ZLK-AllStar/2026GongChuang/上位机联动说明.md

# 下位机与上位机联动说明

更新：2026-10-30。固件采用 CoreXY 与六槽单方向托盘，视觉上位机 Python、标定、服务脚本、重试与超时保持原样。

## 接线与启动

| 用途 | 接口 | 参数 |
|---|---|---|
| 视觉上位机 | USART2 PA2=TX / PA3=RX | 115200 8N1，共地，TX/RX 交叉 |
| 三台 Emm_V5 电机 | USART1 PA9/PA10 | 保留本工程 DMA+IDLE，地址 1/2 为 M1/M2，3 为托盘 |
| ApusIDE HMI | USART3 PB10=TX / PB11=RX | 115200 8N1，屏端 COM2 |
| 调试 Shell | UART5 PC12=TX / PD2=RX | 115200 8N1，仅 DEBUG |
| 按键 | PE2 与 GND 之间 | 上拉、低电平按下，5 ms 采样 / 20 ms 消抖 |
| LED | PF9=LED0 / PF10=LED1 | 低电平亮 |

上电后 LED0 快闪完整 3 秒。窗口内消抖确认按下选 DEBUG，否则选 HOST；上电长按同样有效，窗口末不足 20 ms 不生效，模式锁定至复位。选择完成后才进行屏幕/舵机/电机初始化。XY 与托盘的当前机械位置建立为软件原点，不找限位、不主动回机械原点。初始化失败保留明确故障，HOST 拒绝机械任务，DEBUG 仍可诊断。

HOST 模式 LED0 常亮，须在初始化后先稳定释放 PE2，再新按一次才向上位机发 PRESS。窗口内或初始化期间的按住不伪造成生产启动键。DEBUG 模式 LED1 常亮，不初始化 HOST 触发流程，不接受 HOST 机械任务。首次 PE2 启动后保持连续识别，运行中再按不切换模式。

## 原 USART2 字节协议

| 方向/消息 | 固定格式 |
|---|---|
| HOST 抓取 | AA 55 01 SEQ CMD X_L X_H Y_L Y_H SUM8 |
| HOST 启动/心跳 | AA 55 02 00 01 SUM8 |
| MCU 在线 | 55 AA 02 00 01 SUM8 |
| MCU 按键 | 55 AA 82 SEQ STATE SUM8 |
| MCU 状态 | 55 AA 81 SEQ STATUS SUM8 |

SUM8 为前面所有字节求和低 8 位；X/Y 为 uint16 小端毫米。PRESS=1、RELEASE=0，与按键硬件电平相互独立。状态保持 ACK=1、BUSY=2、DONE=3、FAILED=4、OUT_OF_RANGE=5。CMD 的原九色仍为 shape_index*9+color_index+1（1..72）；白色 color_index=9 独立编码为 73+shape_index（73..80），圆锥shape_index=8独立编码为81+color_index（81..90），整体有效范围1..90。

启动通知仅更新在线提示，不放行运动。HOST 每秒发送原通知，MCU 等通知时每秒发送在线帧，5 秒未收到有效 HOST 帧显示离线。正常空闲提示从 WAIT PC 变成 WAIT BUTTON；故障优先显示。Jetson ACK 超时 1 秒、一次重发、完整动作超时 24 秒；固件任务预算从 ACK 起为 24000 ms（包含回 HOME）。

## 执行、分类与故障

固件检查 CMD、X=0..215 / Y=0..205 mm、原点/配置与完整任务键。上位机坐标直接使用，没有旧的 X/Y 同大于 80 时各减 10 mm 分支。

合法任务先 ACK，code 首次出现分配 ID1..6，下一新类循环 ID1；同类记住原 ID，失败也不回退映射，复位清空。ID1..6 对应托盘 0/60/120/180/240/300°。固定单方向，300→0 继续转 60°，0→300 不反转。

顺序为：抬杯 → 托盘到位 → CoreXY 到原始抓取坐标 → 按形状降低并吸取 → 抬杯 → 固定 Release → 保持抬杯释放 → HMI 分类记录 → HOME 停靠 → DONE。Release 和 HOME 在 app_config.h 中分别配置，初值都为 (0,0)。长方体降低到 FULL，其他形状普通 DOWN；保留当前舵机和真空等待时间。

仅保存活动任务和最近终态，以 (SEQ,CMD,X_raw,Y_raw) 去重。活动同任务回 BUSY，活动期间不同任务回 FAILED，不排队；最近已完成同任务只补终态。SEQ 回绕后内容不同可作为新任务，不重复分配、抓取或追加 HMI。

HOST 解析在等待点继续服务，接收环 256 字节，溢出计数并清理残帧。总体超时由拥有电机事务的前台停止两组电机、使原点失效并发 FAILED，服务钩子不重入电机总线。托盘失败不继续吸取；取料后 XY 故障不盲目泄压。已释放后的停靠失败仍保留 HMI 记录，但返回 FAILED。HMI 本地发送失败只记通信错误，不重做机械动作。

## HMI 与调试

ST7789 只显示模式/任务/位置/原点/真空/托盘/通信诊断。指定 ApusIDE HMI 承担分类图片和 ID 历史，原 72 码映射不变，追加原8形状白色73..80与圆锥10色81..90（docs/圆锥系列几何体映射.md）；详见 docs/下位机白色几何体映射.md。生产使用带 CRC 的 22 字节帧，单字节仅调试预览；两端须同步升级，无 ACK、无掉线补发或断电历史恢复。详见屏幕联动说明.md。

UART5 命令及首次标定步骤见 docs/调试与首次上机.md。上位机服务入口仍为 classic-new/scripts/run_vision.sh；手动调试 `scripts/run_vision.sh --debug`，日志 `journalctl -u huatai-vision -f`。保持原摄像头、标定与 systemd 配置。

构建、自动测试和实机待测边界见 docs/机械架构变更验证记录.md。

## 2026-11-08 识别选择与工作空间

Jetson 实际运行脚本为 `/home/jetson/classic/cv2_copy.py`，本地同步副本为 `上位机脚本/cv2_copy.py`。每轮从有效、未处于失败冷却的目标中，按长方体 > 正方体 > 五棱柱 > 圆柱 > 圆锥 > 三棱锥选择；三棱锥对应协议条目 `regular_tetrahedron`。同类继续比较空旷度和移动距离，稳定后发送单个目标，等待 DONE 再识别。

上位机筛选、HOST 校验、CoreXY 运动和 DEBUG Shell 均采用 X=0..215 mm、Y=0..205 mm，包含边界。上位机像素转机械坐标时，若有限的 Y 超过 `MACHINE_Y_MAX_MM=205.0`，直接输出 205 mm；目标显示、筛选、锁定和发送使用限幅值，串口封包也做上限保护。X 越界、负坐标与非有限值仍按原有效性规则处理；下位机直接收到 Y>205 的任务仍返回 OUT_OF_RANGE。抓取帧仍为原 10 字节格式，形状/颜色指令编号不变。

圆柱系列所有颜色（CMD 37..45 和白色 77）取料时单独下降到 130°，由 `AUX_SERVO_LIFT_DOWN_ANGLE_CYLINDER` 配置；下降成功后才启动吸取，再抬杯。其他物料的下降预设及当前释放动作保持各自配置。
