ZLK-AllStar/2026GongChuang/docs/Y205上限与限幅验证记录.md

# Y=205 mm 上限与上位机限幅

日期：2026-11-09。

- 固件 `XY_STAGE_Y_MAX_MM` 从 225 改为 205；HOST、Release/HOME 配置检查、CoreXY 绝对/相对运动与 DEBUG Shell 共用此宏，Shell 提示同步为 X=0..215 / Y=0..205 mm。
- 主上位机和本地、Jetson 备用识别脚本使用 `MACHINE_Y_MAX_MM=205.0`。像素转换校验有限值后，将 Y>205 截为 205；显示、选择、锁定、发送和重发使用限幅坐标。封包在取整前再次保护上限；下位机直接收到 Y>205 的帧仍返回 OUT_OF_RANGE。
- 主脚本本地、Jetson 暂存和已安装版本均通过 1684 项检查，覆盖原优先级/24秒/90码映射及 Y=205/205.01/206/225/超uint16/非有限值。实际 process_frame → 稳定目标 → 模拟串口 → 重发，验证原始 Y=206 输出为 205。备用脚本实际转换/封包函数检查通过。
- 机械回归全部通过：HOST 11 场景、全90码/圆柱130°、Shell边界、2889 项 CoreXY 检查、软件串口与指定 HMI 解析器。新角点 (215,205) 对应 M1=33600、M2=800 脉冲，Y=205.01/206/旧225均拒绝。备用上位机按键回归全部通过。
- Jetson 备份：`/home/jetson/classic/backups/20261109-y205-1794206890918033800`。主脚本 SHA256=`3ec681482ae8ee624fa419e9d74c513a9358105c821c5555b2177fa450e5313e`。部署前核对旧脚本哈希，暂存检查通过后停止服务、替换、验证并重启。
- 部署后服务 active/running，PID=5633、NRestarts=0；日志确认模型、标定和串口加载完成，处于 WAIT_BUTTON。标定和 ROI 的 SHA256 在部署及重启后保持一致，证据位于 `MDK-ARM/MechanicalVerify/y205-20261109/`。
- 固件**未烧录**，未触发机械运动或清零。STM32 新上限须烧录后生效；Release=(215,105)、HOME=(0,0)、24秒预算与圆柱130°预设保留。

Keil ARMCC 5.06 update 7 build 960，target HUATAI，全量重建结果：

- BUILD_RESULT: SUCCESS
- ERROR_COUNT: 0
- WARNING_COUNT: 0
- ERRORS: none
- WARNINGS: none
- FULL_LOG: `MDK-ARM/build_y205_20261109.log`

固件：`MDK-ARM/HUATAI/HUATAI.hex`。
SHA256：`71c124b0e8f5c35366cf40759e51c5c1d44b46038900be3671b0a415e44d715f`。
