ZLK-AllStar/2026GongChuang/docs/下位机白色几何体映射.md

# 下位机白色几何体与 HMI 映射

日期：2026-11-08。
目标 HMI：`D:/BaiduNetdiskDownload/ApusIDE2_v20250930/ApusIDE2_v20250930/workspace/TEST`。

### 白色追加码（2026-11-08）

白色的 color_index=9；编码使用独立追加区 `code=73+shape_index`。
原有 1..72 的九色公式保持不变，不能把原公式中的乘数 9 改为 10。

| 十进制 code | 十六进制字节 | 形状 | 图片路径 |
|---|---|---|---|
| 73 | 0x49 | 正四面体 | ./images/RT-WHITE.png |
| 74 | 0x4A | 三棱柱 | ./images/TP-WHITE.png |
| 75 | 0x4B | 五棱柱 | ./images/PP-WHITE.png |
| 76 | 0x4C | 六棱柱 | ./images/HP-WHITE.png |
| 77 | 0x4D | 圆柱形 | ./images/CY-WHITE.png |
| 78 | 0x4E | 长方体 | ./images/CB-WHITE.png |
| 79 | 0x4F | 正方体 | ./images/CU-WHITE.png |
| 80 | 0x50 | 球体 | ./images/SP-WHITE.png |

新增 PNG 均为 400×400、RGB、不透明黑底、白色带明暗立面；从原 GRAY 资源派生，保留形状轮廓与方向。
可查看工程根目录 `白色几何体预览.png` 与 `白色几何体映射.csv`。
MCU `Core/Inc/hmi_codes.h` 和 HMI `src/hmi_codes.h` 为相同映射实现，回归会核对字节一致。

白色同时支持单字节预览与原 22 字节生产帧的 D6 字段；版本、帧长、CRC、ID1..ID6 循环和记录去重规则不变。
HOST 的 CMD 也接受 73..80；视觉识别 Python 本次未修改，发送端识别白色后须按追加表发码。

## 联调与交付

DEBUG Shell 使用十进制 `hmi 73` 至 `hmi 80`，仅预览，不产生机械动作或生产记录。
串口助手使用 HEX 单字节 `49` 至 `50`，不要把十进制 73 输入为 HEX 73。

生成白色生产记录测试帧（不指定 --port 时不发送）：

```powershell
python -X utf8 tools/hmi_frame_test.py --record 73 1 --seq 1
python -X utf8 tools/hmi_frame_test.py --record 80 2 --seq 2
python -X utf8 tools/make_hmi_white.py
```

HMI 源码、8 张新 PNG、预览图与 CSV 已写入指定工程。ARM 库与 Windows 模拟器 DLL 编译通过后同步至该工程的 `Release/libbootpanel.so`、`Debug/libbootpanel.dll`；板端尚未部署。
升级屏端需同时打包库和 `images/*-WHITE.png`；MCU 也需更新固件以支持 HOST/Shell/记录的 73..80。
ApusIDE 中对工程执行 F5 刷新，再 Clean / Build，避免外部修改后复用旧对象。

## 验证结果

- 实际 MCU 编码与 HMI 解析：80 种形状颜色逐一双向映射、旧 72 码不变，白色预览/生产帧可解析，0/81 非法码被拒绝。
- 实际 HOST 解析/任务控制：八种白色可进入任务并发出正确记录；重复任务不重做动作，80 类 ID 分配和重查通过。
- Shell：73/80 预览可发送，81 被拒绝；原输入损坏与 busy 保护通过。
- 实际 Wcmn 方法体：八种白色状态、颜色文字、UI 线程边界及非法帧回归通过。
- 八张 PNG：400×400、不透明 RGB、四角黑色；原图片 SHA256 与修改前快照逐一相同。
- `python -X utf8 tools/selftest_mechanical.py`、`python -X utf8 tools/selftest_hmi_worker.py` 通过。
- HMI ARM 和 Windows 模拟器 DLL 编译链接通过。
- Keil ARMCC 5.06 update 7 build 960 全量重建：0 Error(s), 0 Warning(s)。
- 尚待屏端实测：USART3/COM2 接收、黑底白色显示和实际部署后的 8 码逐一预览。

构建日志：`MDK-ARM/MechanicalVerify/white_series_fw_rebuild.log` 与 `MDK-ARM/MechanicalVerify/hmi_arm/build.log`。
修改前备份：`MDK-ARM/MechanicalVerify/white_series_backup/20261108-102422/`。
