ZLK-AllStar/2026GongChuang/docs/机械架构变更验证记录.md

# 机械架构变更验证记录

日期：2026-10-30（Asia/Shanghai）。状态：固件/指定 HMI 已实现；构建和离线模拟通过，实机验收未执行。未烧录、未部署、未创建提交。

## 构建结果

| 项目 | 真实结果 |
|---|---|
| Keil 工程/target | MDK-ARM/HUATAI.uvprojx / HUATAI |
| 编译器 | ARMCC 5.06 update 7 build 960，uAC6=0，C99 |
| 最终全量命令 | D:/Keil_v5/UV4/UV4.exe -r <FW>/MDK-ARM/HUATAI.uvprojx -t HUATAI -j0 -o <FW>/MDK-ARM/build_mechanical_migration.log |
| BUILD_RESULT | SUCCESS |
| ERROR_COUNT / WARNING_COUNT | 0 / 0（无遗留诊断） |
| ERRORS / WARNINGS | 无 / 无 |
| FULL_LOG | C:/Users/ZLK/Downloads/HUATAI (1)/HUATAI-NEW/MDK-ARM/build_mechanical_migration.log |
| Code/RO/RW/ZI | 47408 / 2848 / 412 / 88716 字节 |
| IRAM1 | 89128 / 114688 字节，余 25560 字节 |
| IRAM2 | 16384 字节未用 |
| 栈/堆 | 4096 / 512 字节 |
| TFT_FrameBuffer | 内部普通 SRAM，76800 字节 |
| DMA RX / RX Queue | 0x20013EEB / 0x20013FEA，255 / 2040 字节，未移入 CCM |
| Shell 编辑/历史缓冲 | 512 字节；5 历史+1 编辑槽，每槽85字节，单行最多84字节 |
| HMI 指定工程 | D:/BaiduNetdiskDownload/ApusIDE2_v20250930/ApusIDE2_v20250930/workspace/TEST |
| HMI 编译器 | Linaro arm-linux-gnueabihf-g++ 6.3.1，-O3 -fPIC -std=c++11 -Wall |
| HMI 链接 | 四个应用 cpp 全部编译，libstt_core + pthread/dl/stdc++，0错误/0警告 |
| HMI 输出 | MDK-ARM/MechanicalVerify/hmi_arm/libbootpanel.so，readelf 确认 ELF32/ARM/EABI5/hard-float/DYN |
| HMI FULL_LOG | MDK-ARM/MechanicalVerify/hmi_arm/build.log |

Keil 最后一次全量重建包含 Shell busy/idle 与 HOST damaged-ring 状态的短临界区修复。以新日志最终汇总和链接 map 为证据，不用 GUI 进程返回码。静态调用图最大已知链为 792 字节，但有函数指针/循环及中断未知项；4 KB 栈预留尚需板上高水位验证，不能当作动态最坏栈证明。

本地启动汇编只调整可配置 Stack_Size 0x400→0x1000；这是为 Shell/诊断扩大应用栈预留的适配，没有迁移 REF 启动代码或改变向量/复位逻辑。生成 C/H 的非 USER CODE 区逐字比对一致，.ioc 不变，未运行 CubeMX。classic-new 只改 SERIAL_PROTOCOL.md，Python、标定和服务脚本无 diff。

## 自动化结果

`python -X utf8 tools/selftest_mechanical.py`：ALL MECHANICAL REGRESSIONS PASSED，实际包含/编译最终 FW C，HMI 使用指定工程 src/HmiRecord.h（不是仓库 TEST/ 副本）。

| 组 | 覆盖与结果 |
|---|---|
| CoreXY | PASS 2435 checks：表中脉冲值、负M2、绝对零、相对移动/45°保持轴、NaN/Inf/边界/取整、双反馈原子提交、清零拒绝/无ACK/偏移、旧到位包、堵转、读失败、同步启动失败 |
| 启动/按键 | PASS：不按/短按/上电长按、抖动、3秒边界不足20ms无效、稳定释放、tick回绕 |
| 托盘 | PASS：0→300/300→0/120→60、同角/360不动、100圈六步累计无取整漂移、非法角、反向反馈、旧到位ACK、堵转/超时/失配/读失败、任务预算、清零拒绝、反馈字段溢出前拒绝 |
| HOST 0 | PASS：未新按键不运动，非法CMD/CRC/范围不分配、原帧/状态值、先ACK、原坐标100/100不偏移、先托盘后拾取、固定Release、六ID循环/旧类记忆、SEQ回绕、RX溢出恢复 |
| HOST 1 | PASS：活动同任务只BUSY、不同任务FAILED、最终重发无重复动作/记录 |
| HOST 2 | PASS：托盘失败不抓取，映射保留 |
| HOST 3 | PASS：释放后停靠失败FAILED但HMI记录保留 |
| HOST 4 | PASS：整体预算超时、前台停止、两组原点失效 |
| HOST 5 | PASS：ACK本地发送失败，重发不重复机械动作 |
| HOST 6/7 | PASS：DEBUG不放行HOST、24秒预算tick回绕 |
| HOST 8 | PASS：模拟三段运动中持续心跳，无RX静默溢出 |
| HOST 9 | PASS：HMI发送失败计数，真实机械DONE，不重抓/重记录 |
| HMI | PASS：MCU实际编码+HMI实际解析、CRC123456789、指定22字节样例、首尾code/ID、全部拆包点、连续/重复类顺序、坏CRC/编码/版本/type/字段、噪声、半帧超时、预览独立、tick回绕 |
| Shell | PASS：实际Letter Shell/命令/端口；argc、数字完整消费、NaN/Inf/范围、十进制HMI、84字节上限整行丢弃、RX溢出、忙时输入不延后执行、UART恢复、HOST禁止动作 |

`python -X utf8 tools/selftest_host_link.py` 为兼容入口，执行当前真实 parser/controller/pick_place，不再提取旧 main HOST 分支。`python classic-new/scripts/selftest_button_logic.py` 原样回归：ALL CHECKS PASSED。

CoreXY 附带 ARMCC/Unicorn 脚本能完成 ARMCC 编译链接，但当前 Python 无 unicorn，未安装依赖、未宣称 Unicorn 运行通过；本次 2435 checks 来自 GCC 原生执行最终 C。Shell 原生 MinGW 回归用 -mno-ms-bitfields 对齐 ARMCC/GCC 位域布局；实际 ARMCC 工程静态表另经全量构建验证。离线 mock 不模拟真实 UART DMA 中断竞争、皮带动力学或电机加减速。

HMI 解析顺序有自动覆盖；真实框架 UI onFinished 线程、页面重开/clearOptions、256条淘汰和图片呈现只完成源码核对和 ARM 构建，未运行真实屏端。不得将这些描述为实机UI通过。

## 最终参数与未实测项

| 项目 | 配置 / 实机状态 |
|---|---|
| CoreXY | 80pulse/mm，0..215/0..205mm；M1/M2正向=1，待核实安装方向/实际每mm |
| 托盘 | 地址3，3200pulse/rev，65536units/rev，传动比1.0，正向=1，20pulse容差；待核实额外传动比、观察面方向、零槽/余量 |
| Release/HOME | 独立宏初值(0,0)/(0,0)，待核实固定释放点和高度 |
| 真空/升降 | TIM1/TIM3，50Hz；吸取1500ms、泄压2000ms、升降1000ms不缩短，待核实实物安全时序 |
| GPIO/模式 | PE2上拉低有效，PF9/PF10低有效，窗口3000ms、半周期100ms；待电平/示波测量 |
| HOST时限 | 24000ms预算，上位机完成等待24秒；正常ACK<100ms及完整周期<24s尚待串口抓包测量 |
| HMI | 22字节CRC，无ACK/重发/补历史/持久化；待双端部署与实屏联调 |
| 栈与连续负载 | 4KB；待高水位、最坏中断嵌套、持续识别和错误注入实测 |

实机矩阵全部待测：LED/PE2/UART5接线；启动边界；DEBUG电机断线诊断；低速XY三方向/比例；托盘六槽多圈/单方向；lift/vacuum/释放高度；HMI预览与记录/重开/淘汰；HOST七类/去重；断线/超时/无假DONE；ACK和总周期耗时。步骤见调试与首次上机.md。未连接硬件，未烧录或部署。

## 审查与文件归属

新增应用：app_config、board_io、app_mode、app_runtime、classification、app_controller、shell_port、shell_commands、hmi_protocol；改造xy_stage/tray_motor/pick_place/vacuum/aux_servo/host_link/hmi_link/app_display/button。main仅保留初始化和HOST/DEBUG入口，移除旧盒坐标/遍历/65mm往返活动分支。Keil加入7个应用c和shell.c/shell_ext.c，唯一静态命令表在shell_commands.c。

实际生效配置为 letter-shell-3.1.2/src/shell_cfg.h：TASK_WHILE=0、CMD_EXPORT=0、MAX_NUMBER=1、GET_TICK=HAL_GetTick、PARAMETER_MAX=8、PRINT_BUFFER=128，exec/伴生/锁/动态分配扩展关闭。未编译原shell_cmd_list.c或FreeRTOS demo；保留本地许可证。

HMI原文件快照：MDK-ARM/MechanicalVerify/hmi_baseline/；指定HMI只改应用源/头和新增说明，不改lib/、图片和createParts。FW已有未跟踪TEST/、图片、IDE文件、旧日志与Shell目录未清理；本轮未提交。构建产物与新日志均忽略。

## 2026-11-08 识别优先级与 X=215 mm 边界

- Jetson 交付脚本：`/home/jetson/classic/cv2_copy.py`；本地同字节副本：`上位机脚本/cv2_copy.py`。SHA256：`706fc36f31cb7c42d74c4d9c05db19358131a81c436f41bd53faa47b255c8a93`。
- 原脚本及自测备份：`/home/jetson/classic/backups/20261108-x215-priority-180509/`。
- 优先级：长方体 > 正方体 > 圆柱 > 五棱柱 > 圆锥 > 三棱锥（协议 `regular_tetrahedron`）。先过滤无效/越界/失败冷却目标，再按形状排序，同类沿用几何评分。10 字节抓取帧和原 90 个指令映射不变。
- 上位机、HOST、CoreXY、Shell 均接受 X=215 mm；拒绝 X=215.01 mm（浮点入口）/216 mm（整数串口入口）；Y 上限仍为 225 mm。
- `python -X utf8 tools/selftest_cv2_copy.py`：本地通过 1653 项；在 Jetson 的 `yolov8_env` 中对已安装脚本运行相同自测亦通过。覆盖红/白两色的各 720 个目标排列、全部六级优先级、连续六轮真实状态机/模拟 UART 下发、X=215 保真、失败冷却、同类几何评分和旧协议/按键/超时回归。
- `python -X utf8 tools/selftest_mechanical.py`：所有组通过，包含 HOST 十场景、Shell 新边界和 3151 项 CoreXY 检查；HMI 采用指定外部交付工程的解析器。
- `python classic-new/scripts/selftest_button_logic.py`：全部通过。
- Keil ARMCC 5.06 update 7 build 960，target HUATAI，`-r` 全量重建；成功链接并生成 `MDK-ARM/HUATAI/HUATAI.hex`。

```text
BUILD_RESULT: SUCCESS
ERROR_COUNT: 0
WARNING_COUNT: 0
ERRORS: none
WARNINGS: none
FULL_LOG: MDK-ARM/build_x215_priority_20261108.log
```

上述测试使用模拟 UART/HAL，未驱动实机运动；新固件尚未烧录到 STM32，实际 215 mm 行程仍需烧录后验收。

Jetson 已重启 `huatai-vision.service` 并核对新进程：PID=10660，active/running，NRestarts=0；日志确认权重、标定、USART 和 ROI 加载完成，停在 WAIT_BUTTON，未触发实机抓取。

## 2026-11-08 全链路整任务超时统一为 24 秒

- 固件 `APP_HOST_TASK_BUDGET_MS=24000U`，覆盖从 ACK 前建立任务到回 HOME 完成的整个周期；Release `(215,105)`、HOME `(0,0)` 和现有机械等待保持当前配置。
- Jetson `/home/jetson/classic/cv2_copy.py` 的 `--pick-timeout` 默认 `24.0`；同目录 `_cv2.py` 备用入口、本地三个识别脚本的默认值同步为 24 秒。1 秒 ACK 超时、一次重发及电机/UART 单事务检测维持原配置。
- Jetson 更新前备份：`/home/jetson/classic/backups/20261108-timeout24-195106/`。
- 主识别脚本 SHA256：`71cdb66d76821b127b05cb18e414a5a3f04fe7d5ba1d93984b1c68164e5303c4`；远端部署前后均通过 1659 项模拟 UART 自测，覆盖 18/20/23.999 秒仍等待、24 秒超时、边界已排队 DONE 优先处理、优先级和 X=215 边界。
- `tools/selftest_mechanical.py` 所有组通过：HOST 扩展至 11 个场景，验证超过 23 秒仍可完成、24 秒硬截止、tick 回绕和既有错误/去重/原点保护。CoreXY 3151 项通过。
- `classic-new/scripts/selftest_button_logic.py` 全部通过。
- 使用 ARMCC 5.06 update 7 build 960 对 HUATAI 全量重建并成功链接、生成 HEX。

```text
BUILD_RESULT: SUCCESS
ERROR_COUNT: 0
WARNING_COUNT: 0
ERRORS: none
WARNINGS: none
FULL_LOG: MDK-ARM/build_timeout24_20261108.log
```

固件产物为 `MDK-ARM/HUATAI/HUATAI.hex`，尚未烧录；新 24 秒完整机械周期仍需实机验收。已存在的原点失效状态需要正确重新建立，修改等待时间不会恢复机械原点。

Jetson 已重启 `huatai-vision.service`：PID=8000，active/running，NRestarts=0。按运行进程实际命令行解析得到 `pick_timeout=24.0`，模型、标定、USART、ROI 已就绪，等待 PE2。HEX SHA256：`3c455b5daf8c736f83f3279db7aea2d121884b27082655d4e94502d4cb8375c3`。

## 2026-11-08 五棱柱/圆柱优先级与圆柱 130° 取料

- 当前识别选择顺序：长方体 > 正方体 > 五棱柱 > 圆柱 > 圆锥 > 三棱锥。仅交换五棱柱与圆柱的抓取优先级；串口/HMI 形状编号仍按原表。
- Jetson 主脚本 `/home/jetson/classic/cv2_copy.py` 与本地 `上位机脚本/cv2_copy.py` 同步；SHA256：`245e131e170c86c9707e36818286db18488c4afedd114d8793c529251a7a6e18`。
- 远端原脚本与自测备份：`/home/jetson/classic/backups/20261108-cylinder130-priority-211239/`。
- 新增 `AUX_SERVO_LIFT_DOWN_ANGLE_CYLINDER=130U`，`PickPlace_LowerCup()` 按 `HMI_SHAPE_CYLINDER` 调用 `AuxServo_LiftTo()`，覆盖全部圆柱颜色（CMD 37..45、白色 77）。普通/FULL 当前仍为 100°，抬杯 270°、稳定等待 1000 ms、释放动作、X=215 和 24 秒预算保留当前配置。
- `tools/selftest_cv2_copy.py` 本地及 Jetson 暂存/已安装脚本均通过 1659 项：红/白两组各 720 个排列、逐级选择、连续六轮实际状态机/模拟 UART，24 秒与 X=215 边界。
- `tools/selftest_mechanical.py` 全部通过：真实 HOST 解析/控制器/拾放对 90 个指令码逐一执行并检查下降角度；全部十色圆柱均为 130°，重复帧不重做，下降失败不启动吸取/不产生释放记录。真实舵机实现验证 130° -> CCR=1462（1 us/tick），保持稳定等待、角度缓存与再抬杯。其余 HOST/Shell/CoreXY/HMI 回归通过。
- ARMCC 5.06 update 7 build 960，HUATAI 全量重建，成功链接并生成 HEX。

```text
BUILD_RESULT: SUCCESS
ERROR_COUNT: 0
WARNING_COUNT: 0
ERRORS: none
WARNINGS: none
FULL_LOG: MDK-ARM/build_cylinder130_priority_20261108.log
```

`MDK-ARM/HUATAI/HUATAI.hex` SHA256：`4c9af6ba2bf8d0d0141a0473dbb5f921a8c03173ee03ff6e653c262d6ef003e2`。尚未烧录；130° 的实机接触高度与吸取效果待验证，模拟测试不代表机械验收。

Jetson 服务已重启：PID=12676，active/running，NRestarts=0，日志确认模型、标定、USART 和 ROI 已加载，当前 WAIT_BUTTON。导入部署脚本验证完整新优先级、24 秒完成等待和 X=215 上限。
