ZLK-AllStar/2026GongChuang/屏幕系统说明.md

# ST7789 调试屏系统

更新：2026-10-30。ST7789 横向 320×240 RGB565 只显示调试信息；分类图形和生产历史由 USART3 ApusIDE HMI 显示。本地不再有活动几何列表入口，也不从 HMI_SendCode 驱动本地几何绘制。

## 硬件与缓冲

SPI1：PA5=SCK、PA7=MOSI；PF12=DC、PB12=BLK、PB13=CS、PB15=RST。PA6 是 TIM3 升降 PWM，不能接为屏幕 MISO。背光高有效。保持阻塞 HAL_SPI_Transmit，不使用 DMA。

Core/Src/ext_sram.c 保留历史文件名，但 TFT_FrameBuffer 实际位于内部 SRAM，320×120×2=76800 字节；ExtSram_Init 是空实现。SCREEN_FSMC_ENABLE=0，不配置外部 SRAM/FSMC，PE2 不与 FSMC_A2 冲突。

每次按 y=0..119、120..239 两块视口绘制并刷新全屏。ST7789 硬复位后配置 SWRESET、SLPOUT、RGB565、MADCTL=0xA0（相对原 0x60 横屏旋转 180°）、INVERT ON、DISPON；由应用 Screen/TFT 驱动负责，不改 CubeMX 或 .ioc。Screen_Write/Screen_SetWriteBackend 仍为传输抽象接口。

## 调试页面与服务

SCREEN_PAGE_SELECT 固定 0。显示 HOST/DEBUG、当前动作/故障、XY 实际/目标、原始 HOST SEQ/CMD/X/Y、真空状态、托盘相位与 ID、XY/托盘原点有效性、HOST 在线、HMI 错误数及升降角。

setters 仅更新有界缓存并标记 dirty，命令和状态字符串内部复制；栈上临时字符串可以安全传入。AppDisplay_Service 至少间隔 APP_DISPLAY_PERIOD_MS=100 ms 才刷新；没有主动 dirty 时每 500 ms 更新诊断。初始化检查及服务防重入支持早期模式选择和阻塞等待。

HAL_Delay 只有 app_display.c 一个强定义，调用 AppRuntime_Service。该服务仅解析/回复 HOST 和刷新显示，不执行 Shell 或启动第二个运动任务。SysTick 使用 HAL 1 ms，TIM13 不启动。

## 分类素材与验证

本地 geometry_assets/tft 绘图工具保留，但调试页不使用几何素材。历史离线转换命令仍是 `python tools/assets_to_flash.py`，来源为仓库 TEST/images；它不是本次指定 HMI 工程，也不应作为 HMI 修改交付。

指定 HMI：D:/BaiduNetdiskDownload/ApusIDE2_v20250930/ApusIDE2_v20250930/workspace/TEST，USART3 PB10/PB11，115200 8N1。完整预览/分类帧见屏幕联动说明.md 和该 HMI 的通信与分类显示说明.md。

TIM1_CH1/CH2 控制真空泵/阀，TIM3_CH1 控制升降；不要再按旧 TIM2 真空说明接线。构建与 SRAM/栈核对见 docs/机械架构变更验证记录.md。屏幕实际显示、接线和刷新占用尚待实机验收。
