ZLK-AllStar/2026GongChuang/屏幕联动说明.md

# 调试屏与分类 HMI 联动

更新：2026-11-08。ST7789 只作调试；指定 ApusIDE HMI 在 USART3 上显示分类图片与生产 ID。USART3 PB10=TX、PB11=RX，对接 HMI COM2，115200 8N1；本轮不增加 HMI 回传 ACK。

## 不变的 72 码

code=shape_index×9+color_index+1。颜色依次红、橙、黄、绿、青、蓝、紫、灰、黑。

| 范围 | 形状 | 图片前缀 |
|---|---|---|
| 1..9 | 正四面体 | RT |
| 10..18 | 三棱柱 | TP |
| 19..27 | 五棱柱 | PP |
| 28..36 | 六棱柱 | HP |
| 37..45 | 圆柱形 | CY |
| 46..54 | 长方体 | CB |
| 55..63 | 正方体 | CU |
| 64..72 | 球体 | SP |

保留 ./images/<shape>-<color>.png 路径。单字节 0x01..0x5A 现在只用于调试预览：显示图片/文字及“调试预览 / 无生产 ID”，不追加生产 history、不分配分类 ID、不消耗记录序号。Shell `hmi 19` 发一个 0x13 字节。

### 白色追加码（2026-11-08）

白色的 color_index=9；编码使用独立追加区 `code=73+shape_index`。
原有 1..72 的九色公式保持不变，不能把原公式中的乘数 9 改为 10。

| 十进制 code | 十六进制字节 | 形状 | 图片路径 |
|---|---|---|---|
| 73 | 0x49 | 正四面体 | ./images/RT-WHITE.png |
| 74 | 0x4A | 三棱柱 | ./images/TP-WHITE.png |
| 75 | 0x4B | 五棱柱 | ./images/PP-WHITE.png |
| 76 | 0x4C | 六棱柱 | ./images/HP-WHITE.png |
| 77 | 0x4D | 圆柱形 | ./images/CY-WHITE.png |
| 78 | 0x4E | 长方体 | ./images/CB-WHITE.png |
| 79 | 0x4F | 正方体 | ./images/CU-WHITE.png |
| 80 | 0x50 | 球体 | ./images/SP-WHITE.png |

新增 PNG 均为 400×400、RGB、不透明黑底、白色带明暗立面；从原 GRAY 资源派生，保留形状轮廓与方向。
可查看工程根目录 `白色几何体预览.png` 与 `白色几何体映射.csv`。
MCU `Core/Inc/hmi_codes.h` 和 HMI `src/hmi_codes.h` 为相同映射实现，回归会核对字节一致。

白色同时支持单字节预览与原 22 字节生产帧的 D6 字段；版本、帧长、CRC、ID1..ID6 循环和记录去重规则不变。
HOST 的 CMD 也接受 73..80；视觉识别 Python 本次未修改，发送端识别白色后须按追加表发码。

## 圆锥追加码（2026-11-08）

圆锥的 shape_index=8；新增 code=81+color_index，颜色偏移0..9依次红、橙、黄、绿、青、蓝、紫、灰、黑、白。
已有1..72九色码与73..80原8形状白色码全部保持原值。

| 十进制 code | HEX字节 | 颜色 | 图片路径 |
|---|---|---|---|
| 81 | 0x51 | 红 | ./images/CO-RED.png |
| 82 | 0x52 | 橙 | ./images/CO-ORANGE.png |
| 83 | 0x53 | 黄 | ./images/CO-YELLOW.png |
| 84 | 0x54 | 绿 | ./images/CO-GREEN.png |
| 85 | 0x55 | 青 | ./images/CO-CYAN.png |
| 86 | 0x56 | 蓝 | ./images/CO-BLUE.png |
| 87 | 0x57 | 紫 | ./images/CO-PURPLE.png |
| 88 | 0x58 | 灰 | ./images/CO-GRAY.png |
| 89 | 0x59 | 黑 | ./images/CO-BLACK.png |
| 90 | 0x5A | 白 | ./images/CO-WHITE.png |

10张圆锥图片均为400×400、RGB不透明PNG，白色圆锥黑底，其余颜色白底，几何轮廓与明暗由 `tools/make_hmi_cone.py` 确定性生成。
工程根目录 `圆锥系列映射.csv` 可供发送端查表，`圆锥系列预览.png` 为全部10色对照图。

## 新分类帧

固定 22 字节：F0，10 个数据字节各拆为高/低半字节并编码为 0x80|n，F1。中间 20 字节全部为 0x80..0x8F，旧屏不会把元数据当 1..72 指令。

| 解码字节 | 字段 |
|---|---|
| D0 | version=1 |
| D1 | type=1 分类完成记录，type=2 新会话清空 |
| D2..D5 | uint32 小端 record_sequence；type1 从 1 递增，type2 为 0 |
| D6 | code 1..90；type2 为 0 |
| D7 | 固件 ID 1..6；type2 为 0 |
| D8..D9 | D0..D7 的 CRC16/CCITT-FALSE，低字节先发 |

CRC：poly=0x1021、init=0xFFFF、refin/refout=false、xorout=0；ASCII 123456789 校核为 0x29B1。

seq=1/code=19/ID=3 完整示例：

```text
F0 80 81 80 81 80 81 80 80 80 80 80 80 81 83 80 83 86 8F 8E 8D F1
```

新会话：

```text
F0 80 81 80 82 80 80 80 80 80 80 80 80 80 80 80 80 80 8E 81 86 F1
```

HOST 初始化发送一次 type2；DEBUG 不主动清历史。type1 仅在释放流程成功完成后发送一次；上位机重发只补状态，不重发 HMI。记录已发送后停靠失败，记录保留而 HOST 收 FAILED。

## 同类总数（2026-11-08）

分类记录行末显示相同形状＋颜色的本次会话累计总数，以code分别计数，共90类（含白色及圆锥10色）。生产type1记录加1，预览不计数；所有同类历史行显示当前累计值。计数独立于256条可见历史，淘汰/刷新/重开不减不增，新会话type2与HMI重启清零。部署需更新库及 `images/HDR-RECORDS.png` 表头图。详见 `docs/HMI分类计数.md`。

## HMI 处理与限制

HmiRecord.h 在单调时钟 200 ms 超时下解析分包、连续包和噪声；长度、编码、CRC、版本/type/范围无效即丢弃，不把坏帧数据回灌成预览。Wcmn 在 COM2 接收线程零等待读取并解析，每批通过一次 AsynWorker::onFinished 回到 UI 线程，按接收顺序应用事件并只重建一次列表。

HmiApp::commandHistory 保存 code、ID、record_sequence，最多 256 条；Frm02 从统一历史重建列表，页面重开不重新分配 ID。每件材料可追加同 code 的新记录，显示如“ID:3 指令:19 五棱柱-红”。ID 只来自固件；第七新类循环 ID1，原第一类仍为 ID1。

HAL_UART_Transmit 成功仅表示 MCU 本地发送完成，不代表屏端收到/渲染。扩展帧只发送一次，没有 ACK、重发、可靠清屏握手、掉线补发、会话恢复或断电历史持久化。HMI 晚启动/重启可能丢旧历史，但后续每条记录自带真实 ID。HMI 发送错误只计数，不重抓/重释放。

升级要求：固件与指定 HMI 同步升级，旧屏只理解预览码而无法显示新生产帧。本次实际修改的是 D:/BaiduNetdiskDownload/ApusIDE2_v20250930/ApusIDE2_v20250930/workspace/TEST；仓库 TEST/ 副本未作为交付目标。

构建：`python -X utf8 tools/build_hmi.py`；协议回归：`python -X utf8 tools/selftest_mechanical.py`。ARM 构建和解析回归已通过；真实屏端 UI、串口接线与图片呈现尚待实机验证。ST7789 硬件详情见屏幕系统说明.md。
