ZLK-AllStar/2026GongChuang/docs/圆锥系列几何体映射.md

# 圆锥系列几何体映射与验证

日期：2026-11-08。
目标HMI：`D:/BaiduNetdiskDownload/ApusIDE2_v20250930/ApusIDE2_v20250930/workspace/TEST`。

## 圆锥追加码（2026-11-08）

圆锥的 shape_index=8；新增 code=81+color_index，颜色偏移0..9依次红、橙、黄、绿、青、蓝、紫、灰、黑、白。
已有1..72九色码与73..80原8形状白色码全部保持原值。

| 十进制 code | HEX字节 | 颜色 | 图片路径 |
|---|---|---|---|
| 81 | 0x51 | 红 | ./images/CO-RED.png |
| 82 | 0x52 | 橙 | ./images/CO-ORANGE.png |
| 83 | 0x53 | 黄 | ./images/CO-YELLOW.png |
| 84 | 0x54 | 绿 | ./images/CO-GREEN.png |
| 85 | 0x55 | 青 | ./images/CO-CYAN.png |
| 86 | 0x56 | 蓝 | ./images/CO-BLUE.png |
| 87 | 0x57 | 紫 | ./images/CO-PURPLE.png |
| 88 | 0x58 | 灰 | ./images/CO-GRAY.png |
| 89 | 0x59 | 黑 | ./images/CO-BLACK.png |
| 90 | 0x5A | 白 | ./images/CO-WHITE.png |

10张圆锥图片均为400×400、RGB不透明PNG，白色圆锥黑底，其余颜色白底，几何轮廓与明暗由 `tools/make_hmi_cone.py` 确定性生成。
工程根目录 `圆锥系列映射.csv` 可供发送端查表，`圆锥系列预览.png` 为全部10色对照图。

## 编码和累计计数

当前9形状×10颜色共90类，编码分三个区间，不能整体改为 shape*10+color+1：

```text
shape 0..7 / color 0..8: code = shape*9 + color + 1   (1..72)
shape 0..7 / color 9:    code = 73 + shape             (73..80)
shape 8 / color 0..9:    code = 81 + color             (81..90)
```

MCU `Core/Inc/hmi_codes.h` 和 HMI `src/hmi_codes.h` 为相同映射，回归核对字节一致。
HOST任务、DEBUG Shell和22字节生产帧D6均支持1..90；CRC、版本、帧长、ID六槽循环和任务去重不变。
圆锥各色分别累计同类总数，圆锥白色与球体白色等旧类分开；预览不计数、历史淘汰不减计数、新会话清零。

`HMI_SHAPE_CONE=8`。圆锥取料使用现有普通降杯深度；长方体的特殊全降规则不变。实际圆锥取料高度与吸取效果仍需上机验证。
视觉识别Python本轮未改，发送端须识别圆锥并按新增表发CMD。

## 联调与部署

```powershell
# 重新生成10色圆锥资源及映射CSV
python -X utf8 tools/make_hmi_cone.py
# 生成测试帧（没有 --port 时不会发送）
python -X utf8 tools/hmi_frame_test.py --record 81 1 --seq 1
python -X utf8 tools/hmi_frame_test.py --record 90 2 --seq 2
python -X utf8 tools/hmi_frame_test.py --preview 90
```

DEBUG Shell 可用十进制 `hmi 81` 至 `hmi 90`，仅预览、不执行机械。
串口助手使用HEX单字节 `51` 至 `5A`；不要把十进制81误输入为HEX 81。
生产记录使用原22字节帧，不能用单字节预览代替生产计数。

HMI工程源码、10张CO图片、CSV与预览图均已写入指定工程。ARM库和Windows DLL构建后同步至 `Release/libbootpanel.so` 与 `Debug/libbootpanel.dll`。
MCU与HMI需同步升级；屏端必须携带新增 `images/CO-*.png`，以及此前计数功能的 `images/HDR-RECORDS.png`。
ApusIDE F5刷新后 Clean / Build；本轮未下载MCU或部署实际屏幕。

## 验证记录

- 90个形状颜色组合逐一校对正反映射；原1..80编号保持一致；0/91非法码被拒绝。
- 实际MCU编码与HMI解析覆盖圆锥10色预览与生产帧、CRC、拆包、超时与连续包。
- 实际HOST任务覆盖圆锥10色接受、分类ID、正确生产记录及重复任务不重做动作。
- 实际Shell覆盖81/90接受、91拒绝。
- 实际Wcmn方法覆盖圆锥10色文字/索引/独立计数，白色圆锥第二条记录累计为2、白色球体保持1。
- 实际Frm02方法覆盖90类计数和CO资源路径，保留预览、历史淘汰、会话清空和64位计数字符串验证。
- 原有图片SHA256不变，HMI生成区不变，修改源文件保持原行尾与UTF-8无BOM。
- `tools/selftest_mechanical.py`、`tools/selftest_hmi_worker.py`、`tools/selftest_hmi_totals.py` 通过。
- HMI ARM C++11和Windows DLL构建通过；Keil ARMCC5.06 update7 build960全量重建0 Error(s)、0 Warning(s)。

日志：`MDK-ARM/MechanicalVerify/cone_series_fw_rebuild.log`、`MDK-ARM/MechanicalVerify/hmi_arm/build.log`。
修改前备份：`MDK-ARM/MechanicalVerify/cone_series_backup/20261108-115602/`。
