ZLK-AllStar/2026GongChuang/HMI工程/通信与分类显示说明.md

# TEST HMI 通信与分类显示实现

更新：2026-11-08；本文件对应本目录指定 HMI 工程，不是固件仓库 TEST/ 副本。无 mutex 轮询版本的 ARM C++11 编译/链接与主机回归已通过；本次未部署，真实屏端仍待验收。

## 代码位置与 UI

- src/HmiRecord.h：HmiRecord/HmiEvent 和流式 HmiParser，使用调用方提供的单调毫秒时钟。
- src/hmi_codes.h：90 码共享映射，原九色码保持原序，追加原8形状白色73..80、圆锥10色81..90。
- src/hmi_protocol.h：与 MCU Core/Inc/hmi_protocol.h 保持完全相同的 CRC 实现，固件自动回归会校验两份字节一致。
- src/HmiApp.h：commandHistory 改为 vector<HmiRecord>，存储 code/ID/record_sequence；previewCode 为临时预览，独立于生产历史。
- src/pages/Wcmn.h/.cpp：串口 COM2 不变；接收线程零等待读取与解析，每批通过 AsynWorker 回到 UI 线程更新状态和列表。
- src/pages/Frm02.h/.cpp：syncCommandHistory/appendRecord 从统一表重建列表，显示固件 ID，重开页面不重新编号；最多保留 256 条，淘汰同步到 UI。预览为独立临时行，不进入 history。

已有8张WHITE黑底白色资源，新增10张CO圆锥资源（白色黑底）；lib/、页面布局、原 72 张图片及图片路径均未修改。生成的 createParts 保持原样，新增声明/逻辑置于 CUSTOM 区或独立应用头文件。记录为内存历史，无断电持久化。

## 不变的 72 码

code=shape_index×9+color_index+1。颜色依次红、橙、黄、绿、青、蓝、紫、灰、黑。

| 范围 | 形状 | 图片前缀 |
|---|---|---|
| 1..9 | 正四面体 | RT |
| 10..18 | 三棱柱 | TP |
| 19..27 | 五棱柱 | PP |
| 28..36 | 六棱柱 | HP |
| 37..45 | 圆柱形 | CY |
| 46..54 | 长方体 | CB |
| 55..63 | 正方体 | CU |
| 64..72 | 球体 | SP |

保留 ./images/<shape>-<color>.png 路径。单字节 0x01..0x5A 现在只用于调试预览：显示图片/文字及“调试预览 / 无生产 ID”，不追加生产 history、不分配分类 ID、不消耗记录序号。Shell `hmi 19` 发一个 0x13 字节。

### 白色追加码（2026-11-08）

白色的 color_index=9；编码使用独立追加区 `code=73+shape_index`。
原有 1..72 的九色公式保持不变，不能把原公式中的乘数 9 改为 10。

| 十进制 code | 十六进制字节 | 形状 | 图片路径 |
|---|---|---|---|
| 73 | 0x49 | 正四面体 | ./images/RT-WHITE.png |
| 74 | 0x4A | 三棱柱 | ./images/TP-WHITE.png |
| 75 | 0x4B | 五棱柱 | ./images/PP-WHITE.png |
| 76 | 0x4C | 六棱柱 | ./images/HP-WHITE.png |
| 77 | 0x4D | 圆柱形 | ./images/CY-WHITE.png |
| 78 | 0x4E | 长方体 | ./images/CB-WHITE.png |
| 79 | 0x4F | 正方体 | ./images/CU-WHITE.png |
| 80 | 0x50 | 球体 | ./images/SP-WHITE.png |

新增 PNG 均为 400×400、RGB、不透明黑底、白色带明暗立面；从原 GRAY 资源派生，保留形状轮廓与方向。
可查看工程根目录 `白色几何体预览.png` 与 `白色几何体映射.csv`。
MCU `Core/Inc/hmi_codes.h` 和 HMI `src/hmi_codes.h` 为相同映射实现，回归会核对字节一致。

白色同时支持单字节预览与原 22 字节生产帧的 D6 字段；版本、帧长、CRC、ID1..ID6 循环和记录去重规则不变。
HOST 的 CMD 也接受 73..80；视觉识别 Python 本次未修改，发送端识别白色后须按追加表发码。

## 圆锥追加码（2026-11-08）

圆锥的 shape_index=8；新增 code=81+color_index，颜色偏移0..9依次红、橙、黄、绿、青、蓝、紫、灰、黑、白。
已有1..72九色码与73..80原8形状白色码全部保持原值。

| 十进制 code | HEX字节 | 颜色 | 图片路径 |
|---|---|---|---|
| 81 | 0x51 | 红 | ./images/CO-RED.png |
| 82 | 0x52 | 橙 | ./images/CO-ORANGE.png |
| 83 | 0x53 | 黄 | ./images/CO-YELLOW.png |
| 84 | 0x54 | 绿 | ./images/CO-GREEN.png |
| 85 | 0x55 | 青 | ./images/CO-CYAN.png |
| 86 | 0x56 | 蓝 | ./images/CO-BLUE.png |
| 87 | 0x57 | 紫 | ./images/CO-PURPLE.png |
| 88 | 0x58 | 灰 | ./images/CO-GRAY.png |
| 89 | 0x59 | 黑 | ./images/CO-BLACK.png |
| 90 | 0x5A | 白 | ./images/CO-WHITE.png |

10张圆锥图片均为400×400、RGB不透明PNG，白色圆锥黑底，其余颜色白底，几何轮廓与明暗由 `tools/make_hmi_cone.py` 确定性生成。
工程根目录 `圆锥系列映射.csv` 可供发送端查表，`圆锥系列预览.png` 为全部10色对照图。

## 新分类帧

固定 22 字节：F0，10 个数据字节各拆为高/低半字节并编码为 0x80|n，F1。中间 20 字节全部为 0x80..0x8F，旧屏不会把元数据当 1..72 指令。

| 解码字节 | 字段 |
|---|---|
| D0 | version=1 |
| D1 | type=1 分类完成记录，type=2 新会话清空 |
| D2..D5 | uint32 小端 record_sequence；type1 从 1 递增，type2 为 0 |
| D6 | code 1..90；type2 为 0 |
| D7 | 固件 ID 1..6；type2 为 0 |
| D8..D9 | D0..D7 的 CRC16/CCITT-FALSE，低字节先发 |

CRC：poly=0x1021、init=0xFFFF、refin/refout=false、xorout=0；ASCII 123456789 校核为 0x29B1。

seq=1/code=19/ID=3 完整示例：

```text
F0 80 81 80 81 80 81 80 80 80 80 80 80 81 83 80 83 86 8F 8E 8D F1
```

新会话：

```text
F0 80 81 80 82 80 80 80 80 80 80 80 80 80 80 80 80 80 8E 81 86 F1
```

HOST 初始化发送一次 type2；DEBUG 不主动清历史。type1 仅在释放流程成功完成后发送一次；上位机重发只补状态，不重发 HMI。记录已发送后停靠失败，记录保留而 HOST 收 FAILED。

## 同类总数（2026-11-08）

分类记录行末显示相同形状＋颜色的本次会话累计总数，以code分别计数，共90类（含白色及圆锥10色）。生产type1记录加1，预览不计数；所有同类历史行显示当前累计值。计数独立于256条可见历史，淘汰/刷新/重开不减不增，新会话type2与HMI重启清零。部署需更新库及 `images/HDR-RECORDS.png` 表头图。详见 `分类计数说明.md`。

## HMI 处理与限制

HmiRecord.h 在单调时钟 200 ms 超时下解析分包、连续包和噪声；长度、编码、CRC、版本/type/范围无效即丢弃，不把坏帧数据回灌成预览。Wcmn 的串口回调运行在 COM2 接收线程：`readData(bytes, 0)` 零等待取数、解析成事件后，每批通过一次 `AsynWorker::onFinished` 跳到 UI 线程执行 `applyEvents`，由 UI 线程更新 `串口` 变量、`commandHistory` 和 Frm02 列表并只重建一次。回调本身不读写任何 UI 状态；无 STTTimer、无轮询、无应用层 mutex。页面退出先置 `active=false`，再关闭串口，已排队的异步批次直接丢弃。

HmiApp::commandHistory 保存 code、ID、record_sequence，最多 256 条；Frm02 从统一历史重建列表，页面重开不重新分配 ID。每件材料可追加同 code 的新记录，显示如“ID:3 指令:19 五棱柱-红”。ID 只来自固件；第七新类循环 ID1，原第一类仍为 ID1。

HAL_UART_Transmit 成功仅表示 MCU 本地发送完成，不代表屏端收到/渲染。扩展帧只发送一次，没有 ACK、重发、可靠清屏握手、掉线补发、会话恢复或断电历史持久化。HMI 晚启动/重启可能丢旧历史，但后续每条记录自带真实 ID。HMI 发送错误只计数，不重抓/重释放。

升级要求：固件与指定 HMI 同步升级，旧屏只理解预览码而无法显示新生产帧。本次实际修改的是 D:/BaiduNetdiskDownload/ApusIDE2_v20250930/ApusIDE2_v20250930/workspace/TEST；仓库 TEST/ 副本未作为交付目标。

构建：`python -X utf8 tools/build_hmi.py`；协议回归：`python -X utf8 tools/selftest_mechanical.py`；Wcmn 收包/线程边界回归：`python -X utf8 tools/selftest_hmi_worker.py`。发帧工具：`python -X utf8 tools/hmi_frame_test.py`。ARM 构建、主机回归和 Windows 模拟器注入帧验证均已通过；真实屏端 UI、串口接线与图片呈现尚待实机验证。ST7789 硬件详情见屏幕系统说明.md。

## ARM 构建与升级

实际工具链：本安装目录 sdk/gcc-linaro-6.3.1-2017.05-i686-mingw32_arm-linux-gnueabihf/bin/arm-linux-gnueabihf-g++.exe，版本 6.3.1。使用 -O3 -fPIC -std=c++11 -Wall 编译本工程全部四个 src/*.cpp，与配置的 platform/1.1.0.0/arm/libstt_core.so、pthread/dl/stdc++ 链接。readelf 确认 ELF32、ARM、EABI5 hard-float、DYN，共享库并非 Windows/x86 模拟构建。

在固件仓库运行 `python -X utf8 tools/build_hmi.py` 可重现；输出位于固件 MDK-ARM/MechanicalVerify/hmi_arm/libbootpanel.so，日志 build.log，均为本地验证产物。本次没有将共享库覆盖到屏端或触发部署。

升级时先确保固件与 HMI 同时支持新帧，再做串口与实际 UI 验收；仅升级 MCU 而保留旧单字节解析器无法显示生产分类。串口无 ACK，清空会话帧可能在 HMI 晚启动时丢失；不要把本地发送完成当成可靠握手。后续每条记录都自带 ID，旧历史是否完整不影响新记录的 ID 来源。

原文件备份在固件 MDK-ARM/MechanicalVerify/hmi_baseline/，用于审查本次修改；保留的用户工程数据没有清理。

## 列表首行文字不可见（SDK 行为与规避）

实测 SDK `STTList`：`clearOptions()` 之后创建的第一个子行不会套用列表文字样式，标签保持白色；白底列表上表现为“第一行只有图片、没有文字”，再加一条记录（第二行）后前一行仍不恢复，第二行起才正常。已用 Windows 模拟器逐项排除：`display()`、`refreshAll()`、`refresh()`、重新 `setFonts`、`setMainStyle` 抖动、`setSelected(-1)`、`p_text->setColor()`、清空后二次重建、下一轮 UI 重建都不能让首行恢复；只有“首行先占用”有效。

规避：该首行改为**表头行**。`Frm02::syncCommandHistory()` 在 `clearOptions()` 后、有内容时先 `addButton("./images/HDR-RECORDS.png", "")`：表头文字画进图片（白色标签不可见也无所谓），真实记录从第二行起正常显示。表头 971×41 px，列位置与记录文字逐列对齐（页面上 x=451 / 490 / 548 分别是 ID、指令、形状-颜色）；图片由 `tools/make_hmi_header.py` 用工程自带 `fnt/wenquanyiweimihei.ttf` 生成，可重新出图。列表为空时不加表头。

该规避不改 `createParts`（IDE 生成区），只改 CUSTOM 区。部署时要连同 `images/HDR-RECORDS.png` 一起拷贝，漏掉会出现一条空白表头。若日后 SDK 修复该行为，可把这一行换成普通文字行或删除。

## 2026-11-02：回调驱动 + 一次 UI 跳转（当前方案）

公共页注册启用。Wcmn 不再创建 STTTimer：`wMCom3_vch_cb` 在 COM2 接收线程执行 `readData(bytes, 0)` 零等待读取，交给 `consumeSerial()` 解析，每批事件通过一次 `AsynWorker::onFinished` 跳到 UI 线程执行 `applyEvents()`。变量写入、`commandHistory`、`previewCode` 与 Frm02 列表只在 UI 线程改动；解析器和 `active` 之外的接收侧状态只在接收线程改动，因此没有应用层 mutex、队列或轮询。

选型依据：SDK 把线程职责写死在 `IAsynWorker` 文档里（`invoke` 禁止 UI 操作，`onFinished` 可做 UI 操作），串口回调不属于 UI 线程；定时器方案虽然也成立，但实测 `STTTimer::onEventHandler` 只接受 code=31（`Event::READY`），传 `Event::VALUE_CHANGED` 会被静默忽略，回调一次都不会执行。改为回调驱动后显示延迟从“最多一个轮询周期”变成“一次异步往返”，也不再依赖定时器语义。

限制：`AsynWorker::start()` 失败时该批事件被丢弃并计入 `droppedUpdates`，不做跨线程直接刷新的降级。记录按批跳转，理论上多批并发完成时顺序由 SDK 异步完成顺序决定；生产节拍（每件数秒）远大于一次往返，尚未观察到乱序。持续满速输入、UI 长时间阻塞仍可能溢出 SDK 接收缓冲。200 ms 解析超时按读取时间判断，不能还原 UART 实际到达时间；不承诺无丢包或可靠握手。

验证：`python -X utf8 tools/selftest_hmi_worker.py` 用真实 Wcmn.cpp 方法体与 SDK 替身覆盖：未 onLoad 不读串口、零等待读取、分包/200 ms 超时、CRC 拒绝、一批事件只跳转一次且只在 UI 线程改状态、历史上限 256、缺页时打开 Frm02、dispose 丢弃已排队批次、`start()` 失败不越权刷 UI。`python -X utf8 tools/build_hmi.py` 通过且无警告，应用库不再导入任何 STTTimer 符号。Windows 模拟器用真实 22 字节帧注入 `consumeSerial`，三帧按序落到列表（ID:3 指令:19 / ID:1 指令:1 / ID:6 指令:72）。

本轮没有覆盖工程 Release/libbootpanel.so。候选库在固件仓库 `MDK-ARM/MechanicalVerify/hmi_arm/libbootpanel.so`；真实屏端启动与收包仍待实机验收。修改前备份：`MDK-ARM/MechanicalVerify/hmi_polling_backup/20261102-202935/`。
