ZLK-AllStar/2026GongChuang/HMI工程/images/CB-BLACK.png

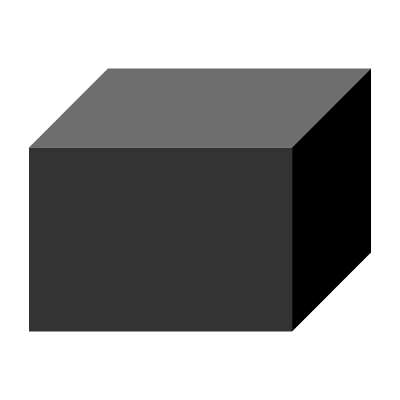
HMI工程/images/CB-BLACK.png
