ZLK-AllStar/2026GongChuang/HMI工程/images/CB-WHITE.png

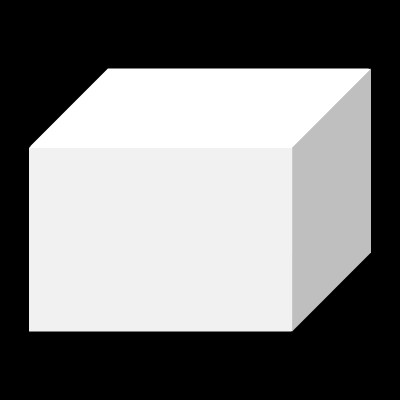
HMI工程/images/CB-WHITE.png
