ZLK-AllStar/2026GongChuang/HMI工程/images/CO-BLACK.png

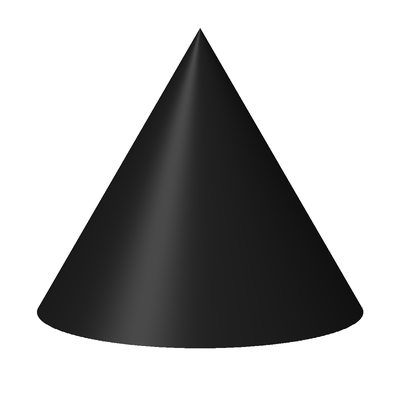
HMI工程/images/CO-BLACK.png
