ZLK-AllStar/2026GongChuang/HMI工程/images/CO-WHITE.png

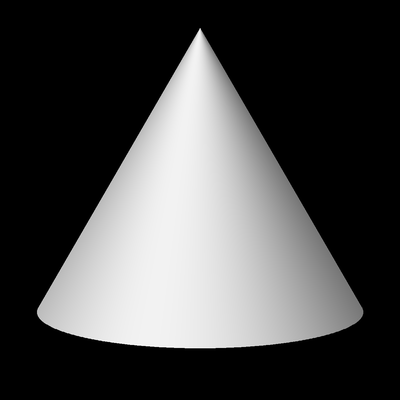
HMI工程/images/CO-WHITE.png
