ZLK-AllStar/2026GongChuang/HMI工程/images/CO-YELLOW.png

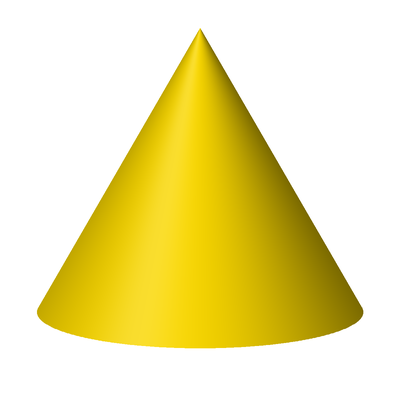
HMI工程/images/CO-YELLOW.png
