ZLK-AllStar/2026GongChuang/HMI工程/images/CU-BLACK.png

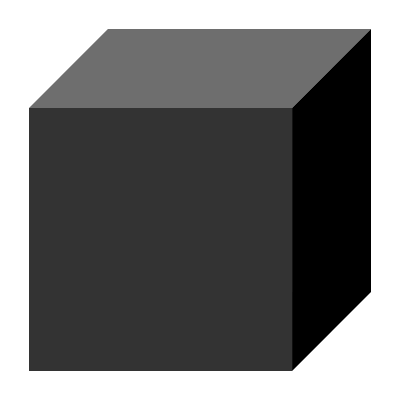
HMI工程/images/CU-BLACK.png
