ZLK-AllStar/2026GongChuang/HMI工程/images/CU-WHITE.png

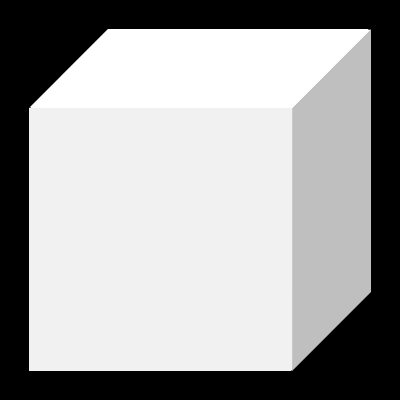
HMI工程/images/CU-WHITE.png
