ZLK-AllStar/2026GongChuang/HMI工程/images/CY-BLACK.png

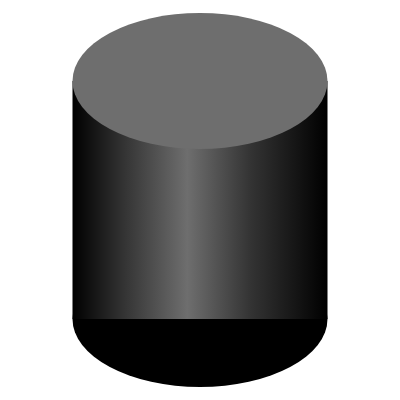
HMI工程/images/CY-BLACK.png
