ZLK-AllStar/2026GongChuang/HMI工程/images/CY-WHITE.png

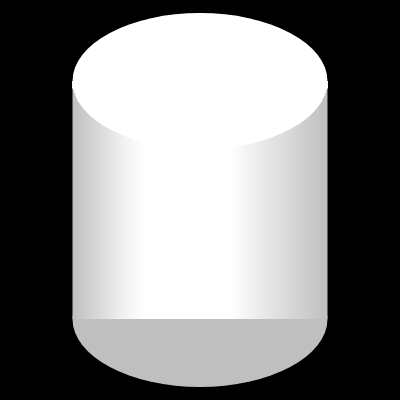
HMI工程/images/CY-WHITE.png
