ZLK-AllStar/2026GongChuang/HMI工程/images/HP-BLACK.png

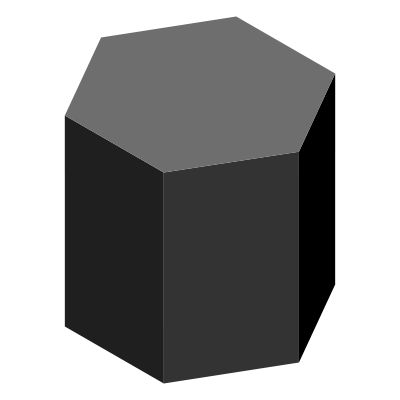
HMI工程/images/HP-BLACK.png
