ZLK-AllStar/2026GongChuang/HMI工程/images/HP-YELLOW.png

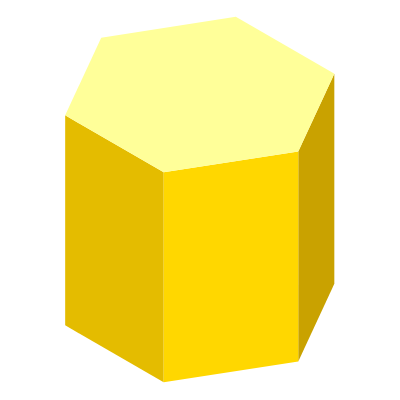
HMI工程/images/HP-YELLOW.png
