ZLK-AllStar/2026GongChuang/HMI工程/images/PP-BLACK.png

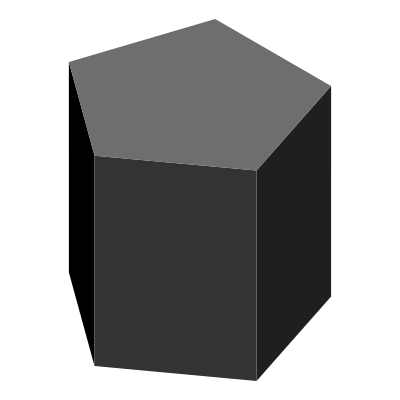
HMI工程/images/PP-BLACK.png
