ZLK-AllStar/2026GongChuang/HMI工程/images/PP-WHITE.png

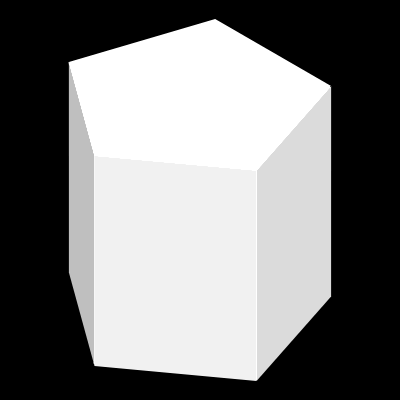
HMI工程/images/PP-WHITE.png
