ZLK-AllStar/2026GongChuang/HMI工程/images/RT-BLACK.png

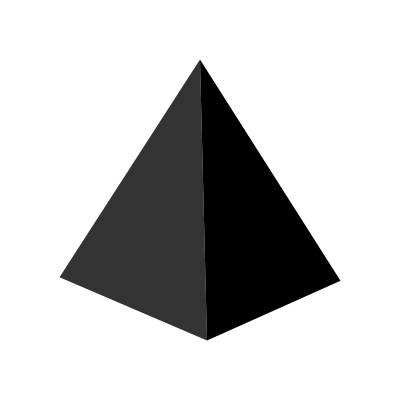
HMI工程/images/RT-BLACK.png
