ZLK-AllStar/2026GongChuang/HMI工程/images/RT-WHITE.png

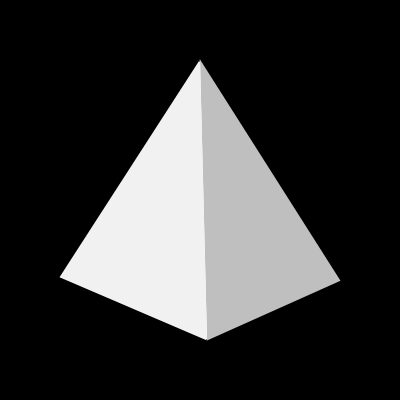
HMI工程/images/RT-WHITE.png
