ZLK-AllStar/2026GongChuang/HMI工程/images/SP-BLACK.png

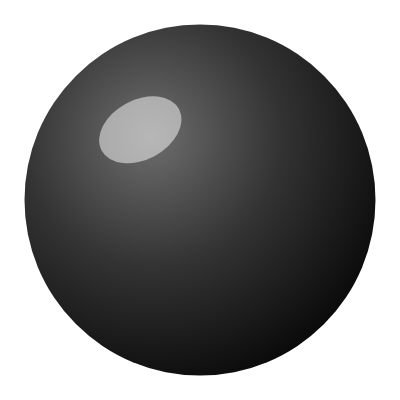
HMI工程/images/SP-BLACK.png
