ZLK-AllStar/2026GongChuang/HMI工程/images/SP-GRAY.png

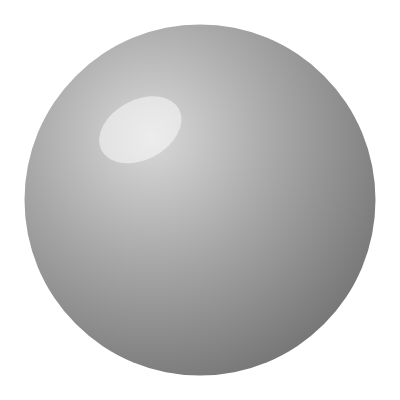
HMI工程/images/SP-GRAY.png
