ZLK-AllStar/2026GongChuang/HMI工程/images/SP-WHITE.png

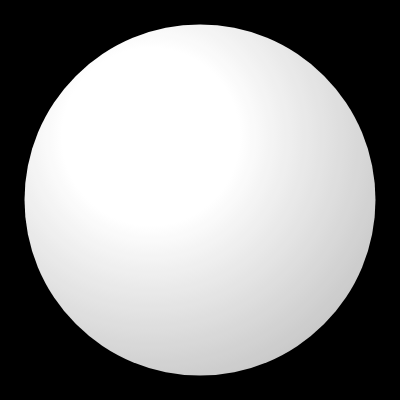
HMI工程/images/SP-WHITE.png
