ZLK-AllStar/2026GongChuang/HMI工程/images/TP-BLACK.png

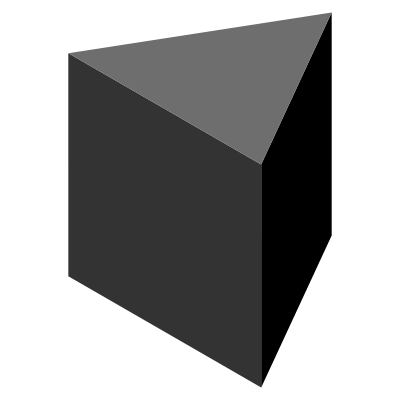
HMI工程/images/TP-BLACK.png
