ZLK-AllStar/2026GongChuang/HMI工程/images/TP-WHITE.png

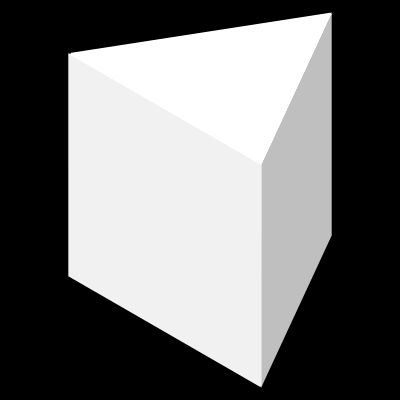
HMI工程/images/TP-WHITE.png
