ZLK-AllStar/2026GongChuang/模型/省赛/整体/分拣.SLDASM

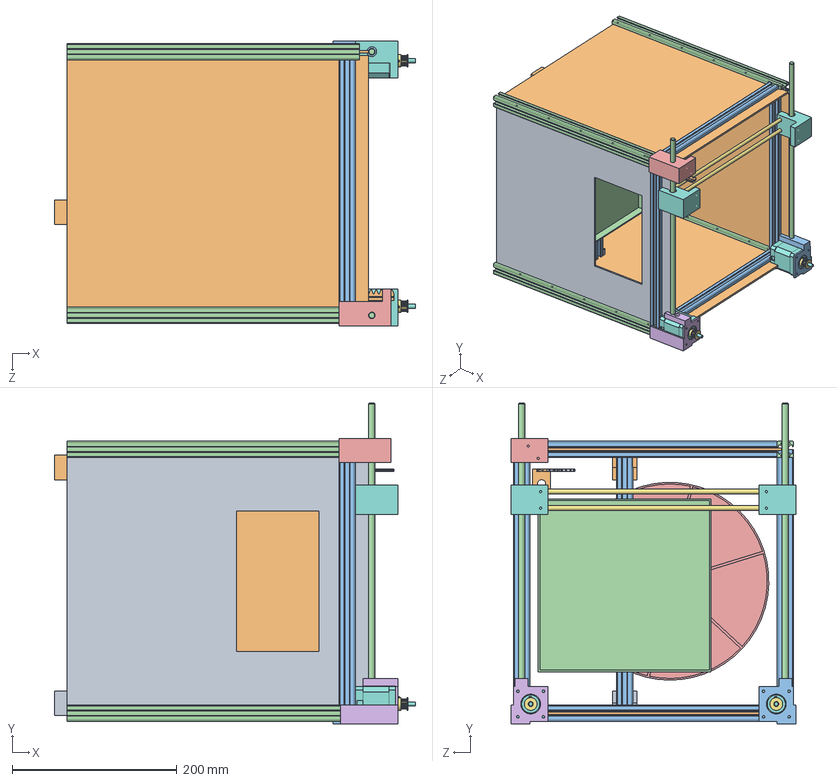
[picture p24: CAD file, 2026-11-12]
模型/省赛/整体/分拣.SLDASM
438.0 x 389.0 x 346.0 mm
竖杆 x 4
横杆 x 4
挡板 x 3
挡板0
nema17 x 2
1165-B2P-A-1 x 2
固定电机
支座
rod_y axis_348x8 x 2
Mirror固定电机
齿条
圆柱齿轮
滑块lll. x 2
rod_y printhead_lll. x 2
电机
hezi
托盘
固定杆
支撑杆
Mirror支撑杆
