ZLK-AllStar/2026GongChuang/模型/省赛/滑台/分支/分支.SLDASM

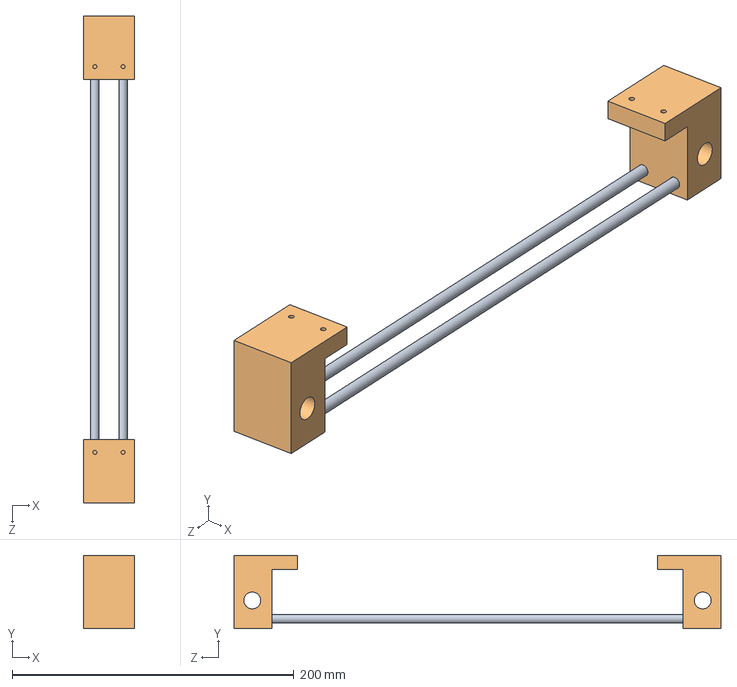
[picture p25: CAD file, 2026-11-12]
模型/省赛/滑台/分支/分支.SLDASM
36.0 x 52.0 x 346.0 mm
滑块lll. x 2
rod_y printhead_lll. x 2
