ZLK-AllStar/2026GongChuang/模型/省赛/分类盒/分类盒..SLDASM

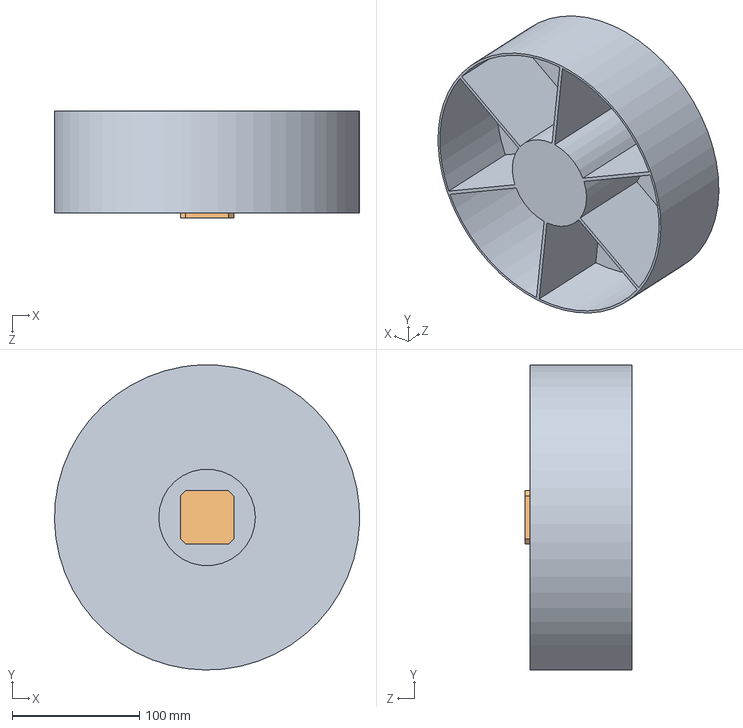
[picture p26: CAD file, 2026-11-12]
模型/省赛/分类盒/分类盒..SLDASM
239.9 x 239.9 x 84.0 mm
电机
hezi
