ZLK-AllStar/2026GongChuang/模型/省赛/托盘/托盘.SLDASM

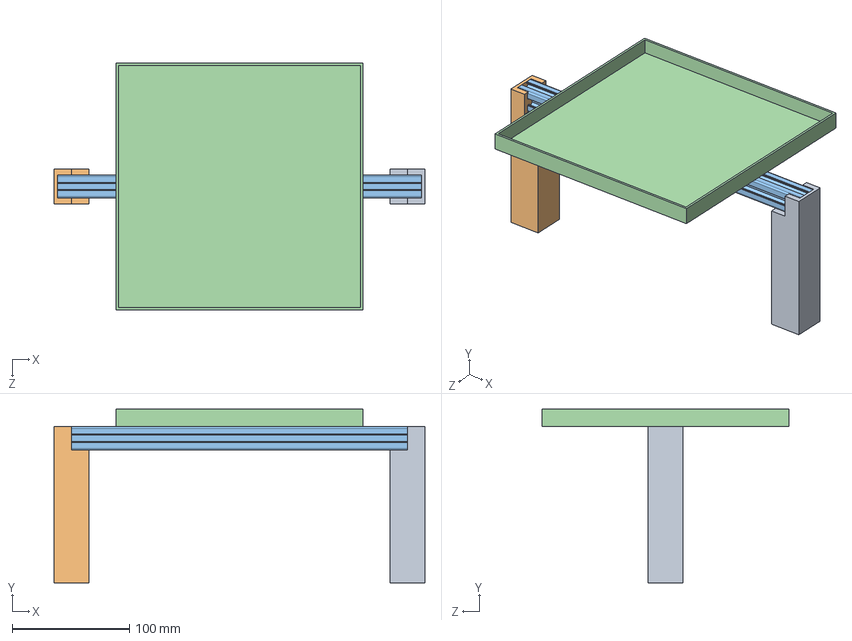
[picture p27: CAD file, 2026-11-12]
模型/省赛/托盘/托盘.SLDASM
316.0 x 148.0 x 210.0 mm
托盘
固定杆
支撑杆
Mirror支撑杆
