ZLK-AllStar/2026GongChuang/模型/省赛/抓取/抓取.SLDASM

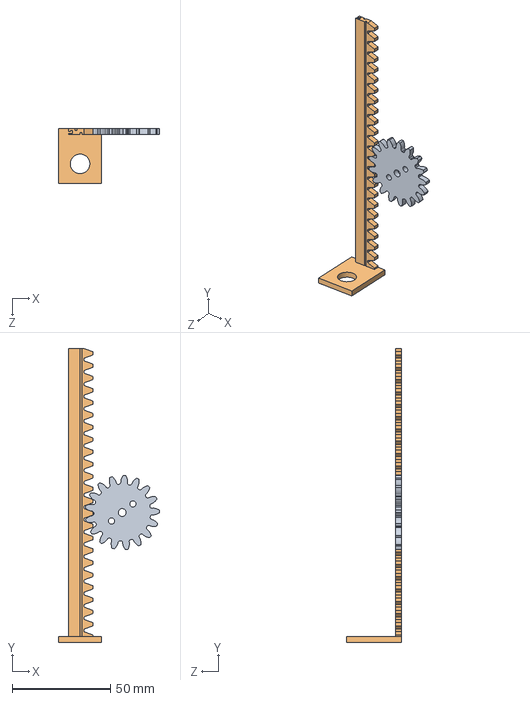
[picture p28: CAD file, 2026-11-12]
模型/省赛/抓取/抓取.SLDASM
51.5 x 150.0 x 28.0 mm
齿条
圆柱齿轮
