ZLK-AllStar/2026GongChuang/模型/省赛/框架/框架..SLDASM

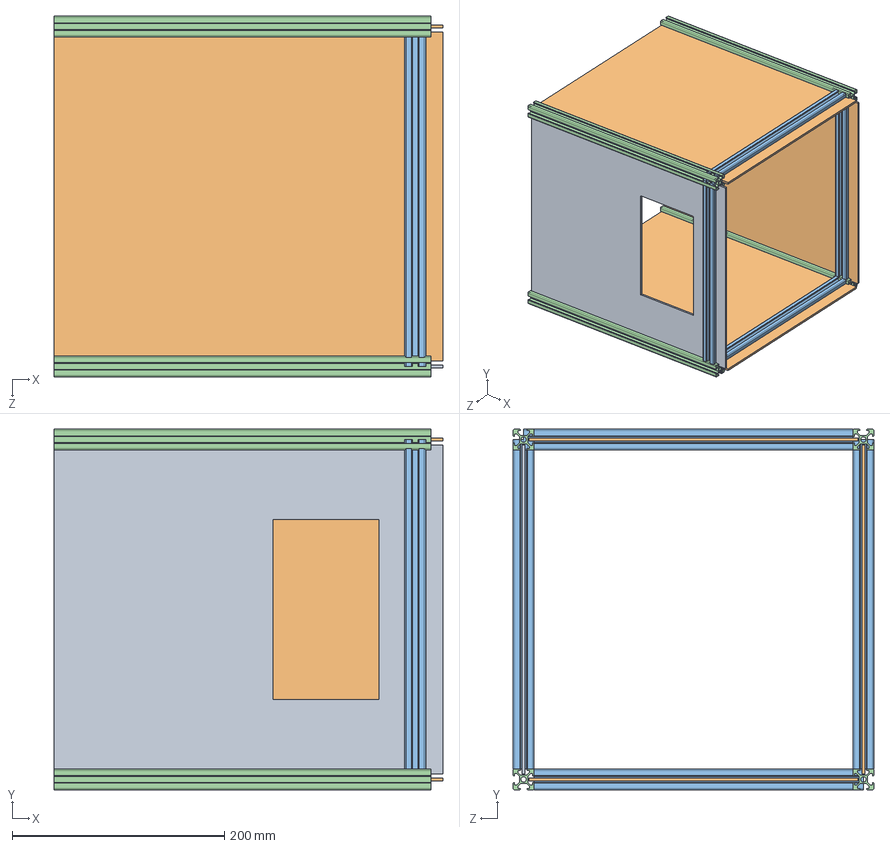
[picture p29: CAD file, 2026-11-12]
模型/省赛/框架/框架..SLDASM
366.0 x 340.0 x 340.0 mm
竖杆 x 4
横杆 x 4
挡板 x 3
挡板0
