ZLK-AllStar/2026GongChuang/模型/省赛/滑台/滑台..SLDASM

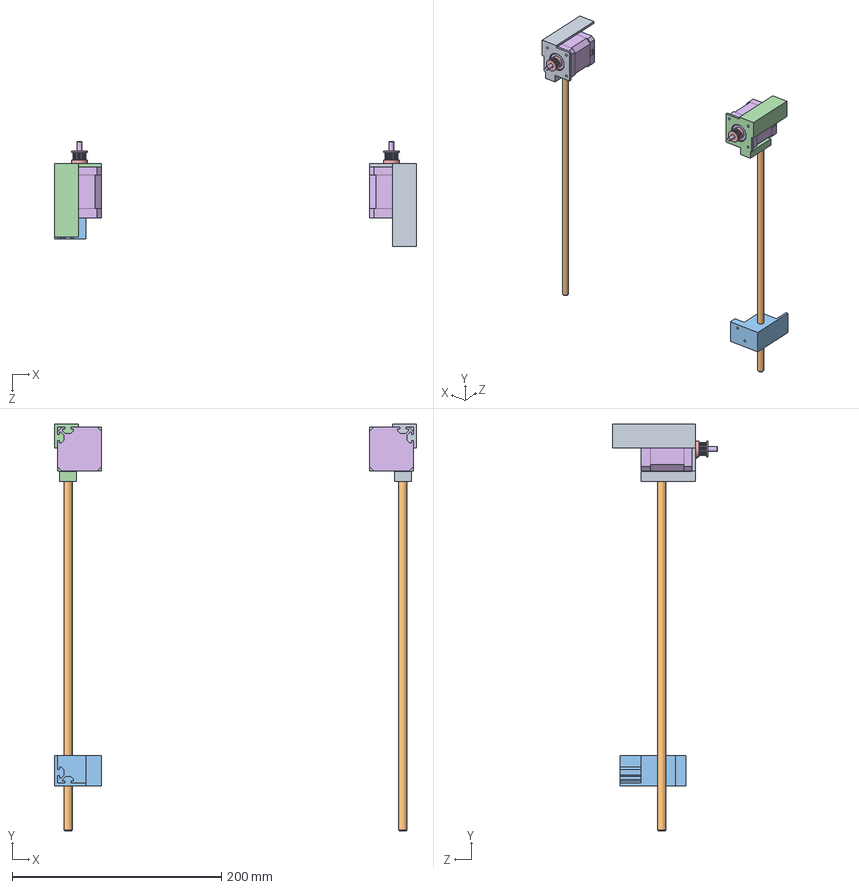
[picture p30: CAD file, 2026-11-12]
模型/省赛/滑台/滑台..SLDASM
346.0 x 389.0 x 100.0 mm
nema17 x 2
1165-B2P-A-1 x 2
固定电机
支座
rod_y axis_348x8 x 2
Mirror固定电机
