ZLK-AllStar/2026GongChuang/模型/省赛/分类盒/转动架.SLDPRT

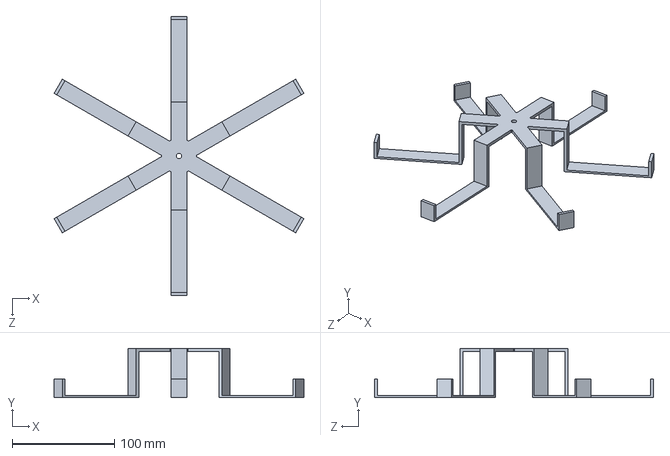
[picture p31: CAD file, 2026-11-12]
模型/省赛/分类盒/转动架.SLDPRT
244.3 x 48.0 x 272.8 mm
