ZLK-AllStar/2026GongChuang/模型/省赛/托盘.SLDPRT

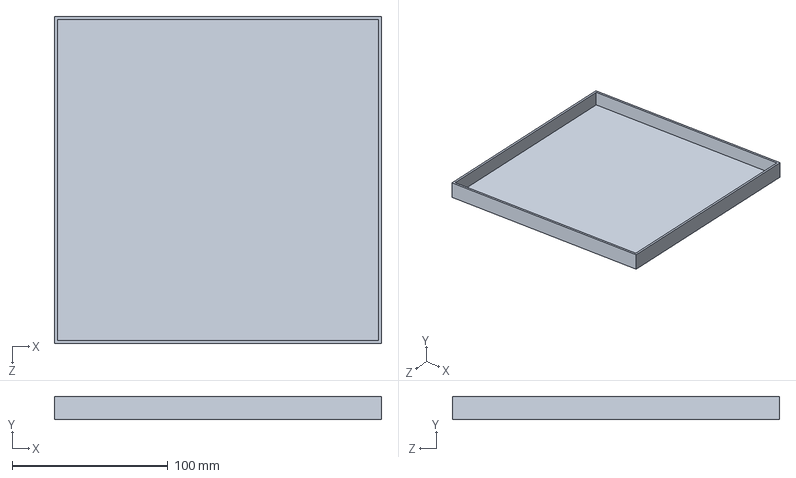
[picture p32: CAD file, 2026-11-12]
模型/省赛/托盘.SLDPRT
210.0 x 15.0 x 210.0 mm
