ZLK-AllStar/2026GongChuang/模型/省赛/托盘/Mirror支撑杆.SLDPRT

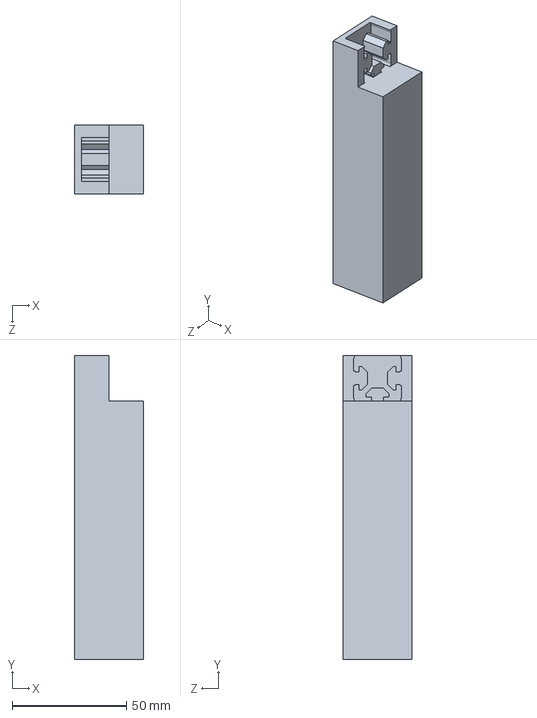
[picture p33: CAD file, 2026-11-12]
模型/省赛/托盘/Mirror支撑杆.SLDPRT
30.0 x 133.0 x 30.0 mm
