ZLK-AllStar/2026GongChuang/模型/省赛/抓取/升降定位.SLDPRT

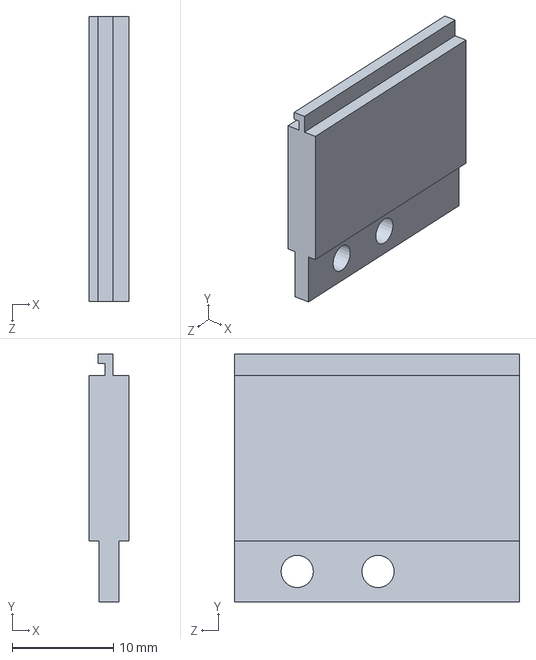
[picture p34: CAD file, 2026-11-12]
模型/省赛/抓取/升降定位.SLDPRT
4.00 x 24.5 x 28.2 mm
