ZLK-AllStar/2026GongChuang/模型/省赛/框架/挡板0.SLDPRT

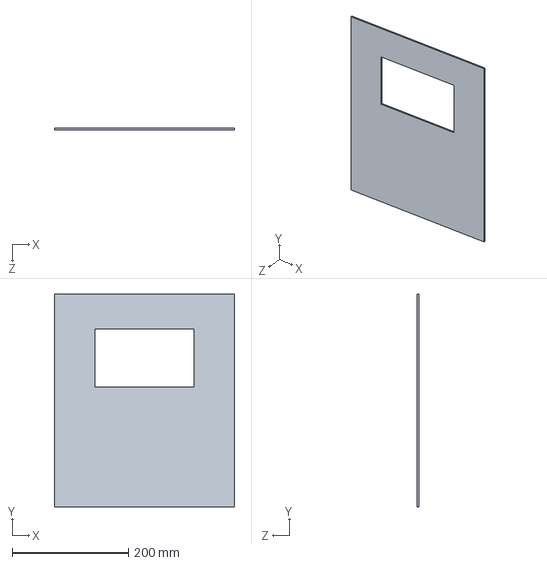
[picture p35: CAD file, 2026-11-12]
模型/省赛/框架/挡板0.SLDPRT
310.0 x 366.0 x 3.00 mm
