ZLK-AllStar/2026GongChuang/模型/省赛/滑台/1165-B2P-A-1.SLDPRT

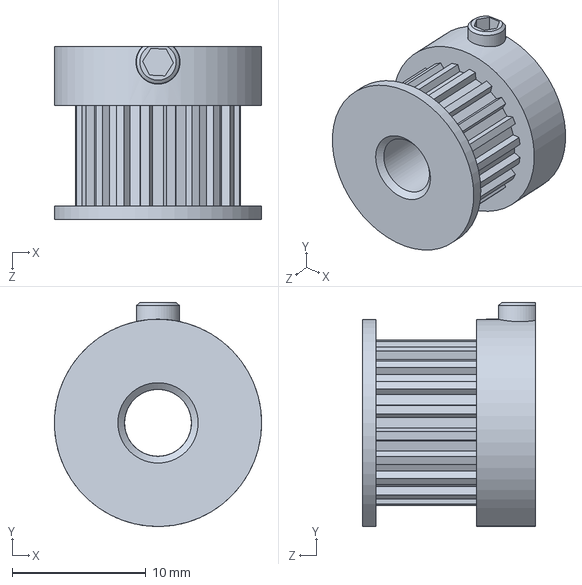
[picture p36: CAD file, 2026-11-12]
模型/省赛/滑台/1165-B2P-A-1.SLDPRT
15.5 x 16.7 x 12.9 mm
