ZLK-AllStar/2026GongChuang/模型/省赛/滑台/分支/rod_y printhead_lll..SLDPRT

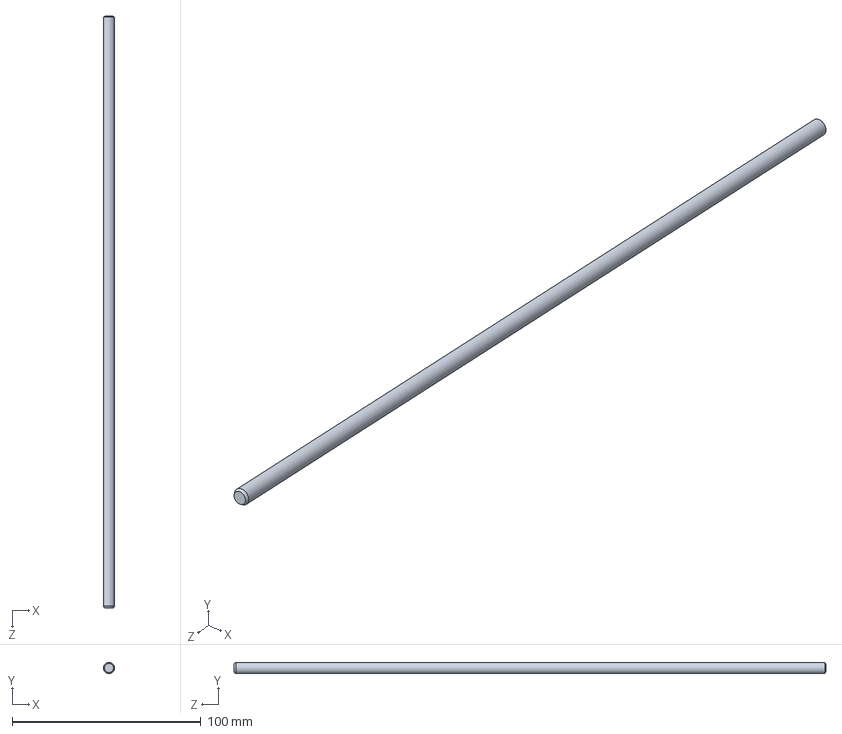
[picture p37: CAD file, 2026-11-12]
模型/省赛/滑台/分支/rod_y printhead_lll..SLDPRT
6.00 x 5.99 x 314.0 mm
