ZLK-AllStar/2026GongChuang/模型/省赛/分类盒/hezi.SLDPRT

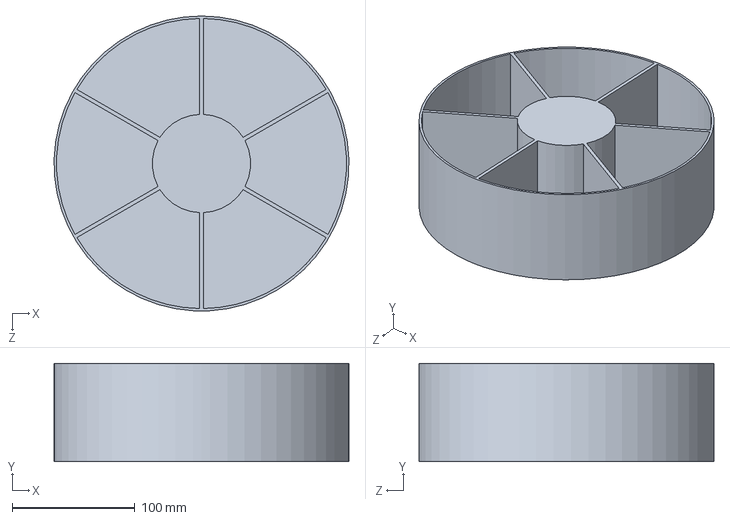
[picture p38: CAD file, 2026-11-12]
模型/省赛/分类盒/hezi.SLDPRT
239.9 x 80.0 x 240.0 mm
