ZLK-AllStar/2026GongChuang/模型/省赛/抓取/套壳.SLDPRT

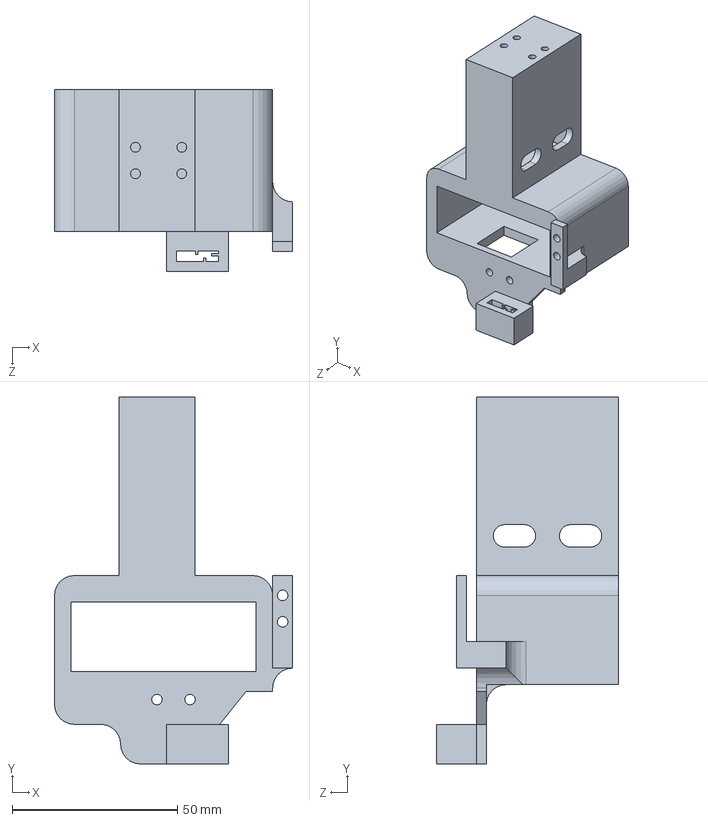
[picture p39: CAD file, 2026-11-12]
模型/省赛/抓取/套壳.SLDPRT
72.0 x 111.0 x 55.1 mm
