ZLK-AllStar/2026GongChuang/模型/省赛/框架/横杆.SLDPRT

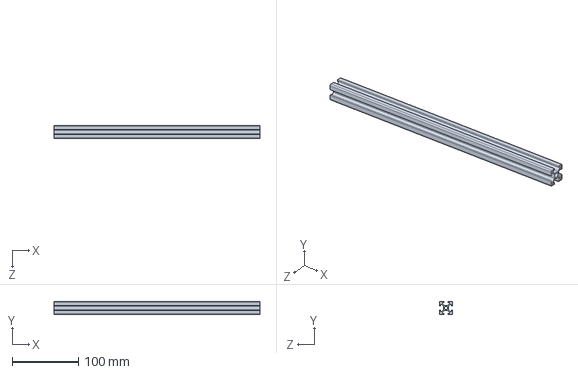
[picture p40: CAD file, 2026-11-12]
模型/省赛/框架/横杆.SLDPRT
310.0 x 20.0 x 20.0 mm
