ZLK-AllStar/2026GongChuang/模型/省赛/滑台/rod_y axis_348x8.SLDPRT

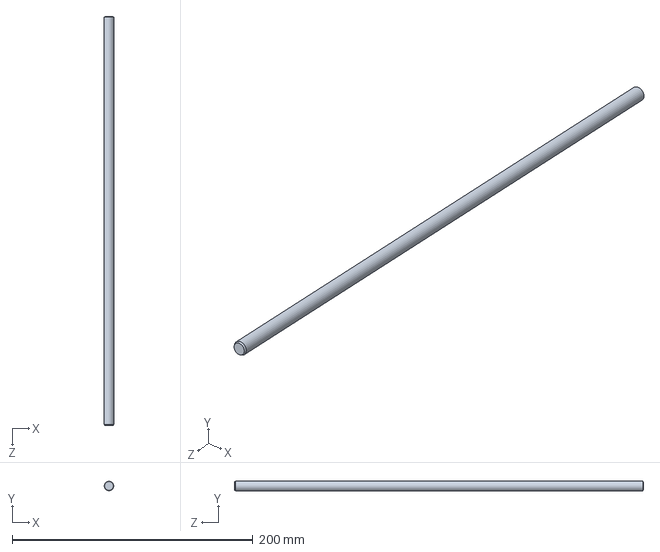
[picture p41: CAD file, 2026-11-12]
模型/省赛/滑台/rod_y axis_348x8.SLDPRT
8.00 x 8.00 x 340.0 mm
