ZLK-AllStar/2026GongChuang/模型/省赛/框架/竖杆.SLDPRT

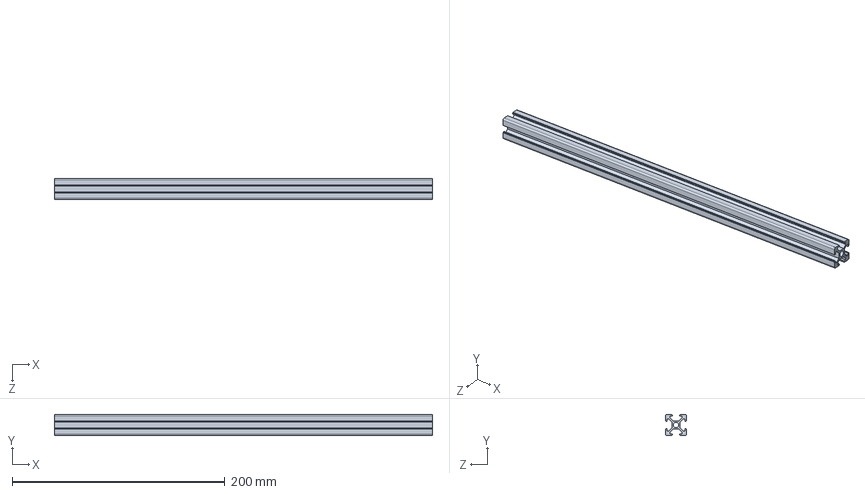
[picture p42: CAD file, 2026-11-12]
模型/省赛/框架/竖杆.SLDPRT
355.0 x 20.0 x 20.0 mm
