ZLK-AllStar/2026GongChuang/模型/省赛/滑台/分支/滑块lll..SLDPRT

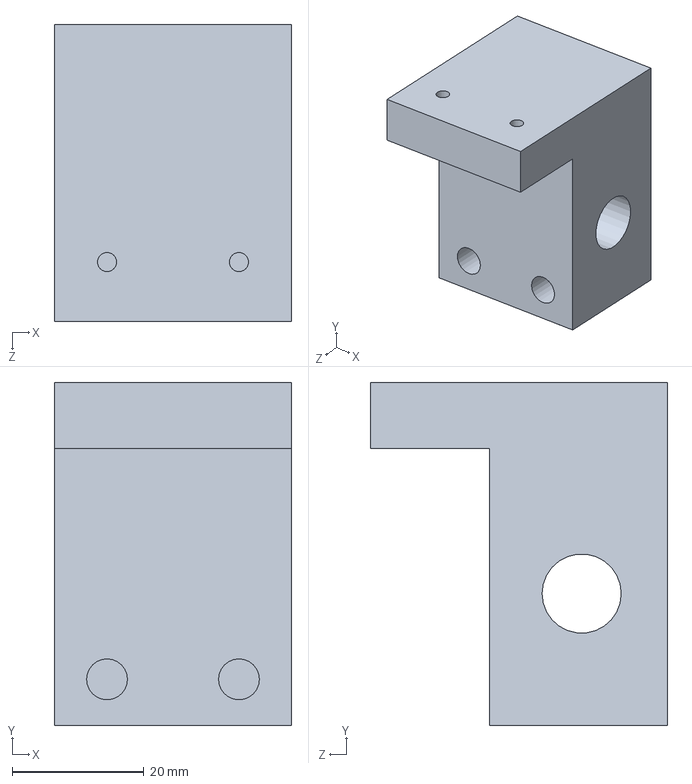
[picture p43: CAD file, 2026-11-12]
模型/省赛/滑台/分支/滑块lll..SLDPRT
36.0 x 52.0 x 45.0 mm
