ZLK-AllStar/2026GongChuang/模型/省赛/滑台/固定电机2.SLDPRT

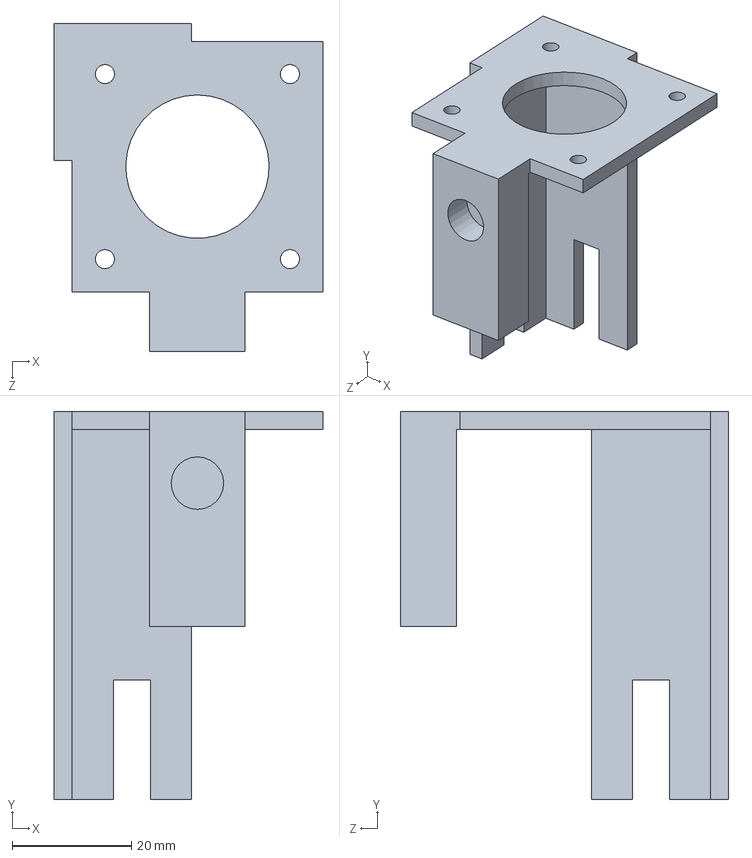
[picture p44: CAD file, 2026-11-12]
模型/省赛/滑台/固定电机2.SLDPRT
45.0 x 65.0 x 55.0 mm
