ZLK-AllStar/2026GongChuang/模型/省赛/分类盒/盒子.SLDPRT

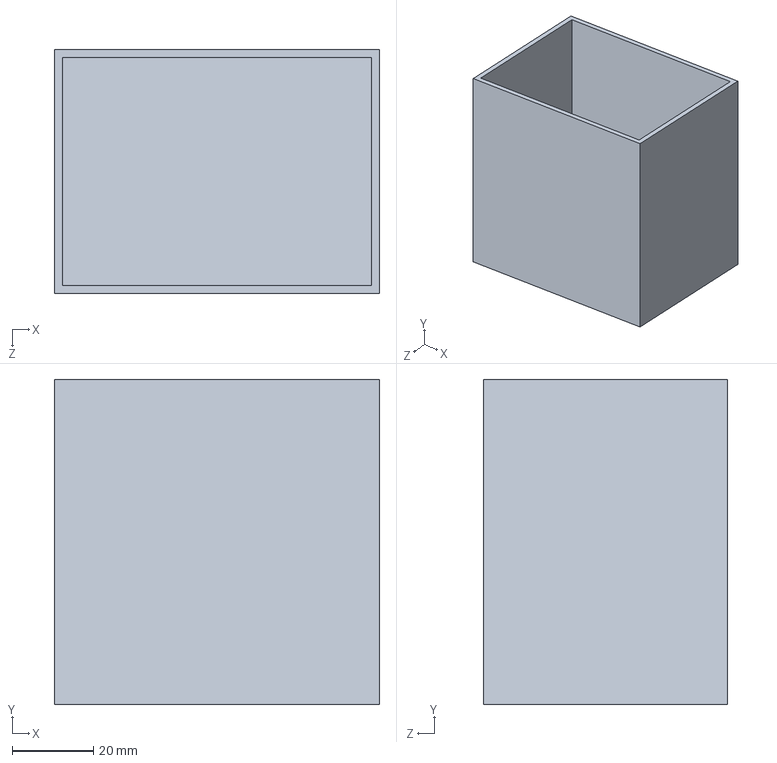
[picture p45: CAD file, 2026-11-12]
模型/省赛/分类盒/盒子.SLDPRT
80.0 x 80.0 x 60.0 mm
