ZLK-AllStar/2026GongChuang/模型/省赛/抓取/圆柱齿轮.SLDPRT

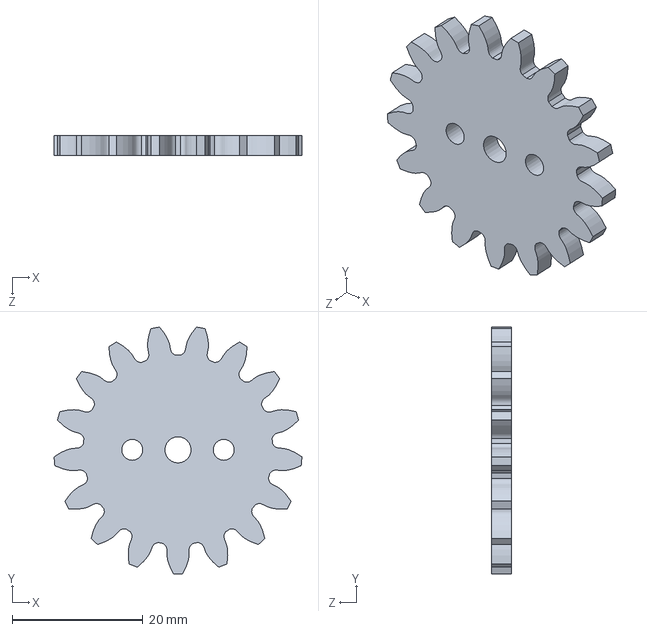
[picture p46: CAD file, 2026-11-12]
模型/省赛/抓取/圆柱齿轮.SLDPRT
37.9 x 37.8 x 3.00 mm
