ZLK-AllStar/2026GongChuang/模型/省赛/框架/挡板.SLDPRT

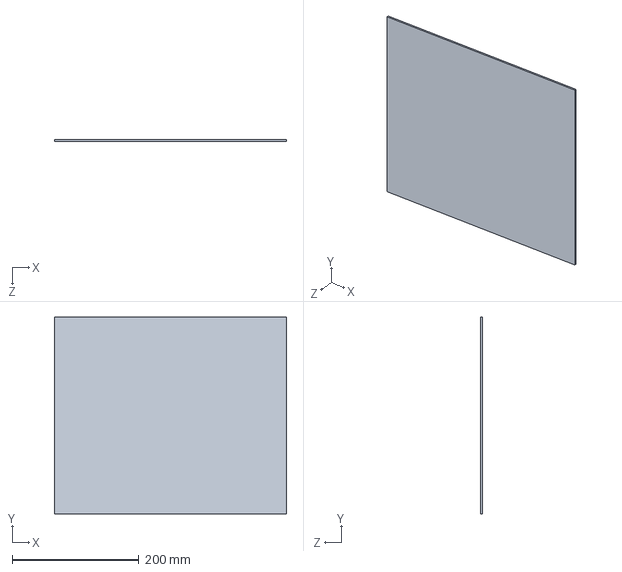
[picture p47: CAD file, 2026-11-12]
模型/省赛/框架/挡板.SLDPRT
366.0 x 310.0 x 3.00 mm
