ZLK-AllStar/2026GongChuang/模型/省赛/滑台/nema17.SLDPRT

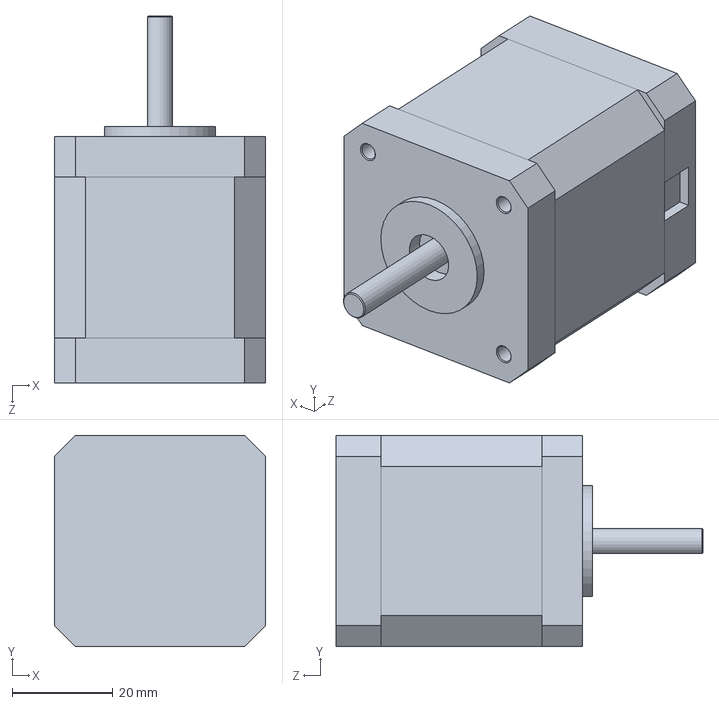
[picture p48: CAD file, 2026-11-12]
模型/省赛/滑台/nema17.SLDPRT
42.0 x 42.0 x 73.0 mm
