ZLK-AllStar/2026GongChuang/模型/省赛/分类盒/电机.SLDPRT

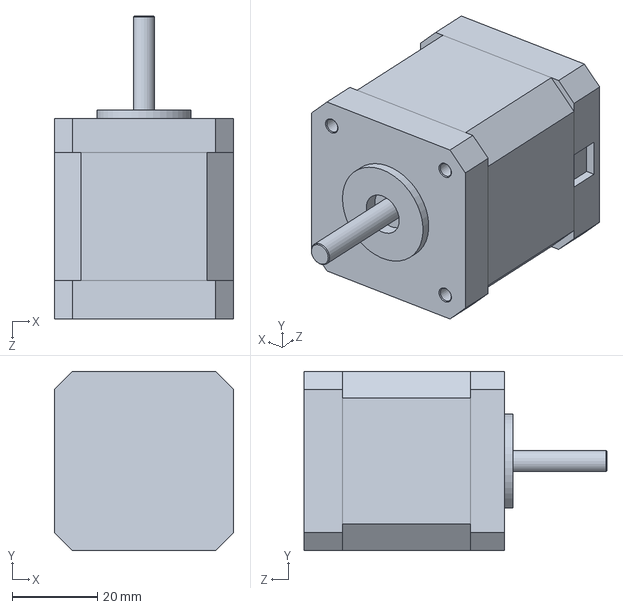
[picture p49: CAD file, 2026-11-12]
模型/省赛/分类盒/电机.SLDPRT
42.0 x 42.0 x 71.0 mm
