ZLK-AllStar/2026GongChuang/模型/省赛/抓取/套壳改.SLDPRT

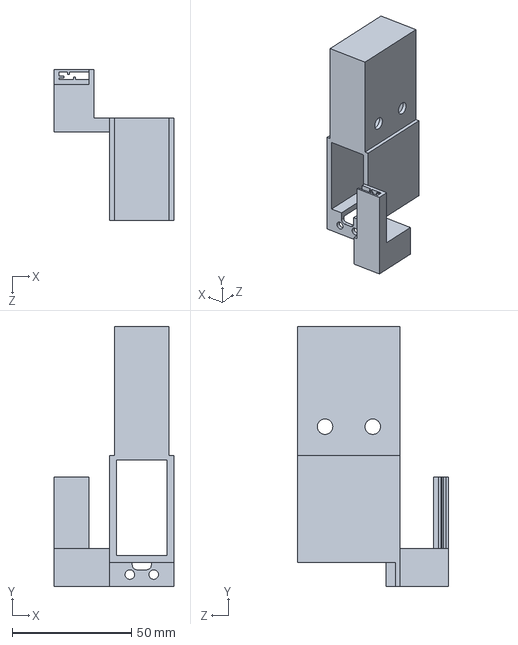
[picture p50: CAD file, 2026-11-12]
模型/省赛/抓取/套壳改.SLDPRT
50.3 x 109.0 x 63.2 mm
