ZLK-AllStar/2026GongChuang/模型/省赛/滑台/Mirror固定电机.SLDPRT

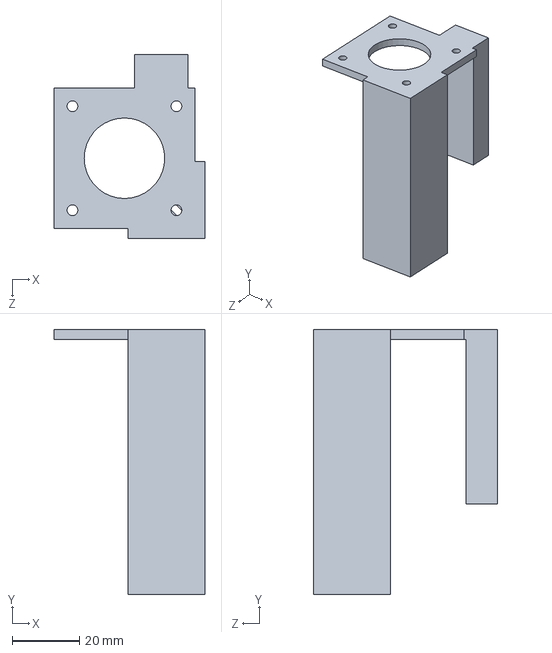
[picture p51: CAD file, 2026-11-12]
模型/省赛/滑台/Mirror固定电机.SLDPRT
45.0 x 79.0 x 55.0 mm
