ZLK-AllStar/2026GongChuang/模型/省赛/滑台/固定电机.SLDPRT

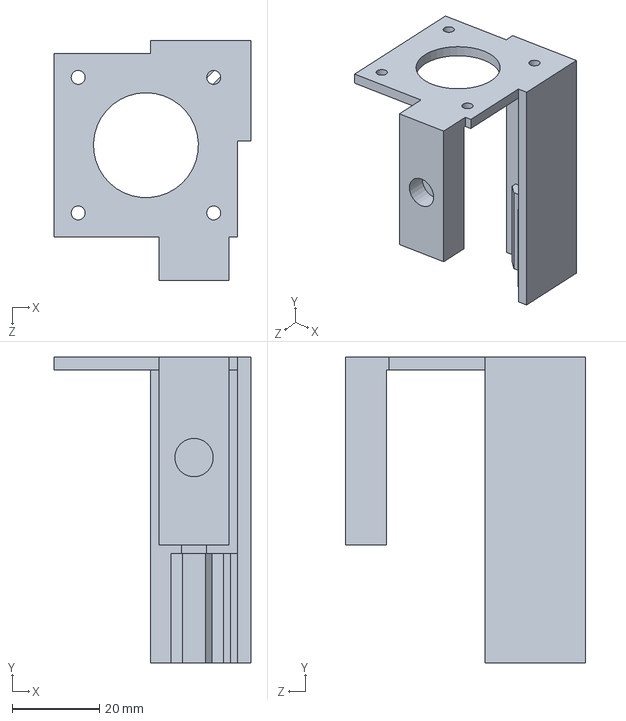
[picture p52: CAD file, 2026-11-12]
模型/省赛/滑台/固定电机.SLDPRT
45.0 x 70.0 x 55.0 mm
