ZLK-AllStar/2026GongChuang/模型/省赛/抓取/齿条.SLDPRT

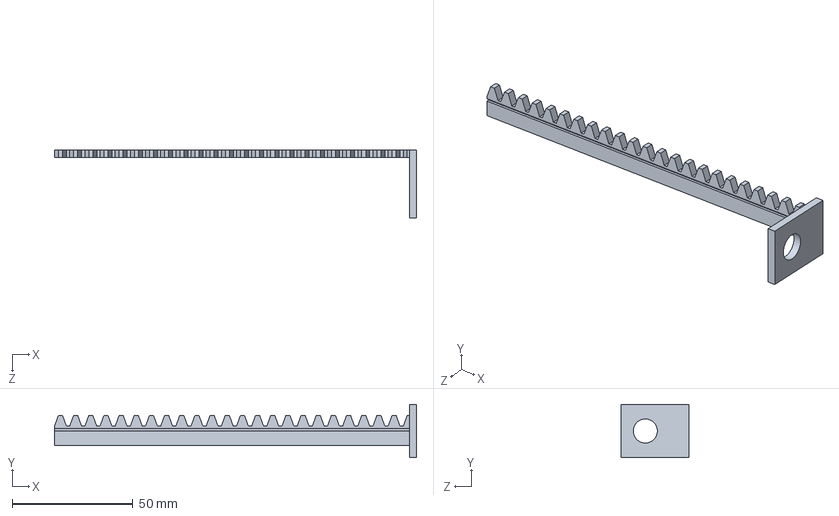
[picture p53: CAD file, 2026-11-12]
模型/省赛/抓取/齿条.SLDPRT
150.0 x 22.0 x 28.0 mm
