ZLK-AllStar/2026GongChuang/模型/省赛/滑台/支座.SLDPRT

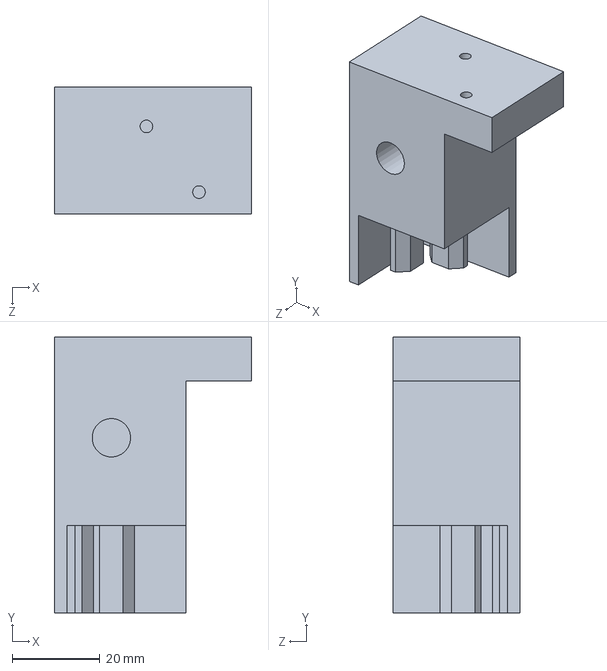
[picture p54: CAD file, 2026-11-12]
模型/省赛/滑台/支座.SLDPRT
45.0 x 63.0 x 29.0 mm
