ZLK-AllStar/2026GongChuang/模型/省赛/滑台/增高台.SLDPRT

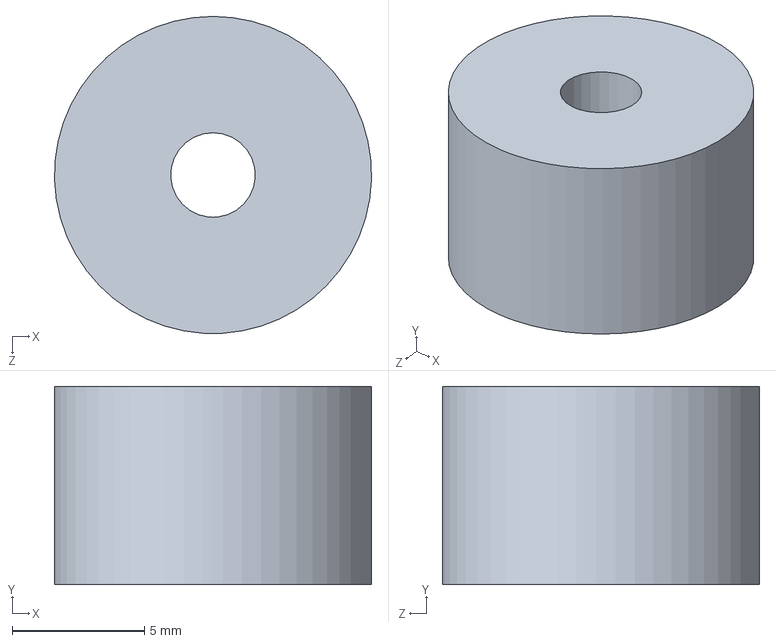
[picture p55: CAD file, 2026-11-12]
模型/省赛/滑台/增高台.SLDPRT
12.0 x 7.50 x 12.0 mm
