ZLK-AllStar/2026GongChuang/模型/省赛/滑台/滑块1.SLDPRT

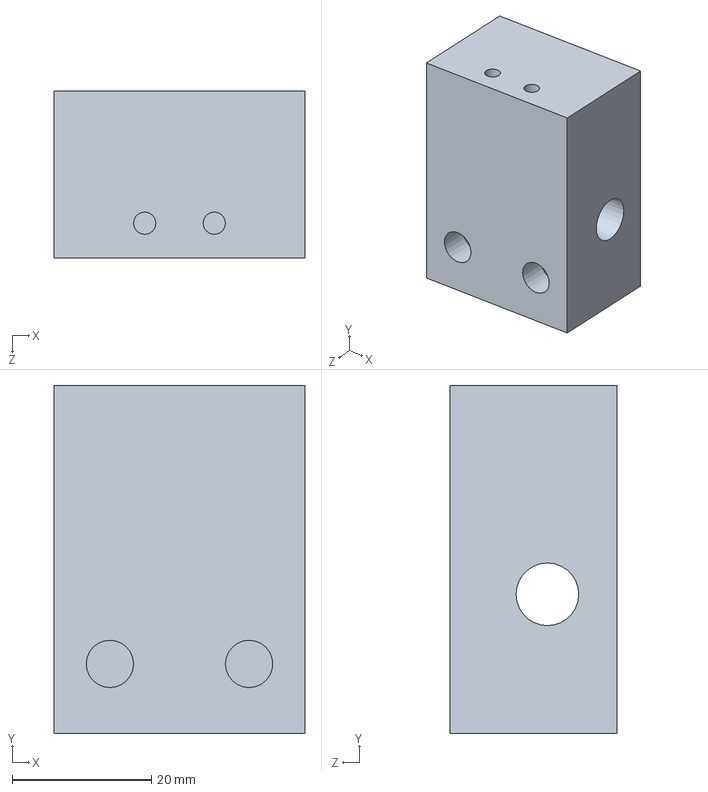
[picture p56: CAD file, 2026-11-12]
模型/省赛/滑台/滑块1.SLDPRT
36.0 x 50.0 x 24.0 mm
