ZLK-AllStar/2026GongChuang/(list of files, cad)

Other CAD files:
模型/省赛/托盘/支撑杆.SLDPRT
模型/省赛/托盘/固定杆.SLDPRT
模型/省赛/抓取/升降固定.SLDPRT
模型/省赛/滑台/rod_y printhead_.SLDPRT
模型/省赛/滑台/Mirror支座.SLDPRT
模型/省赛/滑台/rod_x axis_337x8.SLDPRT
