ZLK-AllStar/2026GongChuang/MDK-ARM/build_host_log.txt

*** Using Compiler 'V5.06 update 7 (build 960)', folder: 'D:\Keil_v5\ARM\ARMCC\Bin'
Build target 'HUATAI'
compiling main.c...
linking...
Program Size: Code=18978 RO-data=722 RW-data=80 ZI-data=7464  
FromELF: creating hex file...
"HUATAI\HUATAI.axf" - 0 Error(s), 0 Warning(s).
Build Time Elapsed:  00:00:02
