ZLK-AllStar/2026GongChuang/MDK-ARM/build_sweep_log.txt

*** Using Compiler 'V5.06 update 7 (build 960)', folder: 'D:\Keil_v5\ARM\ARMCC\Bin'
Rebuild target 'HUATAI'
assembling startup_stm32f407xx.s...
compiling pick_place.c...
compiling gpio.c...
compiling dma.c...
compiling hmi_link.c...
compiling tft_lcd.c...
compiling app_display.c...
compiling spi.c...
compiling tim.c...
compiling host_link.c...
compiling tray_motor.c...
compiling aux_servo.c...
compiling main.c...
compiling vacuum.c...
compiling Emm_V5.c...
compiling xy_stage.c...
compiling usart.c...
compiling stm32f4xx_it.c...
compiling stm32f4xx_hal_msp.c...
compiling stm32f4xx_hal_flash.c...
compiling stm32f4xx_hal_flash_ramfunc.c...
compiling stm32f4xx_hal_pwr.c...
compiling stm32f4xx_hal_rcc_ex.c...
compiling stm32f4xx_hal_flash_ex.c...
compiling stm32f4xx_hal_exti.c...
compiling stm32f4xx_hal_dma.c...
compiling stm32f4xx_hal.c...
compiling stm32f4xx_hal_rcc.c...
compiling stm32f4xx_hal_gpio.c...
compiling stm32f4xx_hal_pwr_ex.c...
compiling stm32f4xx_hal_cortex.c...
compiling stm32f4xx_hal_dma_ex.c...
compiling stm32f4xx_hal_spi.c...
compiling system_stm32f4xx.c...
compiling stm32f4xx_hal_tim_ex.c...
compiling stm32f4xx_hal_uart.c...
compiling stm32f4xx_hal_tim.c...
linking...
Program Size: Code=17450 RO-data=874 RW-data=84 ZI-data=7364  
FromELF: creating hex file...
"HUATAI\HUATAI.axf" - 0 Error(s), 0 Warning(s).
Build Time Elapsed:  00:00:07
