ZLK-AllStar/2026GongChuang/MDK-ARM/build_check_log.txt

*** Using Compiler 'V5.06 update 7 (build 960)', folder: 'D:\Keil_v5\ARM\ARMCC\Bin'
Build target 'HUATAI'
compiling gpio.c...
compiling hmi_link.c...
compiling app_display.c...
compiling tft_lcd.c...
compiling screen.c...
linking...
Program Size: Code=19182 RO-data=58510 RW-data=144 ZI-data=84120  
FromELF: creating hex file...
"HUATAI\HUATAI.axf" - 0 Error(s), 0 Warning(s).
Build Time Elapsed:  00:00:03
