ZLK-AllStar/2026GongChuang/MDK-ARM/build_log_after_scatter_removal.txt

*** Using Compiler 'V5.06 update 7 (build 960)', folder: 'D:\Keil_v5\ARM\ARMCC\Bin'
Rebuild target 'HUATAI'
compiling geometry_assets.c...
assembling startup_stm32f407xx.s...
compiling aux_servo.c...
compiling vacuum.c...
compiling dma.c...
compiling tft_lcd.c...
compiling spi.c...
compiling hmi_link.c...
compiling pick_place.c...
compiling screen.c...
compiling main.c...
../Core/Src/main.c(444): warning:  #177-D: function "App_RunHostCommandLoop"  was declared but never referenced
  static void App_RunHostCommandLoop(void)
../Core/Src/main.c: 1 warning, 0 errors
compiling app_display.c...
compiling host_link.c...
compiling ext_sram.c...
compiling xy_stage.c...
compiling gpio.c...
compiling Emm_V5.c...
compiling tray_motor.c...
compiling stm32f4xx_hal_msp.c...
compiling tim.c...
compiling usart.c...
compiling stm32f4xx_it.c...
compiling stm32f4xx_hal_rcc_ex.c...
compiling stm32f4xx_hal_gpio.c...
compiling stm32f4xx_hal_pwr.c...
compiling stm32f4xx_hal_flash_ramfunc.c...
compiling stm32f4xx_hal_cortex.c...
compiling stm32f4xx_hal_flash_ex.c...
compiling stm32f4xx_hal_pwr_ex.c...
compiling stm32f4xx_hal_flash.c...
compiling stm32f4xx_hal_dma.c...
compiling stm32f4xx_hal_rcc.c...
compiling stm32f4xx_hal_spi.c...
compiling stm32f4xx_hal_dma_ex.c...
compiling stm32f4xx_hal_exti.c...
compiling stm32f4xx_hal.c...
compiling system_stm32f4xx.c...
compiling stm32f4xx_hal_tim_ex.c...
compiling stm32f4xx_hal_uart.c...
compiling stm32f4xx_hal_tim.c...
linking...
Program Size: Code=17786 RO-data=794 RW-data=108 ZI-data=84020  
FromELF: creating hex file...
"HUATAI\HUATAI.axf" - 0 Error(s), 1 Warning(s).
Build Time Elapsed:  00:00:08
