ZLK-AllStar/2026GongChuang/Core/Src/main.c

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
/* Includes ------------------------------------------------------------------*/
#include "main.h"
#include "dma.h"
#include "spi.h"
#include "tim.h"
#include "usart.h"
#include "gpio.h"

/* USER CODE BEGIN Includes */
#include "app_controller.h"
#include "app_runtime.h"
#include "app_display.h"
#include "app_mode.h"
#include "board_io.h"
#include "shell_port.h"
#include "xy_stage.h"
#include "tray_motor.h"
#include "vacuum.h"
#include "aux_servo.h"
#include "hmi_link.h"
/* USER CODE END Includes */


void SystemClock_Config(void);
/**
  * @brief  The application entry point.
  * @retval int
  */
int main(void)
{

  /* MCU Configuration--------------------------------------------------------*/

  /* Reset of all peripherals, Initializes the Flash interface and the Systick. */
  HAL_Init();

  /* Configure the system clock */
  SystemClock_Config();

  /* USER CODE BEGIN SysInit */
  BoardIO_Init();
  AppMode_SelectAtBoot();
/* USER CODE END SysInit */

  /* Initialize all configured peripherals */
  MX_GPIO_Init();
  MX_DMA_Init();
  MX_SPI1_Init();
  MX_TIM1_Init();
  MX_USART1_UART_Init();
  MX_TIM3_Init();
  MX_USART2_UART_Init();
  MX_USART3_UART_Init();
  MX_TIM2_Init();
  MX_TIM4_Init();
  MX_TIM8_Init();
  MX_TIM9_Init();
  MX_TIM13_Init();
  MX_UART5_Init();
  /* USER CODE BEGIN 2 */
  __HAL_UART_CLEAR_IDLEFLAG(&huart1);
  __HAL_UART_ENABLE_IT(&huart1, UART_IT_IDLE);
  UART_RxQueueReset();
  HAL_UART_Receive_DMA(&huart1, (uint8_t *)rxDmaBuffer, CMD_LEN);
  AppDisplay_Init();
  HMI_LinkInit();
  XY_SetPositionCallback(AppDisplay_SetPosition);
  Vacuum_SetStatusCallback(AppDisplay_SetVacuumState);
  Vacuum_Init();
  AuxServo_Init();
  if (XY_Init() == XY_RESULT_OK) { (void)XY_SetZero(); }
  (void)Tray_Init();
  if (!XY_IsOriginValid()) { AppDisplay_SetCommand(XY_GetDiagnosticText()); }
  else if (!Tray_IsOriginValid()) { AppDisplay_SetCommand(Tray_GetDiagnosticText()); }
  AppController_Init();
  if (AppMode_Get() == APP_MODE_DEBUG) { ShellPort_Init(); }
/* USER CODE END 2 */

  /* Infinite loop */
  /* USER CODE BEGIN WHILE */
  while (1)
  {
    /* USER CODE END WHILE */

    /* USER CODE BEGIN 3 */
    if (AppMode_Get() == APP_MODE_HOST) { AppController_Poll(); }
    else { ShellPort_Poll(); }
    AppRuntime_Service();
  }
/* USER CODE END 3 */
}

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
