ZLK-AllStar/2026GongChuang/Core/Inc/main.h

#define DC_Pin GPIO_PIN_12
#define DC_GPIO_Port GPIOF
#define BLK_Pin GPIO_PIN_12
#define BLK_GPIO_Port GPIOB
#define CS_Pin GPIO_PIN_13
#define CS_GPIO_Port GPIOB
#define RST_Pin GPIO_PIN_15
#define RST_GPIO_Port GPIOB
#define BTN_Pin GPIO_PIN_2
#define BTN_GPIO_Port GPIOE
