ZLK-AllStar/2026GongChuang/Core/Src/geometry_assets.c

#include "geometry_assets.h"

const uint16_t GeometryAssets[GEOMETRY_ASSET_COUNT][GEOMETRY_ASSET_SIZE * GEOMETRY_ASSET_SIZE] = {
  {
    0xFFFFU, 0xFFFFU, 0xFFFFU, 0xFFFFU, 0xFFFFU, 0xFFFFU, 0xFFFFU, 0xFFFFU, 0xFFFFU, 0xFFFFU, 0xFFFFU, 0xFFFFU, 0xFFFFU, 0xFFFFU, 0xFFFFU, 0xFFFFU,
    0xFFFFU, 0xFFFFU, 0xFFFFU, 0xFFFFU, 0xFFFFU, 0xFFFFU, 0xFFFFU, 0xFFFFU, 0xFFFFU, 0xFFFFU, 0xFFFFU, 0xFFFFU, 0xFFFFU, 0xFFFFU, 0xFFFFU, 0xFFFFU,
    0xFFFFU, 0xFFFFU, 0xFFFFU, 0xFFFFU, 0xFFFFU, 0xFFFFU, 0xFFFFU, 0xFFFFU, 0xFFFFU, 0xFFFFU, 0xFFFFU, 0xFFFFU, 0xFFFFU, 0xFFFFU, 0xFFFFU, 0xFFFFU,
    0xFFFFU, 0xFFFFU, 0xFFFFU, 0xFFFFU, 0xFFFFU, 0xFFFFU, 0xFFFFU, 0xFFFFU, 0xFFFFU, 0xFFFFU, 0xFFFFU, 0xFFFFU, 0xFFFFU, 0xFFFFU, 0xFFFFU, 0xFFFFU,
    0xFFFFU, 0xFFFFU, 0xFFFFU, 0xFFFFU, 0xFFFFU, 0xF410U, 0xED55U, 0xFFFFU, 0xFFFFU, 0xFFFFU, 0xFFFFU, 0xFFFFU, 0xFFFFU, 0xFFFFU, 0xFFFFU, 0xFFFFU,
    0xFFFFU, 0xFFFFU, 0xFFFFU, 0xFFFFU, 0xFFFFU, 0xFFFFU, 0xFFFFU, 0xFFFFU, 0xFEDBU, 0xF000U, 0xC104U, 0xFFBEU, 0xFFFFU, 0xFFFFU, 0xFFFFU, 0xFFFFU,
    0xFFFFU, 0xFFFFU, 0xFFFFU, 0xFFFFU, 0xFFFFU, 0xFFFFU, 0xFFFFU, 0xFFFFU, 0xFFFFU, 0xFFFFU, 0xFFFFU, 0xFFFFU, 0xF9E7U, 0xF800U, 0xB000U, 0xD3AEU,
    0xFFFFU, 0xFFDFU, 0xFFFFU, 0xFFFFU, 0xFFFFU, 0xFFFFU, 0xFFFFU, 0xFFFFU, 0xFFFFU, 0xFFFFU, 0xFFFFU, 0xFFFFU, 0xFFFFU, 0xFFFFU, 0xFFFFU, 0xFCB2U,
    0xF800U, 0xF820U, 0xB800U, 0xB000U, 0xF679U, 0xFFFFU, 0xFFFFU, 0xFFFFU, 0xFFFFU, 0xFFFFU, 0xFFFFU, 0xFFFFU, 0xFFFFU, 0xFFFFU, 0xFFFFU, 0xFFFFU,
    0xFFFFU, 0xFFFFU, 0xFF1CU, 0xF861U, 0xF800U, 0xF800U, 0xB820U, 0xA800U, 0xC1A6U, 0xFFFFU, 0xFFFFU, 0xFFFFU, 0xFFFFU, 0xFFFFU, 0xFFFFU, 0xFFFFU,
    0xFFFFU, 0xFFFFU, 0xFFFFU, 0xFFFFU, 0xFFDFU, 0xFFFFU, 0xFA69U, 0xF800U, 0xF800U, 0xF800U, 0xB800U, 0xB000U, 0xA800U, 0xDC71U, 0xFFFFU, 0xFFDFU,
    0xFFFFU, 0xFFFFU, 0xFFFFU, 0xFFFFU, 0xFFFFU, 0xFFFFU, 0xFFFFU, 0xFFFFU, 0xFFFFU, 0xFD34U, 0xF800U, 0xF820U, 0xF800U, 0xF800U, 0xB800U, 0xB000U,
    0xB000U, 0xB041U, 0xF6FBU, 0xFFFFU, 0xFFFFU, 0xFFFFU, 0xFFFFU, 0xFFFFU, 0xFFFFU, 0xFFFFU, 0xFFFFU, 0xFFFFU, 0xFF5DU, 0xF8A2U, 0xF800U, 0xF800U,
    0xF800U, 0xF800U, 0xB800U, 0xB000U, 0xB000U, 0xA800U, 0xCA49U, 0xFFFFU, 0xFFFFU, 0xFFFFU, 0xFFFFU, 0xFFFFU, 0xFFFFU, 0xFFFFU, 0xFFFFU, 0xFFFFU,
    0xFAEBU, 0xF800U, 0xF800U, 0xF800U, 0xF800U, 0xF800U, 0xB800U, 0xB000U, 0xB000U, 0xB020U, 0xA800U, 0xE534U, 0xFFFFU, 0xFFFFU, 0xFFFFU, 0xFFFFU,
    0xFFFFU, 0xFFFFU, 0xFFFFU, 0xFD96U, 0xF800U, 0xF820U, 0xF800U, 0xF800U, 0xF800U, 0xF800U, 0xC000U, 0xB000U, 0xB000U, 0xB000U, 0xB000U, 0xB8C3U,
    0xFF5DU, 0xFFFFU, 0xFFFFU, 0xFFFFU, 0xFFFFU, 0xFFFFU, 0xFFDFU, 0xF986U, 0xF800U, 0xF800U, 0xF800U, 0xF800U, 0xF800U, 0xF800U, 0xC000U, 0xB000U,
    0xB000U, 0xB000U, 0xB000U, 0xA800U, 0xD30CU, 0xFFFFU, 0xFFFFU, 0xFFFFU, 0xFFFFU, 0xFFFFU, 0xFFFFU, 0xFF1CU, 0xFC71U, 0xF945U, 0xF800U, 0xF800U,
    0xF800U, 0xF820U, 0xC020U, 0xB000U, 0xB000U, 0xA800U, 0xB0A2U, 0xD38EU, 0xF69AU, 0xFFFFU, 0xFFFFU, 0xFFFFU, 0xFFFFU, 0xFFFFU, 0xFFFFU, 0xFFFFU,
    0xFFFFU, 0xFFDFU, 0xFD75U, 0xFA49U, 0xF800U, 0xF800U, 0xC000U, 0xA800U, 0xB924U, 0xDC51U, 0xFF3CU, 0xFFFFU, 0xFFFFU, 0xFFFFU, 0xFFFFU, 0xFFFFU,
    0xFFFFU, 0xFFFFU, 0xFFFFU, 0xFFFFU, 0xFFDFU, 0xFFFFU, 0xFFFFU, 0xFFFFU, 0xFE79U, 0xFB2CU, 0xD1E7U, 0xE534U, 0xFFBEU, 0xFFFFU, 0xFFFFU, 0xFFFFU,
    0xFFFFU, 0xFFFFU, 0xFFFFU, 0xFFFFU, 0xFFFFU, 0xFFFFU, 0xFFFFU, 0xFFFFU, 0xFFFFU, 0xFFFFU, 0xFFFFU, 0xFFFFU, 0xFFFFU, 0xFFFFU, 0xFFFFU, 0xFFFFU,
    0xFFFFU, 0xFFDFU, 0xFFFFU, 0xFFFFU, 0xFFFFU, 0xFFFFU, 0xFFFFU, 0xFFFFU, 0xFFFFU, 0xFFFFU, 0xFFFFU, 0xFFFFU, 0xFFFFU, 0xFFFFU, 0xFFFFU, 0xFFFFU,
    0xFFFFU, 0xFFFFU, 0xFFFFU, 0xFFFFU, 0xFFFFU, 0xFFFFU, 0xFFFFU, 0xFFFFU, 0xFFFFU, 0xFFFFU, 0xFFFFU, 0xFFFFU, 0xFFFFU, 0xFFFFU, 0xFFFFU, 0xFFFFU,
    0xFFFFU, 0xFFFFU, 0xFFFFU, 0xFFFFU, 0xFFFFU, 0xFFFFU, 0xFFFFU, 0xFFFFU, 0xFFFFU, 0xFFFFU, 0xFFFFU, 0xFFFFU, 0xFFFFU, 0xFFFFU, 0xFFFFU, 0xFFFFU,
  },
  {
    0xFFFFU, 0xFFFFU, 0xFFFFU, 0xFFFFU, 0xFFFFU, 0xFFFFU, 0xFFFFU, 0xFFFFU, 0xFFFFU, 0xFFFFU, 0xFFFFU, 0xFFFFU, 0xFFFFU, 0xFFFFU, 0xFFFFU, 0xFFFFU,
    0xFFFFU, 0xFFFFU, 0xFFFFU, 0xFFFFU, 0xFFFFU, 0xFFFFU, 0xFFFFU, 0xFFFFU, 0xFFFFU, 0xFFFFU, 0xFFFFU, 0xFFFFU, 0xFFFFU, 0xFFFFU, 0xFFFFU, 0xFFFFU,
    0xFFFFU, 0xFFFFU, 0xFFFFU, 0xFFFFU, 0xFFFFU, 0xFFFFU, 0xFFFFU, 0xFFFFU, 0xFFFFU, 0xFFFFU, 0xFFFFU, 0xFFFFU, 0xFFFFU, 0xFFFFU, 0xFFFFU, 0xFFFFU,
    0xFFFFU, 0xFFFFU, 0xFFFFU, 0xFFFFU, 0xFFFFU, 0xFFFFU, 0xFFFFU, 0xFFFFU, 0xFFFFU, 0xFFFFU, 0xFFFFU, 0xFFFFU, 0xFFFFU, 0xFFFFU, 0xFFFFU, 0xFFFFU,
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
    0xFFFFU, 0xFFFFU, 0xFFFFU, 0xFFFFU, 0xFFFFU, 0xFFFFU, 0xFFFFU, 0xFFFFU, 0xFFFFU, 0xFFFFU, 0xFFFFU, 0xFFFFU, 0xFFFFU, 0xFFFFU, 0xFFFFU, 0xFFFFU,
    0xFFFFU, 0xFFFFU, 0xFFFFU, 0xFFFFU, 0xFFFFU, 0xFFFFU, 0xFFFFU, 0xFFFFU, 0xFFFFU, 0xFFFFU, 0xFFFFU, 0xFFFFU, 0xFFFFU, 0xFFFFU, 0xFFFFU, 0xFFFFU,
    0xFFFFU, 0xFFFFU, 0xFFFFU, 0xFFFFU, 0xFFFFU, 0x86F0U, 0xAF15U, 0xFFFFU, 0xFFFFU, 0xFFFFU, 0xFFFFU, 0xFFFFU, 0xFFFFU, 0xFFFFU, 0xFFFFU, 0xFFFFU,
    0xFFFFU, 0xFFFFU, 0xFFFFU, 0xFFFFU, 0xFFFFU, 0xFFFFU, 0xFFFFU, 0xFFFFU, 0xDFDBU, 0x0600U, 0x2544U, 0xF7DEU, 0xFFFFU, 0xFFFFU, 0xFFFFU, 0xFFFFU,
    0xFFFFU, 0xFFFFU, 0xFFFFU, 0xFFFFU, 0xFFFFU, 0xFFFFU, 0xFFFFU, 0xFFFFU, 0xFFFFU, 0xFFFFU, 0xFFFFU, 0xFFFFU, 0x3EC7U, 0x0620U, 0x04A0U, 0x762EU,
    0xFFFFU, 0xFFFFU, 0xFFFFU, 0xFFFFU, 0xFFFFU, 0xFFFFU, 0xFFFFU, 0xFFFFU, 0xFFFFU, 0xFFFFU, 0xFFFFU, 0xFFFFU, 0xFFFFU, 0xFFFFU, 0xFFFFU, 0x9752U,
    0x0640U, 0x0640U, 0x04E0U, 0x04A0U, 0xCF59U, 0xFFFFU, 0xFFFFU, 0xFFFFU, 0xFFFFU, 0xFFFFU, 0xFFFFU, 0xFFFFU, 0xFFFFU, 0xFFFFU, 0xFFFFU, 0xFFFFU,
    0xFFFFU, 0xFFFFU, 0xE7DCU, 0x0E61U, 0x0660U, 0x0640U, 0x04E0U, 0x0480U, 0x3566U, 0xFFFFU, 0xFFFFU, 0xFFFFU, 0xFFFFU, 0xFFFFU, 0xFFFFU, 0xFFFFU,
    0xFFFFU, 0xFFFFU, 0xFFFFU, 0xFFFFU, 0xFFFFU, 0xFFFFU, 0x4EC9U, 0x0640U, 0x0660U, 0x0640U, 0x04E0U, 0x04C0U, 0x0480U, 0x8E91U, 0xFFFFU, 0xFFFFU,
    0xFFFFU, 0xFFFFU, 0xFFFFU, 0xFFFFU, 0xFFFFU, 0xFFFFU, 0xFFFFU, 0xFFFFU, 0xFFFFU, 0xA774U, 0x0640U, 0x0660U, 0x0660U, 0x0640U, 0x04E0U, 0x04C0U,
    0x04C0U, 0x0CC1U, 0xDF9BU, 0xFFFFU, 0xFFFFU, 0xFFFFU, 0xFFFFU, 0xFFFFU, 0xFFFFU, 0xFFFFU, 0xFFFFU, 0xFFFFU, 0xEFDDU, 0x1682U, 0x0640U, 0x0660U,
    0x0660U, 0x0640U, 0x0500U, 0x04A0U, 0x04C0U, 0x0480U, 0x4DA9U, 0xFFFFU, 0xFFFFU, 0xFFFFU, 0xFFFFU, 0xFFFFU, 0xFFFFU, 0xFFFFU, 0xFFFFU, 0xFFFFU,
    0x5EEBU, 0x0640U, 0x0660U, 0x0660U, 0x0660U, 0x0660U, 0x0500U, 0x04A0U, 0x04C0U, 0x04C0U, 0x0480U, 0xA6D4U, 0xFFFFU, 0xFFFFU, 0xFFFFU, 0xFFFFU,
    0xFFFFU, 0xFFFFU, 0xFFFFU, 0xB776U, 0x0640U, 0x0660U, 0x0660U, 0x0660U, 0x0660U, 0x0660U, 0x0500U, 0x04A0U, 0x04C0U, 0x04C0U, 0x04A0U, 0x1D03U,
    0xEFBDU, 0xFFFFU, 0xFFFFU, 0xFFFFU, 0xFFFFU, 0xFFFFU, 0xFFFFU, 0x36A6U, 0x0620U, 0x0640U, 0x0660U, 0x0660U, 0x0660U, 0x0660U, 0x0500U, 0x04A0U,
    0x04C0U, 0x04C0U, 0x04C0U, 0x0440U, 0x660CU, 0xFFFFU, 0xFFFFU, 0xFFFFU, 0xFFFFU, 0xFFFFU, 0xFFFFU, 0xE7DCU, 0x8F51U, 0x2E85U, 0x0640U, 0x0640U,
    0x0660U, 0x0660U, 0x0520U, 0x04C0U, 0x04A0U, 0x0480U, 0x14E2U, 0x762EU, 0xD77AU, 0xFFFFU, 0xFFFFU, 0xFFFFU, 0xFFFFU, 0xFFFFU, 0xFFFFU, 0xFFFFU,
    0xFFFFU, 0xFFFFU, 0xAF75U, 0x4EC9U, 0x0640U, 0x0640U, 0x0500U, 0x0480U, 0x2524U, 0x8E71U, 0xE7BCU, 0xFFFFU, 0xFFFFU, 0xFFFFU, 0xFFFFU, 0xFFFFU,
    0xFFFFU, 0xFFFFU, 0xFFFFU, 0xFFFFU, 0xFFFFU, 0xFFFFU, 0xFFFFU, 0xFFFFU, 0xCFB9U, 0x670CU, 0x3DC7U, 0xA6D4U, 0xF7FEU, 0xFFFFU, 0xFFFFU, 0xFFFFU,
    0xFFFFU, 0xFFFFU, 0xFFFFU, 0xFFFFU, 0xFFFFU, 0xFFFFU, 0xFFFFU, 0xFFFFU, 0xFFFFU, 0xFFFFU, 0xFFFFU, 0xFFFFU, 0xFFFFU, 0xFFFFU, 0xFFFFU, 0xFFFFU,
    0xFFFFU, 0xFFFFU, 0xFFFFU, 0xFFFFU, 0xFFFFU, 0xFFFFU, 0xFFFFU, 0xFFFFU, 0xFFFFU, 0xFFFFU, 0xFFFFU, 0xFFFFU, 0xFFFFU, 0xFFFFU, 0xFFFFU, 0xFFFFU,
    0xFFFFU, 0xFFFFU, 0xFFFFU, 0xFFFFU, 0xFFFFU, 0xFFFFU, 0xFFFFU, 0xFFFFU, 0xFFFFU, 0xFFFFU, 0xFFFFU, 0xFFFFU, 0xFFFFU, 0xFFFFU, 0xFFFFU, 0xFFFFU,
    0xFFFFU, 0xFFFFU, 0xFFFFU, 0xFFFFU, 0xFFFFU, 0xFFFFU, 0xFFFFU, 0xFFFFU, 0xFFFFU, 0xFFFFU, 0xFFFFU, 0xFFFFU, 0xFFFFU, 0xFFFFU, 0xFFFFU, 0xFFFFU,
  },
  {
    0xFFFFU, 0xFFFFU, 0xFFFFU, 0xFFFFU, 0xFFFFU, 0xFFFFU, 0xFFFFU, 0xFFFFU, 0xFFFFU, 0xFFFFU, 0xFFFFU, 0xFFFFU, 0xFFFFU, 0xFFFFU, 0xFFFFU, 0xFFFFU,
    0xFFFFU, 0xFFFFU, 0xFFFFU, 0xFFFFU, 0xFFFFU, 0xFFFFU, 0xFFFFU, 0xFFFFU, 0xFFFFU, 0xFFFFU, 0xFFFFU, 0xFFFFU, 0xFFFFU, 0xFFFFU, 0xFFFFU, 0xFFFFU,
    0xFFFFU, 0xFFFFU, 0xFFFFU, 0xFFFFU, 0xFFFFU, 0xFFFFU, 0xFFFFU, 0xFFFFU, 0xFFFFU, 0xFFFFU, 0xFFFFU, 0xFFFFU, 0xFFFFU, 0xFFFFU, 0xFFFFU, 0xFFFFU,
    0xFFFFU, 0xFFFFU, 0xFFFFU, 0xFFFFU, 0xFFFFU, 0xFFFFU, 0xFFFFU, 0xFFFFU, 0xFFFFU, 0xFFFFU, 0xFFFFU, 0xFFFFU, 0xFFFFU, 0xFFFFU, 0xFFFFU, 0xFFFFU,
    0xFFFFU, 0xFFFFU, 0xFFFFU, 0xFFFFU, 0xFFFFU, 0x8F1CU, 0xA71CU, 0xFFFFU, 0xFFFFU, 0xFFFFU, 0xFFFFU, 0xFFFFU, 0xFFFFU, 0xFFFFU, 0xFFFFU, 0xFFFFU,
    0xFFFFU, 0xFFFFU, 0xFFFFU, 0xFFFFU, 0xFFFFU, 0xFFFFU, 0xFFFFU, 0xFFFFU, 0xE7DFU, 0x0638U, 0x1D34U, 0xF7DFU, 0xFFFFU, 0xFFFFU, 0xFFFFU, 0xFFFFU,
    0xFFFFU, 0xFFFFU, 0xFFFFU, 0xFFFFU, 0xFFFFU, 0xFFFFU, 0xFFFFU, 0xFFFFU, 0xFFFFU, 0xFFFFU, 0xFFFFU, 0xFFFFU, 0x4EFBU, 0x0659U, 0x04B2U, 0x6E18U,
    0xFFFFU, 0xFFFFU, 0xFFFFU, 0xFFFFU, 0xFFFFU, 0xFFFFU, 0xFFFFU, 0xFFFFU, 0xFFFFU, 0xFFFFU, 0xFFFFU, 0xFFFFU, 0xFFFFU, 0xFFFFU, 0xFFFFU, 0xA77DU,
    0x0659U, 0x0659U, 0x04F3U, 0x04B2U, 0xC75DU, 0xFFFFU, 0xFFFFU, 0xFFFFU, 0xFFFFU, 0xFFFFU, 0xFFFFU, 0xFFFFU, 0xFFFFU, 0xFFFFU, 0xFFFFU, 0xFFFFU,
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
    0xFFFFU, 0xFFFFU, 0xFFFFU, 0xFFFFU, 0xFFFFU, 0xFFFFU, 0xFFFFU, 0xFFFFU, 0xFFFFU, 0xFFFFU, 0xFFFFU, 0xFFFFU, 0xFFFFU, 0xFFFFU, 0xFFFFU, 0xFFFFU,
    0xFFFFU, 0xFFFFU, 0xFFFFU, 0xFFFFU, 0xFFFFU, 0xFFFFU, 0xFFFFU, 0xFFFFU, 0xFFFFU, 0xFFFFU, 0xFFFFU, 0xFFFFU, 0xFFFFU, 0xFFFFU, 0xFFFFU, 0xFFFFU,
    0xFFFFU, 0xFFFFU, 0xFFFFU, 0xFFFFU, 0xFFFFU, 0xDEDBU, 0xCE79U, 0xFFFFU, 0xFFFFU, 0xFFFFU, 0xFFFFU, 0xFFFFU, 0xFFFFU, 0xFFFFU, 0xFFFFU, 0xFFFFU,
    0xFFFFU, 0xFFFFU, 0xFFFFU, 0xFFFFU, 0xFFFFU, 0xFFFFU, 0xFFFFU, 0xFFFFU, 0xFFDFU, 0xA534U, 0x7BCFU, 0xF7BEU, 0xFFFFU, 0xFFFFU, 0xFFFFU, 0xFFFFU,
    0xFFFFU, 0xFFFFU, 0xFFFFU, 0xFFFFU, 0xFFFFU, 0xFFFFU, 0xFFFFU, 0xFFFFU, 0xFFFFU, 0xFFFFU, 0xFFFFU, 0xFFFFU, 0xCE59U, 0xA514U, 0x6B4DU, 0xA534U,
    0xFFFFU, 0xFFFFU, 0xFFFFU, 0xFFFFU, 0xFFFFU, 0xFFFFU, 0xFFFFU, 0xFFFFU, 0xFFFFU, 0xFFFFU, 0xFFFFU, 0xFFFFU, 0xFFFFU, 0xFFFFU, 0xFFFFU, 0xE73CU,
    0xA514U, 0xA534U, 0x73AEU, 0x630CU, 0xDEDBU, 0xFFFFU, 0xFFFFU, 0xFFFFU, 0xFFFFU, 0xFFFFU, 0xFFFFU, 0xFFFFU, 0xFFFFU, 0xFFFFU, 0xFFFFU, 0xFFFFU,
    0xFFFFU, 0xFFFFU, 0xFFDFU, 0xB596U, 0xA514U, 0xA534U, 0x73AEU, 0x630CU, 0x8410U, 0xFFDFU, 0xFFFFU, 0xFFFFU, 0xFFFFU, 0xFFFFU, 0xFFFFU, 0xFFFFU,
    0xFFFFU, 0xFFFFU, 0xFFFFU, 0xFFFFU, 0xFFFFU, 0xFFFFU, 0xCE79U, 0x9CF3U, 0xA534U, 0xA534U, 0x73AEU, 0x6B6DU, 0x630CU, 0xB5B6U, 0xFFFFU, 0xFFFFU,
    0xFFFFU, 0xFFFFU, 0xFFFFU, 0xFFFFU, 0xFFFFU, 0xFFFFU, 0xFFFFU, 0xFFFFU, 0xFFFFU, 0xEF5DU, 0xA514U, 0xA534U, 0xA534U, 0xA534U, 0x73AEU, 0x6B4DU,
    0x6B4DU, 0x6B4DU, 0xE73CU, 0xFFFFU, 0xFFFFU, 0xFFFFU, 0xFFFFU, 0xFFFFU, 0xFFFFU, 0xFFFFU, 0xFFFFU, 0xFFFFU, 0xFFFFU, 0xB5B6U, 0xA514U, 0xA534U,
    0xA534U, 0xAD55U, 0x7BCFU, 0x6B4DU, 0x6B6DU, 0x630CU, 0x8C71U, 0xFFFFU, 0xFFFFU, 0xFFFFU, 0xFFFFU, 0xFFFFU, 0xFFFFU, 0xFFFFU, 0xFFFFU, 0xFFFFU,
    0xD69AU, 0x9CF3U, 0xA534U, 0xA534U, 0xA534U, 0xAD55U, 0x7BCFU, 0x6B4DU, 0x6B6DU, 0x6B6DU, 0x630CU, 0xC618U, 0xFFFFU, 0xFFFFU, 0xFFFFU, 0xFFFFU,
    0xFFFFU, 0xFFFFU, 0xFFFFU, 0xEF7DU, 0xA534U, 0xA534U, 0xA534U, 0xA534U, 0xA534U, 0xAD55U, 0x7BCFU, 0x6B4DU, 0x6B6DU, 0x6B6DU, 0x6B4DU, 0x738EU,
    0xF79EU, 0xFFFFU, 0xFFFFU, 0xFFFFU, 0xFFFFU, 0xFFFFU, 0xFFFFU, 0xBDF7U, 0x9CD3U, 0xA534U, 0xA534U, 0xA534U, 0xA534U, 0xAD55U, 0x7BEFU, 0x6B4DU,
    0x6B6DU, 0x6B6DU, 0x6B6DU, 0x5ACBU, 0x94B2U, 0xFFFFU, 0xFFFFU, 0xFFFFU, 0xFFFFU, 0xFFFFU, 0xFFFFU, 0xF79EU, 0xD69AU, 0xAD75U, 0xA514U, 0xA514U,
    0xA534U, 0xAD55U, 0x7BEFU, 0x6B4DU, 0x6B4DU, 0x630CU, 0x6B4DU, 0x94B2U, 0xD69AU, 0xFFFFU, 0xFFFFU, 0xFFFFU, 0xFFFFU, 0xFFFFU, 0xFFFFU, 0xFFFFU,
    0xFFFFU, 0xFFDFU, 0xDEFBU, 0xBDD7U, 0xA514U, 0xA534U, 0x7BCFU, 0x5AEBU, 0x738EU, 0xA514U, 0xE71CU, 0xFFFFU, 0xFFFFU, 0xFFFFU, 0xFFFFU, 0xFFFFU,
    0xFFFFU, 0xFFFFU, 0xFFFFU, 0xFFFFU, 0xFFFFU, 0xFFFFU, 0xFFFFU, 0xFFFFU, 0xEF5DU, 0xC638U, 0x8C71U, 0xAD75U, 0xEF7DU, 0xFFFFU, 0xFFFFU, 0xFFFFU,
    0xFFFFU, 0xFFFFU, 0xFFFFU, 0xFFFFU, 0xFFFFU, 0xFFFFU, 0xFFFFU, 0xFFFFU, 0xFFFFU, 0xFFFFU, 0xFFFFU, 0xFFFFU, 0xFFFFU, 0xFFFFU, 0xFFFFU, 0xFFFFU,
    0xFFFFU, 0xFFFFU, 0xFFFFU, 0xFFFFU, 0xFFFFU, 0xFFFFU, 0xFFFFU, 0xFFFFU, 0xFFFFU, 0xFFFFU, 0xFFFFU, 0xFFFFU, 0xFFFFU, 0xFFFFU, 0xFFFFU, 0xFFFFU,
    0xFFFFU, 0xFFFFU, 0xFFFFU, 0xFFFFU, 0xFFFFU, 0xFFFFU, 0xFFFFU, 0xFFFFU, 0xFFFFU, 0xFFFFU, 0xFFFFU, 0xFFFFU, 0xFFFFU, 0xFFFFU, 0xFFFFU, 0xFFFFU,
    0xFFFFU, 0xFFFFU, 0xFFFFU, 0xFFFFU, 0xFFFFU, 0xFFFFU, 0xFFFFU, 0xFFFFU, 0xFFFFU, 0xFFFFU, 0xFFFFU, 0xFFFFU, 0xFFFFU, 0xFFFFU, 0xFFFFU, 0xFFFFU,
  },
  {
    0xFFFFU, 0xFFFFU, 0xFFFFU, 0xFFFFU, 0xFFFFU, 0xFFFFU, 0xFFFFU, 0xFFFFU, 0xFFFFU, 0xFFFFU, 0xFFFFU, 0xFFFFU, 0xFFFFU, 0xFFFFU, 0xFFFFU, 0xFFFFU,
    0xFFFFU, 0xFFFFU, 0xFFFFU, 0xFFFFU, 0xFFFFU, 0xFFFFU, 0xFFFFU, 0xFFFFU, 0xFFFFU, 0xFFFFU, 0xFFFFU, 0xFFFFU, 0xFFFFU, 0xFFFFU, 0xFFFFU, 0xFFFFU,
    0xFFFFU, 0xFFFFU, 0xFFFFU, 0xFFFFU, 0xFFFFU, 0xFFFFU, 0xFFFFU, 0xFFFFU, 0xFFFFU, 0xFFFFU, 0xFFFFU, 0xFFFFU, 0xFFFFU, 0xFFFFU, 0xFFFFU, 0xFFFFU,
    0xFFFFU, 0xFFFFU, 0xFFFFU, 0xFFFFU, 0xFFFFU, 0xFFFFU, 0xFFFFU, 0xFFFFU, 0xFFFFU, 0xFFFFU, 0xFFFFU, 0xFFFFU, 0xFFFFU, 0xFFFFU, 0xFFFFU, 0xFFFFU,
    0xFFFFU, 0xFFFFU, 0xFFFFU, 0xFFFFU, 0xFFFFU, 0xAD75U, 0xA534U, 0xFFFFU, 0xFFFFU, 0xFFFFU, 0xFFFFU, 0xFFFFU, 0xFFFFU, 0xFFFFU, 0xFFFFU, 0xFFFFU,
    0xFFFFU, 0xFFFFU, 0xFFFFU, 0xFFFFU, 0xFFFFU, 0xFFFFU, 0xFFFFU, 0xFFFFU, 0xF79EU, 0x39C7U, 0x10A2U, 0xEF7DU, 0xFFFFU, 0xFFFFU, 0xFFFFU, 0xFFFFU,
    0xFFFFU, 0xFFFFU, 0xFFFFU, 0xFFFFU, 0xFFFFU, 0xFFFFU, 0xFFFFU, 0xFFFFU, 0xFFFFU, 0xFFFFU, 0xFFFFU, 0xFFFFU, 0x8410U, 0x2945U, 0x0000U, 0x630CU,
    0xFFFFU, 0xFFDFU, 0xFFFFU, 0xFFFFU, 0xFFFFU, 0xFFFFU, 0xFFFFU, 0xFFFFU, 0xFFFFU, 0xFFFFU, 0xFFFFU, 0xFFFFU, 0xFFFFU, 0xFFFFU, 0xFFFFU, 0xC638U,
    0x2945U, 0x31A6U, 0x0841U, 0x0000U, 0xC618U, 0xFFFFU, 0xFFFFU, 0xFFFFU, 0xFFFFU, 0xFFFFU, 0xFFFFU, 0xFFFFU, 0xFFFFU, 0xFFFFU, 0xFFFFU, 0xFFFFU,
    0xFFFFU, 0xFFFFU, 0xF7BEU, 0x4A69U, 0x2965U, 0x31A6U, 0x0841U, 0x0000U, 0x2945U, 0xFFDFU, 0xFFFFU, 0xFFFFU, 0xFFFFU, 0xFFFFU, 0xFFFFU, 0xFFFFU,
    0xFFFFU, 0xFFFFU, 0xFFFFU, 0xFFFFU, 0xFFFFU, 0xFFFFU, 0x8C71U, 0x2124U, 0x31A6U, 0x31A6U, 0x0841U, 0x0000U, 0x0000U, 0x7BEFU, 0xFFFFU, 0xFFDFU,
    0xFFFFU, 0xFFFFU, 0xFFFFU, 0xFFFFU, 0xFFFFU, 0xFFFFU, 0xFFFFU, 0xFFFFU, 0xFFFFU, 0xD69AU, 0x2965U, 0x31A6U, 0x3186U, 0x31A6U, 0x0841U, 0x0000U,
    0x0000U, 0x0020U, 0xD69AU, 0xFFFFU, 0xFFFFU, 0xFFFFU, 0xFFFFU, 0xFFFFU, 0xFFFFU, 0xFFFFU, 0xFFFFU, 0xFFFFU, 0xFFDFU, 0x52AAU, 0x2945U, 0x31A6U,
    0x3186U, 0x31A6U, 0x0861U, 0x0000U, 0x0000U, 0x0000U, 0x39C7U, 0xFFFFU, 0xFFFFU, 0xFFFFU, 0xFFFFU, 0xFFFFU, 0xFFFFU, 0xFFFFU, 0xFFFFU, 0xFFFFU,
    0x9CD3U, 0x2104U, 0x31A6U, 0x3186U, 0x3186U, 0x31A6U, 0x0861U, 0x0000U, 0x0000U, 0x0020U, 0x0000U, 0x94B2U, 0xFFFFU, 0xFFFFU, 0xFFFFU, 0xFFFFU,
    0xFFFFU, 0xFFFFU, 0xFFFFU, 0xDEDBU, 0x31A6U, 0x31A6U, 0x3186U, 0x3186U, 0x3186U, 0x31A6U, 0x0861U, 0x0000U, 0x0000U, 0x0000U, 0x0000U, 0x1082U,
    0xE73CU, 0xFFFFU, 0xFFFFU, 0xFFFFU, 0xFFFFU, 0xFFFFU, 0xFFFFU, 0x632CU, 0x18C3U, 0x3186U, 0x31A6U, 0x31A6U, 0x3186U, 0x31A6U, 0x0861U, 0x0000U,
    0x0000U, 0x0000U, 0x0000U, 0x0000U, 0x4A49U, 0xFFFFU, 0xFFFFU, 0xFFFFU, 0xFFFFU, 0xFFFFU, 0xFFFFU, 0xDEFBU, 0x94B2U, 0x4228U, 0x2124U, 0x2945U,
    0x31A6U, 0x39C7U, 0x1082U, 0x0020U, 0x0000U, 0x0000U, 0x0000U, 0x4A69U, 0xB596U, 0xFFFFU, 0xFFFFU, 0xFFFFU, 0xFFFFU, 0xFFFFU, 0xFFFFU, 0xFFFFU,
    0xFFFFU, 0xF7BEU, 0xB596U, 0x5AEBU, 0x2945U, 0x2945U, 0x0841U, 0x0000U, 0x0861U, 0x632CU, 0xCE59U, 0xFFFFU, 0xFFFFU, 0xFFFFU, 0xFFFFU, 0xFFFFU,
    0xFFFFU, 0xFFFFU, 0xFFFFU, 0xFFFFU, 0xFFFFU, 0xFFFFU, 0xFFFFU, 0xFFFFU, 0xCE59U, 0x7BCFU, 0x3186U, 0x7BEFU, 0xE71CU, 0xFFFFU, 0xFFFFU, 0xFFFFU,
    0xFFFFU, 0xFFFFU, 0xFFFFU, 0xFFFFU, 0xFFFFU, 0xFFFFU, 0xFFFFU, 0xFFFFU, 0xFFFFU, 0xFFFFU, 0xFFFFU, 0xFFFFU, 0xFFFFU, 0xFFFFU, 0xFFDFU, 0xFFFFU,
    0xFFFFU, 0xFFFFU, 0xFFFFU, 0xFFFFU, 0xFFFFU, 0xFFFFU, 0xFFFFU, 0xFFFFU, 0xFFFFU, 0xFFFFU, 0xFFFFU, 0xFFFFU, 0xFFFFU, 0xFFFFU, 0xFFFFU, 0xFFFFU,
    0xFFFFU, 0xFFFFU, 0xFFFFU, 0xFFDFU, 0xFFFFU, 0xFFFFU, 0xFFFFU, 0xFFFFU, 0xFFFFU, 0xFFFFU, 0xFFFFU, 0xFFFFU, 0xFFFFU, 0xFFFFU, 0xFFFFU, 0xFFFFU,
    0xFFFFU, 0xFFFFU, 0xFFFFU, 0xFFFFU, 0xFFFFU, 0xFFFFU, 0xFFFFU, 0xFFFFU, 0xFFFFU, 0xFFFFU, 0xFFFFU, 0xFFFFU, 0xFFFFU, 0xFFFFU, 0xFFFFU, 0xFFFFU,
  },
  {
    0xFFFFU, 0xFFFFU, 0xFFFFU, 0xFFFFU, 0xFFFFU, 0xFFFFU, 0xFFFFU, 0xFFFFU, 0xFFFFU, 0xFFFFU, 0xFFFFU, 0xFFFFU, 0xFFFFU, 0xFFBEU, 0xFF5DU, 0xFEBAU,
    0xFEDBU, 0xFFFFU, 0xFFFFU, 0xFFFFU, 0xFFFFU, 0xFFFFU, 0xFFFFU, 0xFFFFU, 0xFFFFU, 0xFFFFU, 0xFFDFU, 0xFF9EU, 0xFF3CU, 0xFEBAU, 0xFE38U, 0xFDB6U,
    0xFD55U, 0xFCF3U, 0xFCF3U, 0xFC10U, 0xE430U, 0xFFFFU, 0xFFFFU, 0xFFFFU, 0xFFFFU, 0xFFFFU, 0xFFFFU, 0xFE18U, 0xFDD7U, 0xFDD7U, 0xFD14U, 0xFCD3U,
    0xFCB2U, 0xFC92U, 0xFC92U, 0xFC92U, 0xFCB2U, 0xFCB2U, 0xFD34U, 0xDAAAU, 0xCB2CU, 0xFFFFU, 0xFFDFU, 0xFFFFU, 0xFFFFU, 0xFFDFU, 0xFFFFU, 0xFAAAU,
    0xF8A2U, 0xFBAEU, 0xFD14U, 0xFCF3U, 0xFCB2U, 0xFCD3U, 0xFCD3U, 0xFCD3U, 0xFCD3U, 0xFCD3U, 0xFD14U, 0xB882U, 0xD32CU, 0xFFFFU, 0xFFDFU, 0xFFFFU,
    0xFFFFU, 0xFFDFU, 0xFFFFU, 0xFB0CU, 0xF800U, 0xF800U, 0xF9E7U, 0xFC51U, 0xFD34U, 0xFCD3U, 0xFCB2U, 0xFCD3U, 0xFCB2U, 0xFD14U, 0xEBAEU, 0xA800U,
    0xD38EU, 0xFFFFU, 0xFFDFU, 0xFFFFU, 0xFFFFU, 0xFFDFU, 0xFFFFU, 0xFAEBU, 0xF800U, 0xF820U, 0xF800U, 0xF841U, 0xFA8AU, 0xFCB2U, 0xFD14U, 0xFCD3U,
    0xFCB2U, 0xFD14U, 0xC965U, 0xA800U, 0xD38EU, 0xFFFFU, 0xFFDFU, 0xFFFFU, 0xFFFFU, 0xFFDFU, 0xFFFFU, 0xFAEBU, 0xF800U, 0xF820U, 0xF800U, 0xF800U,
    0xF800U, 0xF8C3U, 0xFB4DU, 0xFCF3U, 0xFD34U, 0xEBCFU, 0xB000U, 0xA800U, 0xD36DU, 0xFFFFU, 0xFFDFU, 0xFFFFU, 0xFFFFU, 0xFFDFU, 0xFFFFU, 0xFAEBU,
    0xF800U, 0xF820U, 0xF800U, 0xF800U, 0xF800U, 0xF800U, 0xF800U, 0xF945U, 0xFC30U, 0xC9A6U, 0xB000U, 0xA800U, 0xD36DU, 0xFFFFU, 0xFFDFU, 0xFFFFU,
    0xFFFFU, 0xFFDFU, 0xFFFFU, 0xFB0CU, 0xF800U, 0xF820U, 0xF800U, 0xF800U, 0xF800U, 0xF800U, 0xF800U, 0xF800U, 0xF800U, 0xB820U, 0xB020U, 0xA800U,
    0xD36DU, 0xFFFFU, 0xFFDFU, 0xFFFFU, 0xFFFFU, 0xFFDFU, 0xFFFFU, 0xFB0CU, 0xF800U, 0xF820U, 0xF800U, 0xF800U, 0xF800U, 0xF800U, 0xF800U, 0xF800U,
    0xF800U, 0xB800U, 0xB020U, 0xA800U, 0xD36DU, 0xFFFFU, 0xFFDFU, 0xFFFFU, 0xFFFFU, 0xFFDFU, 0xFFFFU, 0xFB0CU, 0xF800U, 0xF820U, 0xF800U, 0xF800U,
    0xF800U, 0xF800U, 0xF800U, 0xF800U, 0xF800U, 0xB800U, 0xB020U, 0xA800U, 0xD36DU, 0xFFFFU, 0xFFDFU, 0xFFFFU, 0xFFFFU, 0xFFDFU, 0xFFFFU, 0xFB0CU,
    0xF800U, 0xF820U, 0xF800U, 0xF800U, 0xF800U, 0xF800U, 0xF800U, 0xF800U, 0xF800U, 0xB800U, 0xB020U, 0xA800U, 0xD38EU, 0xFFFFU, 0xFFDFU, 0xFFFFU,
    0xFFFFU, 0xFFDFU, 0xFFFFU, 0xFAEBU, 0xF800U, 0xF820U, 0xF800U, 0xF800U, 0xF800U, 0xF800U, 0xF800U, 0xF800U, 0xF800U, 0xB800U, 0xB000U, 0xB000U,
    0xEE38U, 0xFFFFU, 0xFFFFU, 0xFFFFU, 0xFFFFU, 0xFFDFU, 0xFFFFU, 0xFB8EU, 0xF800U, 0xF800U, 0xF820U, 0xF800U, 0xF800U, 0xF800U, 0xF800U, 0xF800U,
    0xF800U, 0xB820U, 0xA800U, 0xCA28U, 0xFFFFU, 0xFFFFU, 0xFFFFU, 0xFFFFU, 0xFFFFU, 0xFFFFU, 0xFFFFU, 0xFFDFU, 0xFCD3U, 0xF8E3U, 0xF800U, 0xF800U,
    0xF800U, 0xF800U, 0xF800U, 0xF800U, 0xF800U, 0xB820U, 0xA800U, 0xEDD7U, 0xFFFFU, 0xFFFFU, 0xFFFFU, 0xFFFFU, 0xFFFFU, 0xFFFFU, 0xFFFFU, 0xFFFFU,
    0xFFFFU, 0xFF5DU, 0xFBAEU, 0xF820U, 0xF800U, 0xF800U, 0xF800U, 0xF800U, 0xF820U, 0xB000U, 0xC186U, 0xFFFFU, 0xFFFFU, 0xFFFFU, 0xFFFFU, 0xFFFFU,
    0xFFFFU, 0xFFFFU, 0xFFFFU, 0xFFFFU, 0xFFDFU, 0xFFFFU, 0xFFFFU, 0xFE9AU, 0xFA8AU, 0xF800U, 0xF800U, 0xF800U, 0xF820U, 0xB000U, 0xE534U, 0xFFFFU,
    0xFFDFU, 0xFFFFU, 0xFFFFU, 0xFFFFU, 0xFFFFU, 0xFFFFU, 0xFFFFU, 0xFFFFU, 0xFFFFU, 0xFFFFU, 0xFFDFU, 0xFFFFU, 0xFFFFU, 0xFD96U, 0xF965U, 0xF800U,
    0xF800U, 0xC124U, 0xFFDFU, 0xFFFFU, 0xFFFFU, 0xFFFFU, 0xFFFFU, 0xFFFFU, 0xFFFFU, 0xFFFFU, 0xFFFFU, 0xFFFFU, 0xFFFFU, 0xFFFFU, 0xFFFFU, 0xFFFFU,
    0xFFFFU, 0xFFFFU, 0xFFDFU, 0xFC92U, 0xF0A2U, 0xECB2U, 0xFFFFU, 0xFFDFU, 0xFFFFU, 0xFFFFU, 0xFFFFU, 0xFFFFU, 0xFFFFU, 0xFFFFU, 0xFFFFU, 0xFFFFU,
    0xFFFFU, 0xFFFFU, 0xFFFFU, 0xFFFFU, 0xFFFFU, 0xFFFFU, 0xFFFFU, 0xFFFFU, 0xFF3CU, 0xFF9EU, 0xFFFFU, 0xFFFFU, 0xFFFFU, 0xFFFFU, 0xFFFFU, 0xFFFFU,
  },
  {
    0xFFFFU, 0xFFFFU, 0xFFFFU, 0xFFFFU, 0xFFFFU, 0xFFFFU, 0xFFFFU, 0xFFFFU, 0xFFFFU, 0xFFFFU, 0xFFFFU, 0xFFFFU, 0xFFFFU, 0xFFFFU, 0xFFDEU, 0xFFBCU,
    0xFFBDU, 0xFFFFU, 0xFFFFU, 0xFFFFU, 0xFFFFU, 0xFFFFU, 0xFFFFU, 0xFFFFU, 0xFFFFU, 0xFFFFU, 0xFFFFU, 0xFFFFU, 0xFFDDU, 0xFF9CU, 0xFF59U, 0xFF17U,
    0xFEF5U, 0xFEB2U, 0xFE91U, 0xFDEDU, 0xF674U, 0xFFFFU, 0xFFFFU, 0xFFFFU, 0xFFFFU, 0xFFFFU, 0xFFFFU, 0xFF7BU, 0xFF58U, 0xFF16U, 0xFEB3U, 0xFE91U,
    0xFE70U, 0xFE4FU, 0xFE4EU, 0xFE4EU, 0xFE4FU, 0xFE4FU, 0xFEB1U, 0xE4E7U, 0xE5F1U, 0xFFFFU, 0xFFFFU, 0xFFFFU, 0xFFFFU, 0xFFFFU, 0xFFFFU, 0xFDABU,
    0xFCC3U, 0xFE2EU, 0xFE70U, 0xFE4FU, 0xFE4FU, 0xFE70U, 0xFE70U, 0xFE70U, 0xFE70U, 0xFE70U, 0xFE70U, 0xD3A0U, 0xEDF1U, 0xFFFFU, 0xFFFFU, 0xFFFFU,
    0xFFFFU, 0xFFFFU, 0xFFFFU, 0xFDACU, 0xFC00U, 0xFC81U, 0xFD69U, 0xFE70U, 0xFE91U, 0xFE4FU, 0xFE4FU, 0xFE70U, 0xFE4FU, 0xFE91U, 0xED8BU, 0xC300U,
    0xEE32U, 0xFFFFU, 0xFFFFU, 0xFFFFU, 0xFFFFU, 0xFFFFU, 0xFFFFU, 0xFDABU, 0xFC20U, 0xFC60U, 0xFC20U, 0xFCA2U, 0xFDCBU, 0xFE70U, 0xFE70U, 0xFE4FU,
    0xFE4FU, 0xFE70U, 0xDC24U, 0xC300U, 0xEE32U, 0xFFFFU, 0xFFFFU, 0xFFFFU, 0xFFFFU, 0xFFFFU, 0xFFFFU, 0xFDACU, 0xFC20U, 0xFC60U, 0xFC60U, 0xFC40U,
    0xFC40U, 0xFCE4U, 0xFE0DU, 0xFE70U, 0xFE91U, 0xF5ACU, 0xCB60U, 0xCB20U, 0xEE12U, 0xFFFFU, 0xFFFFU, 0xFFFFU, 0xFFFFU, 0xFFFFU, 0xFFFFU, 0xFDACU,
    0xFC20U, 0xFC60U, 0xFC60U, 0xFC60U, 0xFC60U, 0xFC40U, 0xFC40U, 0xFD27U, 0xFE4FU, 0xDC44U, 0xCB60U, 0xCB20U, 0xEE12U, 0xFFFFU, 0xFFFFU, 0xFFFFU,
    0xFFFFU, 0xFFFFU, 0xFFFFU, 0xFDACU, 0xFC20U, 0xFC60U, 0xFC60U, 0xFC60U, 0xFC60U, 0xFC60U, 0xFC60U, 0xFC40U, 0xFC61U, 0xCB80U, 0xCB80U, 0xCB20U,
    0xEE12U, 0xFFFFU, 0xFFFFU, 0xFFFFU, 0xFFFFU, 0xFFFFU, 0xFFFFU, 0xFDACU, 0xFC20U, 0xFC60U, 0xFC60U, 0xFC60U, 0xFC60U, 0xFC60U, 0xFC60U, 0xFC60U,
    0xFC40U, 0xCB80U, 0xCB80U, 0xCB20U, 0xEE12U, 0xFFFFU, 0xFFFFU, 0xFFFFU, 0xFFFFU, 0xFFFFU, 0xFFFFU, 0xFDACU, 0xFC20U, 0xFC60U, 0xFC60U, 0xFC60U,
    0xFC60U, 0xFC60U, 0xFC60U, 0xFC60U, 0xFC40U, 0xCB80U, 0xCB80U, 0xCB20U, 0xEE12U, 0xFFFFU, 0xFFFFU, 0xFFFFU, 0xFFFFU, 0xFFFFU, 0xFFFFU, 0xFDACU,
    0xFC20U, 0xFC60U, 0xFC60U, 0xFC60U, 0xFC60U, 0xFC60U, 0xFC60U, 0xFC60U, 0xFC40U, 0xCB80U, 0xCB80U, 0xCB20U, 0xEE12U, 0xFFFFU, 0xFFFFU, 0xFFFFU,
    0xFFFFU, 0xFFFFU, 0xFFFFU, 0xFDABU, 0xFC20U, 0xFC60U, 0xFC60U, 0xFC60U, 0xFC60U, 0xFC60U, 0xFC60U, 0xFC60U, 0xFC40U, 0xCB80U, 0xCB60U, 0xCB81U,
    0xFF5BU, 0xFFFFU, 0xFFFFU, 0xFFFFU, 0xFFFFU, 0xFFFFU, 0xFFFFU, 0xFDEDU, 0xFBE0U, 0xFC60U, 0xFC60U, 0xFC60U, 0xFC60U, 0xFC60U, 0xFC60U, 0xFC60U,
    0xFC40U, 0xCBA0U, 0xCB20U, 0xDD2BU, 0xFFFFU, 0xFFFFU, 0xFFFFU, 0xFFFFU, 0xFFFFU, 0xFFFFU, 0xFFFFU, 0xFFDEU, 0xFE51U, 0xFC82U, 0xFC20U, 0xFC60U,
    0xFC60U, 0xFC60U, 0xFC60U, 0xFC60U, 0xFC40U, 0xCB80U, 0xCB60U, 0xF73AU, 0xFFFFU, 0xFFFFU, 0xFFFFU, 0xFFFFU, 0xFFFFU, 0xFFFFU, 0xFFFFU, 0xFFFFU,
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
    0xFE80U, 0xD5A4U, 0xFFFFU, 0xFFFFU, 0xFFFFU, 0xFFFFU, 0xFFFFU, 0xFFFFU, 0xFFFFU, 0xFFFFU, 0xFFFFU, 0xFFFFU, 0xFFFFU, 0xFFFFU, 0xFFFFU, 0xFFFFU,
    0xFFFFU, 0xFFFFU, 0xFFFFU, 0xFF72U, 0xFE82U, 0xEEF2U, 0xFFFFU, 0xFFFFU, 0xFFFFU, 0xFFFFU, 0xFFFFU, 0xFFFFU, 0xFFFFU, 0xFFFFU, 0xFFFFU, 0xFFFFU,
    0xFFFFU, 0xFFFFU, 0xFFFFU, 0xFFFFU, 0xFFFFU, 0xFFFFU, 0xFFFFU, 0xFFFFU, 0xFFDCU, 0xFFFEU, 0xFFFFU, 0xFFFFU, 0xFFFFU, 0xFFFFU, 0xFFFFU, 0xFFFFU,
  },
  {
    0xFFFFU, 0xFFFFU, 0xFFFFU, 0xFFFFU, 0xFFFFU, 0xFFFFU, 0xFFFFU, 0xFFFFU, 0xFFFFU, 0xFFFFU, 0xFFFFU, 0xFFFFU, 0xFFFFU, 0xFFFFU, 0xF7FEU, 0xEFFDU,
    0xF7FEU, 0xFFFFU, 0xFFFFU, 0xFFFFU, 0xFFFFU, 0xFFFFU, 0xFFFFU, 0xFFFFU, 0xFFFFU, 0xFFFFU, 0xFFFFU, 0xFFFFU, 0xF7FEU, 0xE7FCU, 0xD7FAU, 0xC7F8U,
    0xBFF7U, 0xAFF5U, 0xA7F4U, 0x87B0U, 0xA714U, 0xFFFFU, 0xFFFFU, 0xFFFFU, 0xFFFFU, 0xFFFFU, 0xFFFFU, 0xDFDBU, 0xD7FAU, 0xC7F8U, 0xAFF5U, 0xA7F4U,
    0x9FF3U, 0x97F2U, 0x97F2U, 0x97F2U, 0x97F2U, 0x97F2U, 0xA7F4U, 0x4E69U, 0x8650U, 0xFFFFU, 0xFFFFU, 0xFFFFU, 0xFFFFU, 0xFFFFU, 0xFFFFU, 0x5EEBU,
    0x2EC5U, 0x8FD1U, 0x9FF3U, 0x97F2U, 0x97F2U, 0x9FF3U, 0x9FF3U, 0x9FF3U, 0x9FF3U, 0x9FF3U, 0x9FF3U, 0x0D01U, 0x8E71U, 0xFFFFU, 0xFFFFU, 0xFFFFU,
    0xFFFFU, 0xFFFFU, 0xFFFFU, 0x66ECU, 0x0620U, 0x0E61U, 0x572AU, 0x9FF3U, 0xA7F4U, 0x97F2U, 0x97F2U, 0x9FF3U, 0x97F2U, 0xA7F4U, 0x6F0DU, 0x0460U,
    0x96B2U, 0xFFFFU, 0xFFFFU, 0xFFFFU, 0xFFFFU, 0xFFFFU, 0xFFFFU, 0x5EEBU, 0x0640U, 0x0660U, 0x0640U, 0x1E83U, 0x6F6DU, 0xA7F4U, 0x9FF3U, 0x97F2U,
    0x97F2U, 0x9FF3U, 0x2584U, 0x0460U, 0x96B2U, 0xFFFFU, 0xFFFFU, 0xFFFFU, 0xFFFFU, 0xFFFFU, 0xFFFFU, 0x5EEBU, 0x0640U, 0x0660U, 0x0660U, 0x0640U,
    0x0640U, 0x2EC5U, 0x87B0U, 0xA7F4U, 0xA7F4U, 0x772EU, 0x04A0U, 0x0480U, 0x9692U, 0xFFFFU, 0xFFFFU, 0xFFFFU, 0xFFFFU, 0xFFFFU, 0xFFFFU, 0x5EEBU,
    0x0640U, 0x0660U, 0x0660U, 0x0660U, 0x0660U, 0x0640U, 0x0660U, 0x4708U, 0x97D2U, 0x2DA5U, 0x04A0U, 0x0480U, 0x9692U, 0xFFFFU, 0xFFFFU, 0xFFFFU,
    0xFFFFU, 0xFFFFU, 0xFFFFU, 0x66ECU, 0x0640U, 0x0660U, 0x0660U, 0x0660U, 0x0660U, 0x0660U, 0x0660U, 0x0640U, 0x0E41U, 0x04E0U, 0x04C0U, 0x0480U,
    0x9692U, 0xFFFFU, 0xFFFFU, 0xFFFFU, 0xFFFFU, 0xFFFFU, 0xFFFFU, 0x66ECU, 0x0640U, 0x0660U, 0x0660U, 0x0660U, 0x0660U, 0x0660U, 0x0660U, 0x0660U,
    0x0620U, 0x04C0U, 0x04C0U, 0x0480U, 0x9692U, 0xFFFFU, 0xFFFFU, 0xFFFFU, 0xFFFFU, 0xFFFFU, 0xFFFFU, 0x66ECU, 0x0640U, 0x0660U, 0x0660U, 0x0660U,
    0x0660U, 0x0660U, 0x0660U, 0x0660U, 0x0620U, 0x04C0U, 0x04C0U, 0x0480U, 0x9692U, 0xFFFFU, 0xFFFFU, 0xFFFFU, 0xFFFFU, 0xFFFFU, 0xFFFFU, 0x66ECU,
    0x0640U, 0x0660U, 0x0660U, 0x0660U, 0x0660U, 0x0660U, 0x0660U, 0x0660U, 0x0620U, 0x04C0U, 0x04C0U, 0x0480U, 0x9692U, 0xFFFFU, 0xFFFFU, 0xFFFFU,
    0xFFFFU, 0xFFFFU, 0xFFFFU, 0x5EEBU, 0x0640U, 0x0660U, 0x0660U, 0x0660U, 0x0660U, 0x0660U, 0x0660U, 0x0660U, 0x0620U, 0x04C0U, 0x04C0U, 0x0CC1U,
    0xDF9BU, 0xFFFFU, 0xFFFFU, 0xFFFFU, 0xFFFFU, 0xFFFFU, 0xFFFFU, 0x6F0DU, 0x0620U, 0x0660U, 0x0660U, 0x0660U, 0x0660U, 0x0660U, 0x0660U, 0x0660U,
    0x0620U, 0x04E0U, 0x0480U, 0x5DEBU, 0xFFFFU, 0xFFFFU, 0xFFFFU, 0xFFFFU, 0xFFFFU, 0xFFFFU, 0xFFFFU, 0xF7FEU, 0x8F31U, 0x1662U, 0x0640U, 0x0660U,
    0x0660U, 0x0660U, 0x0660U, 0x0660U, 0x0620U, 0x04C0U, 0x04A0U, 0xD77AU, 0xFFFFU, 0xFFFFU, 0xFFFFU, 0xFFFFU, 0xFFFFU, 0xFFFFU, 0xFFFFU, 0xFFFFU,
    0xFFFFU, 0xE7DCU, 0x66ECU, 0x0640U, 0x0640U, 0x0660U, 0x0660U, 0x0660U, 0x0640U, 0x04A0U, 0x4DA9U, 0xFFFFU, 0xFFFFU, 0xFFFFU, 0xFFFFU, 0xFFFFU,
    0xFFFFU, 0xFFFFU, 0xFFFFU, 0xFFFFU, 0xFFFFU, 0xFFFFU, 0xFFFFU, 0xC798U, 0x46C8U, 0x0640U, 0x0640U, 0x0660U, 0x0640U, 0x04A0U, 0xC738U, 0xFFFFU,
    0xFFFFU, 0xFFFFU, 0xFFFFU, 0xFFFFU, 0xFFFFU, 0xFFFFU, 0xFFFFU, 0xFFFFU, 0xFFFFU, 0xFFFFU, 0xFFFFU, 0xFFFFU, 0xFFFFU, 0xA774U, 0x2684U, 0x0640U,
    0x0600U, 0x3D87U, 0xFFFFU, 0xFFFFU, 0xFFFFU, 0xFFFFU, 0xFFFFU, 0xFFFFU, 0xFFFFU, 0xFFFFU, 0xFFFFU, 0xFFFFU, 0xFFFFU, 0xFFFFU, 0xFFFFU, 0xFFFFU,
    0xFFFFU, 0xFFFFU, 0xF7FEU, 0x8730U, 0x1622U, 0xB716U, 0xFFFFU, 0xFFFFU, 0xFFFFU, 0xFFFFU, 0xFFFFU, 0xFFFFU, 0xFFFFU, 0xFFFFU, 0xFFFFU, 0xFFFFU,
    0xFFFFU, 0xFFFFU, 0xFFFFU, 0xFFFFU, 0xFFFFU, 0xFFFFU, 0xFFFFU, 0xFFFFU, 0xDFDBU, 0xFFFFU, 0xFFFFU, 0xFFFFU, 0xFFFFU, 0xFFFFU, 0xFFFFU, 0xFFFFU,
  },
  {
    0xFFFFU, 0xFFFFU, 0xFFFFU, 0xFFFFU, 0xFFFFU, 0xFFFFU, 0xFFFFU, 0xFFFFU, 0xFFFFU, 0xFFFFU, 0xFFFFU, 0xFFFFU, 0xFFFFU, 0xFFFFU, 0xF7FFU, 0xE7FFU,
    0xEFFFU, 0xFFFFU, 0xFFFFU, 0xFFFFU, 0xFFFFU, 0xFFFFU, 0xFFFFU, 0xFFFFU, 0xFFFFU, 0xFFFFU, 0xFFFFU, 0xFFFFU, 0xEFFFU, 0xE7FFU, 0xD7FFU, 0xC7FFU,
    0xB7FFU, 0xA7FFU, 0xA7FFU, 0x87BEU, 0x96DBU, 0xFFFFU, 0xFFFFU, 0xFFFFU, 0xFFFFU, 0xFFFFU, 0xFFFFU, 0xD7DFU, 0xCFFFU, 0xC7FFU, 0xAFFFU, 0xA7FFU,
    0x9FFFU, 0x97FFU, 0x97FFU, 0x97FFU, 0x97FFU, 0x97FFU, 0xA7FFU, 0x56BAU, 0x7618U, 0xFFFFU, 0xFFFFU, 0xFFFFU, 0xFFFFU, 0xFFFFU, 0xFFFFU, 0x5EFBU,
    0x26DBU, 0x87BEU, 0xA7FFU, 0x9FFFU, 0x97FFU, 0x9FFFU, 0x9FFFU, 0x9FFFU, 0x9FFFU, 0x9FFFU, 0xA7FFU, 0x1534U, 0x7638U, 0xFFFFU, 0xFFFFU, 0xFFFFU,
    0xFFFFU, 0xFFFFU, 0xFFFFU, 0x66FBU, 0x0638U, 0x0E79U, 0x4F3CU, 0x97FFU, 0xA7FFU, 0x9FFFU, 0x97FFU, 0x9FFFU, 0x97FFU, 0xA7FFU, 0x773CU, 0x0471U,
    0x7E59U, 0xFFFFU, 0xFFFFU, 0xFFFFU, 0xFFFFU, 0xFFFFU, 0xFFFFU, 0x66FBU, 0x0659U, 0x0679U, 0x0659U, 0x169AU, 0x675DU, 0x9FFFU, 0xA7FFU, 0x97FFU,
    0x97FFU, 0xA7FFU, 0x2DB6U, 0x0471U, 0x7E59U, 0xFFFFU, 0xFFFFU, 0xFFFFU, 0xFFFFU, 0xFFFFU, 0xFFFFU, 0x66FBU, 0x0659U, 0x0679U, 0x0679U, 0x0659U,
    0x0659U, 0x26BAU, 0x779EU, 0xA7FFU, 0xA7FFU, 0x7F5DU, 0x04D3U, 0x0492U, 0x7E59U, 0xFFFFU, 0xFFFFU, 0xFFFFU, 0xFFFFU, 0xFFFFU, 0xFFFFU, 0x66FBU,
    0x0659U, 0x0679U, 0x0679U, 0x0679U, 0x0679U, 0x0659U, 0x0659U, 0x3EFBU, 0x97DFU, 0x35F7U, 0x04B2U, 0x0492U, 0x7E59U, 0xFFFFU, 0xFFFFU, 0xFFFFU,
    0xFFFFU, 0xFFFFU, 0xFFFFU, 0x66FBU, 0x0659U, 0x0679U, 0x0679U, 0x0679U, 0x0679U, 0x0679U, 0x0679U, 0x0659U, 0x0E79U, 0x04F3U, 0x04D3U, 0x0492U,
    0x7E59U, 0xFFFFU, 0xFFFFU, 0xFFFFU, 0xFFFFU, 0xFFFFU, 0xFFFFU, 0x66FBU, 0x0659U, 0x0679U, 0x0679U, 0x0679U, 0x0679U, 0x0679U, 0x0679U, 0x0679U,
    0x0659U, 0x04F3U, 0x04D3U, 0x0492U, 0x7E59U, 0xFFFFU, 0xFFFFU, 0xFFFFU, 0xFFFFU, 0xFFFFU, 0xFFFFU, 0x66FBU, 0x0659U, 0x0679U, 0x0679U, 0x0679U,
    0x0679U, 0x0679U, 0x0679U, 0x0679U, 0x0659U, 0x04F3U, 0x04D3U, 0x0492U, 0x7E59U, 0xFFFFU, 0xFFFFU, 0xFFFFU, 0xFFFFU, 0xFFFFU, 0xFFFFU, 0x66FBU,
    0x0659U, 0x0679U, 0x0679U, 0x0679U, 0x0679U, 0x0679U, 0x0679U, 0x0679U, 0x0659U, 0x04F3U, 0x04D3U, 0x0492U, 0x7E59U, 0xFFFFU, 0xFFFFU, 0xFFFFU,
    0xFFFFU, 0xFFFFU, 0xFFFFU, 0x5EFBU, 0x0659U, 0x0679U, 0x0679U, 0x0679U, 0x0679U, 0x0679U, 0x0679U, 0x0679U, 0x0659U, 0x04F3U, 0x04D3U, 0x04B2U,
    0xCF5DU, 0xFFFFU, 0xFFFFU, 0xFFFFU, 0xFFFFU, 0xFFFFU, 0xFFFFU, 0x6F1CU, 0x0638U, 0x0679U, 0x0679U, 0x0679U, 0x0679U, 0x0679U, 0x0679U, 0x0679U,
    0x0659U, 0x04F3U, 0x0492U, 0x4DB6U, 0xFFFFU, 0xFFFFU, 0xFFFFU, 0xFFFFU, 0xFFFFU, 0xFFFFU, 0xFFFFU, 0xF7FFU, 0x8F5DU, 0x1679U, 0x0659U, 0x0679U,
    0x0679U, 0x0679U, 0x0679U, 0x0679U, 0x0659U, 0x04F3U, 0x0492U, 0xBF3CU, 0xFFFFU, 0xFFFFU, 0xFFFFU, 0xFFFFU, 0xFFFFU, 0xFFFFU, 0xFFFFU, 0xFFFFU,
    0xFFFFU, 0xE7DFU, 0x671CU, 0x0659U, 0x0659U, 0x0679U, 0x0679U, 0x0679U, 0x0659U, 0x04D3U, 0x3575U, 0xFFFFU, 0xFFFFU, 0xFFFFU, 0xFFFFU, 0xFFFFU,
    0xFFFFU, 0xFFFFU, 0xFFFFU, 0xFFFFU, 0xFFFFU, 0xFFFFU, 0xFFFFU, 0xC7BEU, 0x46DBU, 0x0659U, 0x0659U, 0x0679U, 0x0659U, 0x04B2U, 0xAEFBU, 0xFFFFU,
    0xFFFFU, 0xFFFFU, 0xFFFFU, 0xFFFFU, 0xFFFFU, 0xFFFFU, 0xFFFFU, 0xFFFFU, 0xFFFFU, 0xFFFFU, 0xFFFFU, 0xFFFFU, 0xFFFFU, 0xA77DU, 0x269AU, 0x0659U,
    0x0638U, 0x2D75U, 0xFFFFU, 0xFFFFU, 0xFFFFU, 0xFFFFU, 0xFFFFU, 0xFFFFU, 0xFFFFU, 0xFFFFU, 0xFFFFU, 0xFFFFU, 0xFFFFU, 0xFFFFU, 0xFFFFU, 0xFFFFU,
    0xFFFFU, 0xFFFFU, 0xF7FFU, 0x875DU, 0x1638U, 0x9EDBU, 0xFFFFU, 0xFFFFU, 0xFFFFU, 0xFFFFU, 0xFFFFU, 0xFFFFU, 0xFFFFU, 0xFFFFU, 0xFFFFU, 0xFFFFU,
    0xFFFFU, 0xFFFFU, 0xFFFFU, 0xFFFFU, 0xFFFFU, 0xFFFFU, 0xFFFFU, 0xFFFFU, 0xDFDFU, 0xF7FFU, 0xFFFFU, 0xFFFFU, 0xFFFFU, 0xFFFFU, 0xFFFFU, 0xFFFFU,
  },
  {
    0xFFFFU, 0xFFFFU, 0xFFFFU, 0xFFFFU, 0xFFFFU, 0xFFFFU, 0xFFFFU, 0xFFFFU, 0xFFFFU, 0xFFFFU, 0xFFFFU, 0xFFFFU, 0xFFFFU, 0xFFFFU, 0xF7BFU, 0xE77FU,
    0xEF7FU, 0xFFFFU, 0xFFFFU, 0xFFFFU, 0xFFFFU, 0xFFFFU, 0xFFFFU, 0xFFFFU, 0xFFFFU, 0xFFFFU, 0xFFFFU, 0xFFDFU, 0xEFBFU, 0xE75FU, 0xD71FU, 0xC6BFU,
    0xB67FU, 0xA63FU, 0xA61FU, 0x857FU, 0x959DU, 0xFFFFU, 0xFFFFU, 0xFFFFU, 0xFFFFU, 0xFFFFU, 0xFFFFU, 0xD73FU, 0xCEDFU, 0xC6BFU, 0xAE3FU, 0xA5FFU,
    0x9DDFU, 0x95BFU, 0x95BFU, 0x95BFU, 0x95BFU, 0x95BFU, 0xA63FU, 0x543DU, 0x74BCU, 0xFFFFU, 0xFFFFU, 0xFFFFU, 0xFFFFU, 0xFFFFU, 0xFFFFU, 0x651FU,
    0x1B7FU, 0x7D7FU, 0xA5FFU, 0x9DDFU, 0x95DFU, 0x9DFFU, 0x9DFFU, 0x9DFFU, 0x9DFFU, 0x9DDFU, 0xA61FU, 0x129AU, 0x74DCU, 0xFFFFU, 0xFFFFU, 0xFFFFU,
    0xFFFFU, 0xFFFFU, 0xFFFFU, 0x6D3FU, 0x02BFU, 0x035FU, 0x447FU, 0x95BFU, 0xA61FU, 0x9DDFU, 0x95DFU, 0x9DDFU, 0x95DFU, 0xA61FU, 0x74FEU, 0x0198U,
    0x7CFCU, 0xFFFFU, 0xFFFFU, 0xFFFFU, 0xFFFFU, 0xFFFFU, 0xFFFFU, 0x6D3FU, 0x02FFU, 0x035FU, 0x031FU, 0x137FU, 0x5CDFU, 0x9DFFU, 0xA61FU, 0x95DFU,
    0x95DFU, 0xA61FU, 0x2B5BU, 0x0198U, 0x7CFCU, 0xFFFFU, 0xFFFFU, 0xFFFFU, 0xFFFFU, 0xFFFFU, 0xFFFFU, 0x6D3FU, 0x02DFU, 0x035FU, 0x035FU, 0x033FU,
    0x031FU, 0x23BFU, 0x753FU, 0xA5FFU, 0xA61FU, 0x7D1EU, 0x0239U, 0x01B9U, 0x7CFCU, 0xFFFFU, 0xFFFFU, 0xFFFFU, 0xFFFFU, 0xFFFFU, 0xFFFFU, 0x6D3FU,
    0x02DFU, 0x035FU, 0x033FU, 0x033FU, 0x033FU, 0x031FU, 0x031FU, 0x341FU, 0x8DBFU, 0x3B7BU, 0x01F9U, 0x01D9U, 0x7CFCU, 0xFFFFU, 0xFFFFU, 0xFFFFU,
    0xFFFFU, 0xFFFFU, 0xFFFFU, 0x6D3FU, 0x02DFU, 0x035FU, 0x033FU, 0x033FU, 0x033FU, 0x033FU, 0x033FU, 0x031FU, 0x035FU, 0x025AU, 0x0239U, 0x01B9U,
    0x7CFCU, 0xFFFFU, 0xFFFFU, 0xFFFFU, 0xFFFFU, 0xFFFFU, 0xFFFFU, 0x6D3FU, 0x02DFU, 0x035FU, 0x033FU, 0x033FU, 0x033FU, 0x033FU, 0x033FU, 0x033FU,
    0x033FU, 0x025AU, 0x0239U, 0x01B9U, 0x7CFCU, 0xFFFFU, 0xFFFFU, 0xFFFFU, 0xFFFFU, 0xFFFFU, 0xFFFFU, 0x6D3FU, 0x02DFU, 0x035FU, 0x033FU, 0x033FU,
    0x033FU, 0x033FU, 0x033FU, 0x033FU, 0x033FU, 0x025AU, 0x0239U, 0x01B9U, 0x7CFCU, 0xFFFFU, 0xFFFFU, 0xFFFFU, 0xFFFFU, 0xFFFFU, 0xFFFFU, 0x6D3FU,
    0x02DFU, 0x035FU, 0x033FU, 0x033FU, 0x033FU, 0x033FU, 0x033FU, 0x033FU, 0x033FU, 0x025AU, 0x0239U, 0x01B9U, 0x7CFCU, 0xFFFFU, 0xFFFFU, 0xFFFFU,
    0xFFFFU, 0xFFFFU, 0xFFFFU, 0x6D3FU, 0x02FFU, 0x035FU, 0x033FU, 0x033FU, 0x033FU, 0x033FU, 0x033FU, 0x033FU, 0x033FU, 0x025AU, 0x0239U, 0x0219U,
    0xCEDEU, 0xFFFFU, 0xFFFFU, 0xFFFFU, 0xFFFFU, 0xFFFFU, 0xFFFFU, 0x7D9FU, 0x02BFU, 0x031FU, 0x035FU, 0x033FU, 0x033FU, 0x033FU, 0x033FU, 0x033FU,
    0x033FU, 0x025AU, 0x01D9U, 0x4BDBU, 0xFFFFU, 0xFFFFU, 0xFFFFU, 0xFFFFU, 0xFFFFU, 0xFFFFU, 0xFFFFU, 0xFFDFU, 0x9E1FU, 0x1BBFU, 0x02DFU, 0x033FU,
    0x035FU, 0x033FU, 0x033FU, 0x033FU, 0x033FU, 0x025AU, 0x01D9U, 0xC69EU, 0xFFFFU, 0xFFFFU, 0xFFFFU, 0xFFFFU, 0xFFFFU, 0xFFFFU, 0xFFFFU, 0xFFFFU,
    0xFFFFU, 0xEFBFU, 0x755FU, 0x0B3FU, 0x02FFU, 0x035FU, 0x035FU, 0x033FU, 0x033FU, 0x01F9U, 0x3B7AU, 0xFFFFU, 0xFFFFU, 0xFFFFU, 0xFFFFU, 0xFFFFU,
    0xFFFFU, 0xFFFFU, 0xFFFFU, 0xFFFFU, 0xFFFFU, 0xFFFFU, 0xFFFFU, 0xD73FU, 0x54BFU, 0x02FFU, 0x031FU, 0x035FU, 0x035FU, 0x01F9U, 0xAE1DU, 0xFFFFU,
    0xFFFFU, 0xFFFFU, 0xFFFFU, 0xFFFFU, 0xFFFFU, 0xFFFFU, 0xFFFFU, 0xFFFFU, 0xFFFFU, 0xFFFFU, 0xFFFFU, 0xFFFFU, 0xFFFFU, 0xB69FU, 0x33FFU, 0x02FFU,
    0x02DFU, 0x2B3BU, 0xFFFFU, 0xFFFFU, 0xFFFFU, 0xFFFFU, 0xFFFFU, 0xFFFFU, 0xFFFFU, 0xFFFFU, 0xFFFFU, 0xFFFFU, 0xFFFFU, 0xFFFFU, 0xFFFFU, 0xFFFFU,
    0xFFFFU, 0xFFFFU, 0xFFFFU, 0x95FFU, 0x1B3FU, 0x9DDEU, 0xFFFFU, 0xFFFFU, 0xFFFFU, 0xFFFFU, 0xFFFFU, 0xFFFFU, 0xFFFFU, 0xFFFFU, 0xFFFFU, 0xFFFFU,
    0xFFFFU, 0xFFFFU, 0xFFFFU, 0xFFFFU, 0xFFFFU, 0xFFFFU, 0xFFFFU, 0xFFFFU, 0xE79FU, 0xF7DFU, 0xFFFFU, 0xFFFFU, 0xFFFFU, 0xFFFFU, 0xFFFFU, 0xFFFFU,
  },
  {
    0xFFFFU, 0xFFFFU, 0xFFFFU, 0xFFFFU, 0xFFFFU, 0xFFFFU, 0xFFFFU, 0xFFFFU, 0xFFFFU, 0xFFFFU, 0xFFFFU, 0xFFFFU, 0xFFFFU, 0xFFFFU, 0xFFBFU, 0xF75FU,
    0xF77FU, 0xFFFFU, 0xFFFFU, 0xFFFFU, 0xFFFFU, 0xFFFFU, 0xFFFFU, 0xFFFFU, 0xFFFFU, 0xFFFFU, 0xFFFFU, 0xFFDFU, 0xFF9FU, 0xF75FU, 0xEEFFU, 0xEE9FU,
    0xE63FU, 0xDDFFU, 0xDDDFU, 0xCD1FU, 0xCCBDU, 0xFFFFU, 0xFFFFU, 0xFFFFU, 0xFFFFU, 0xFFFFU, 0xFFFFU, 0xEEBFU, 0xEEDFU, 0xEE9FU, 0xDDFFU, 0xDDBFU,
    0xDD9FU, 0xD57FU, 0xD57FU, 0xD57FU, 0xD57FU, 0xD57FU, 0xE61FU, 0xAB3DU, 0xB37CU, 0xFFFFU, 0xFFDFU, 0xFFFFU, 0xFFFFU, 0xFFDFU, 0xFFFFU, 0xBADFU,
    0xA17FU, 0xD4DFU, 0xDDFFU, 0xDDBFU, 0xDD9FU, 0xDDBFU, 0xDDBFU, 0xDDBFU, 0xDDBFU, 0xDD9FU, 0xDDFFU, 0x80BAU, 0xB39CU, 0xFFFFU, 0xFFDFU, 0xFFFFU,
    0xFFFFU, 0xFFDFU, 0xFFFFU, 0xC31FU, 0x881FU, 0x985FU, 0xBADFU, 0xD57FU, 0xDDFFU, 0xDD9FU, 0xDD9FU, 0xDD9FU, 0xDD9FU, 0xDDFFU, 0xC45EU, 0x6818U,
    0xBBDCU, 0xFFFFU, 0xFFDFU, 0xFFFFU, 0xFFFFU, 0xFFDFU, 0xFFFFU, 0xBAFFU, 0x901FU, 0x981FU, 0x901FU, 0x98BFU, 0xC39FU, 0xDDDFU, 0xDDFFU, 0xDD9FU,
    0xD59FU, 0xDDFFU, 0x91BBU, 0x6018U, 0xBBDCU, 0xFFFFU, 0xFFDFU, 0xFFFFU, 0xFFFFU, 0xFFDFU, 0xFFFFU, 0xBB1FU, 0x901FU, 0x983FU, 0x981FU, 0x901FU,
    0x901FU, 0xA17FU, 0xCC5FU, 0xDDFFU, 0xE61FU, 0xC47EU, 0x7019U, 0x6819U, 0xB3DCU, 0xFFFFU, 0xFFDFU, 0xFFFFU, 0xFFFFU, 0xFFDFU, 0xFFFFU, 0xBB1FU,
    0x901FU, 0x983FU, 0x981FU, 0x981FU, 0x981FU, 0x901FU, 0x901FU, 0xAA1FU, 0xD55FU, 0x9A1BU, 0x7019U, 0x6819U, 0xB3DCU, 0xFFFFU, 0xFFDFU, 0xFFFFU,
    0xFFFFU, 0xFFDFU, 0xFFFFU, 0xBB1FU, 0x901FU, 0x983FU, 0x981FU, 0x981FU, 0x981FU, 0x981FU, 0x981FU, 0x901FU, 0x985FU, 0x783AU, 0x7819U, 0x6819U,
    0xB3DCU, 0xFFFFU, 0xFFDFU, 0xFFFFU, 0xFFFFU, 0xFFDFU, 0xFFFFU, 0xBB1FU, 0x901FU, 0x983FU, 0x981FU, 0x981FU, 0x981FU, 0x981FU, 0x981FU, 0x981FU,
    0x901FU, 0x781AU, 0x7839U, 0x6819U, 0xB3DCU, 0xFFFFU, 0xFFDFU, 0xFFFFU, 0xFFFFU, 0xFFDFU, 0xFFFFU, 0xBB1FU, 0x901FU, 0x983FU, 0x981FU, 0x981FU,
    0x981FU, 0x981FU, 0x981FU, 0x981FU, 0x981FU, 0x781AU, 0x7839U, 0x6819U, 0xB3DCU, 0xFFFFU, 0xFFDFU, 0xFFFFU, 0xFFFFU, 0xFFDFU, 0xFFFFU, 0xBB1FU,
    0x901FU, 0x983FU, 0x981FU, 0x981FU, 0x981FU, 0x981FU, 0x981FU, 0x981FU, 0x981FU, 0x781AU, 0x7839U, 0x6819U, 0xB3DCU, 0xFFFFU, 0xFFDFU, 0xFFFFU,
    0xFFFFU, 0xFFDFU, 0xFFFFU, 0xBAFFU, 0x901FU, 0x983FU, 0x981FU, 0x981FU, 0x981FU, 0x981FU, 0x981FU, 0x981FU, 0x981FU, 0x781AU, 0x7019U, 0x7019U,
    0xE65EU, 0xFFFFU, 0xFFFFU, 0xFFFFU, 0xFFFFU, 0xFFDFU, 0xFFFFU, 0xC37FU, 0x881FU, 0x981FU, 0x983FU, 0x981FU, 0x981FU, 0x981FU, 0x981FU, 0x981FU,
    0x981FU, 0x783AU, 0x6819U, 0x9A3BU, 0xFFFFU, 0xFFFFU, 0xFFFFU, 0xFFFFU, 0xFFFFU, 0xFFFFU, 0xFFFFU, 0xFF9FU, 0xD47FU, 0x98BFU, 0x901FU, 0x981FU,
    0x981FU, 0x981FU, 0x981FU, 0x981FU, 0x981FU, 0x783AU, 0x7019U, 0xDDFEU, 0xFFFFU, 0xFFFFU, 0xFFFFU, 0xFFFFU, 0xFFFFU, 0xFFFFU, 0xFFFFU, 0xFFFFU,
    0xFFFFU, 0xF73FU, 0xC35FU, 0x901FU, 0x901FU, 0x981FU, 0x981FU, 0x981FU, 0x983FU, 0x7019U, 0x91BAU, 0xFFFFU, 0xFFFFU, 0xFFFFU, 0xFFFFU, 0xFFFFU,
    0xFFFFU, 0xFFFFU, 0xFFFFU, 0xFFFFU, 0xFFDFU, 0xFFFFU, 0xFFFFU, 0xEE5FU, 0xB23FU, 0x901FU, 0x901FU, 0x983FU, 0x983FU, 0x7019U, 0xD57DU, 0xFFFFU,
    0xFFDFU, 0xFFFFU, 0xFFFFU, 0xFFFFU, 0xFFFFU, 0xFFFFU, 0xFFFFU, 0xFFFFU, 0xFFFFU, 0xFFFFU, 0xFFFFU, 0xFFFFU, 0xFFFFU, 0xDD3FU, 0xA13FU, 0x901FU,
    0x901FU, 0x915BU, 0xFFDFU, 0xFFFFU, 0xFFFFU, 0xFFFFU, 0xFFFFU, 0xFFFFU, 0xFFFFU, 0xFFFFU, 0xFFFFU, 0xFFFFU, 0xFFFFU, 0xFFFFU, 0xFFFFU, 0xFFFFU,
    0xFFFFU, 0xFFFFU, 0xFF9FU, 0xCC3FU, 0x909FU, 0xCCFDU, 0xFFFFU, 0xFFDFU, 0xFFFFU, 0xFFFFU, 0xFFFFU, 0xFFFFU, 0xFFFFU, 0xFFFFU, 0xFFFFU, 0xFFFFU,
    0xFFFFU, 0xFFFFU, 0xFFFFU, 0xFFFFU, 0xFFFFU, 0xFFDFU, 0xFFFFU, 0xFFFFU, 0xF6FFU, 0xFF9FU, 0xFFFFU, 0xFFFFU, 0xFFFFU, 0xFFFFU, 0xFFFFU, 0xFFFFU,
  },
  {
    0xFFFFU, 0xFFFFU, 0xFFFFU, 0xFFFFU, 0xFFFFU, 0xFFFFU, 0xFFFFU, 0xFFFFU, 0xFFFFU, 0xFFFFU, 0xFFFFU, 0xFFFFU, 0xFFFFU, 0xFFFFU, 0xFFDFU, 0xF7BEU,
    0xF7BEU, 0xFFFFU, 0xFFFFU, 0xFFFFU, 0xFFFFU, 0xFFFFU, 0xFFFFU, 0xFFFFU, 0xFFFFU, 0xFFFFU, 0xFFFFU, 0xFFFFU, 0xFFDFU, 0xF7BEU, 0xEF7DU, 0xEF5DU,
    0xE71CU, 0xDEFBU, 0xDEFBU, 0xD69AU, 0xC618U, 0xFFFFU, 0xFFFFU, 0xFFFFU, 0xFFFFU, 0xFFFFU, 0xFFFFU, 0xF79EU, 0xEF7DU, 0xEF5DU, 0xDEFBU, 0xDEFBU,
    0xDEDBU, 0xD6BAU, 0xD6BAU, 0xD6BAU, 0xD6BAU, 0xD6BAU, 0xE71CU, 0xB596U, 0xA514U, 0xFFFFU, 0xFFFFU, 0xFFFFU, 0xFFFFU, 0xFFFFU, 0xFFFFU, 0xCE59U,
    0xAD75U, 0xD69AU, 0xDEDBU, 0xDEDBU, 0xDEDBU, 0xDEDBU, 0xDEDBU, 0xDEDBU, 0xDEDBU, 0xDEDBU, 0xE71CU, 0x7BEFU, 0xA514U, 0xFFFFU, 0xFFFFU, 0xFFFFU,
    0xFFFFU, 0xFFFFU, 0xFFFFU, 0xCE59U, 0x9CF3U, 0xAD55U, 0xBDF7U, 0xD6BAU, 0xDEFBU, 0xDEDBU, 0xDEDBU, 0xDEDBU, 0xDEDBU, 0xDEFBU, 0xC638U, 0x5AEBU,
    0xAD55U, 0xFFFFU, 0xFFFFU, 0xFFFFU, 0xFFFFU, 0xFFFFU, 0xFFFFU, 0xCE59U, 0xA514U, 0xA534U, 0xA514U, 0xAD55U, 0xC638U, 0xDEDBU, 0xDEFBU, 0xDEDBU,
    0xD6BAU, 0xE71CU, 0x9492U, 0x5ACBU, 0xAD55U, 0xFFFFU, 0xFFFFU, 0xFFFFU, 0xFFFFU, 0xFFFFU, 0xFFFFU, 0xCE59U, 0xA514U, 0xA534U, 0xA534U, 0xA534U,
    0xA514U, 0xB596U, 0xCE79U, 0xDEDBU, 0xDEFBU, 0xCE59U, 0x6B6DU, 0x630CU, 0xAD55U, 0xFFFFU, 0xFFFFU, 0xFFFFU, 0xFFFFU, 0xFFFFU, 0xFFFFU, 0xCE59U,
    0xA514U, 0xA534U, 0xA534U, 0xA534U, 0xA534U, 0xA534U, 0xA534U, 0xB5B6U, 0xDEDBU, 0x9CD3U, 0x632CU, 0x630CU, 0xAD55U, 0xFFFFU, 0xFFFFU, 0xFFFFU,
    0xFFFFU, 0xFFFFU, 0xFFFFU, 0xCE59U, 0xA514U, 0xA534U, 0xA534U, 0xA534U, 0xA534U, 0xA534U, 0xA534U, 0xA514U, 0xA534U, 0x738EU, 0x6B6DU, 0x630CU,
    0xAD55U, 0xFFFFU, 0xFFFFU, 0xFFFFU, 0xFFFFU, 0xFFFFU, 0xFFFFU, 0xCE59U, 0xA514U, 0xA534U, 0xA534U, 0xA534U, 0xA534U, 0xA534U, 0xA534U, 0xA534U,
    0xA534U, 0x738EU, 0x6B6DU, 0x630CU, 0xAD55U, 0xFFFFU, 0xFFFFU, 0xFFFFU, 0xFFFFU, 0xFFFFU, 0xFFFFU, 0xCE59U, 0xA514U, 0xA534U, 0xA534U, 0xA534U,
    0xA534U, 0xA534U, 0xA534U, 0xA534U, 0xA534U, 0x738EU, 0x6B6DU, 0x630CU, 0xAD55U, 0xFFFFU, 0xFFFFU, 0xFFFFU, 0xFFFFU, 0xFFFFU, 0xFFFFU, 0xCE59U,
    0xA514U, 0xA534U, 0xA534U, 0xA534U, 0xA534U, 0xA534U, 0xA534U, 0xA534U, 0xA534U, 0x738EU, 0x6B6DU, 0x630CU, 0xAD55U, 0xFFFFU, 0xFFFFU, 0xFFFFU,
    0xFFFFU, 0xFFFFU, 0xFFFFU, 0xCE59U, 0xA514U, 0xAD55U, 0xA534U, 0xA534U, 0xA534U, 0xA534U, 0xA534U, 0xA534U, 0xA534U, 0x738EU, 0x6B4DU, 0x632CU,
    0xD6BAU, 0xFFFFU, 0xFFFFU, 0xFFFFU, 0xFFFFU, 0xFFFFU, 0xFFFFU, 0xCE79U, 0x9CD3U, 0xA534U, 0xAD55U, 0xA534U, 0xA534U, 0xA534U, 0xA534U, 0xA534U,
    0xA534U, 0x73AEU, 0x630CU, 0x8C71U, 0xFFFFU, 0xFFFFU, 0xFFFFU, 0xFFFFU, 0xFFFFU, 0xFFFFU, 0xFFFFU, 0xFFDFU, 0xD6BAU, 0xAD55U, 0xA514U, 0xA534U,
    0xA534U, 0xA534U, 0xA534U, 0xA534U, 0xA534U, 0x73AEU, 0x630CU, 0xD69AU, 0xFFFFU, 0xFFFFU, 0xFFFFU, 0xFFFFU, 0xFFFFU, 0xFFFFU, 0xFFFFU, 0xFFFFU,
    0xFFFFU, 0xF7BEU, 0xCE59U, 0xA534U, 0xA514U, 0xA534U, 0xA534U, 0xA534U, 0xA534U, 0x6B6DU, 0x8410U, 0xFFFFU, 0xFFFFU, 0xFFFFU, 0xFFFFU, 0xFFFFU,
    0xFFFFU, 0xFFFFU, 0xFFFFU, 0xFFFFU, 0xFFFFU, 0xFFFFU, 0xFFFFU, 0xEF7DU, 0xBDF7U, 0xA514U, 0xA514U, 0xAD55U, 0xA534U, 0x6B4DU, 0xC618U, 0xFFFFU,
    0xFFFFU, 0xFFFFU, 0xFFFFU, 0xFFFFU, 0xFFFFU, 0xFFFFU, 0xFFFFU, 0xFFFFU, 0xFFFFU, 0xFFFFU, 0xFFFFU, 0xFFFFU, 0xFFFFU, 0xE71CU, 0xB596U, 0xA514U,
    0x9CF3U, 0x8410U, 0xFFDFU, 0xFFFFU, 0xFFFFU, 0xFFFFU, 0xFFFFU, 0xFFFFU, 0xFFFFU, 0xFFFFU, 0xFFFFU, 0xFFFFU, 0xFFFFU, 0xFFFFU, 0xFFFFU, 0xFFFFU,
    0xFFFFU, 0xFFFFU, 0xFFFFU, 0xD6BAU, 0xA514U, 0xC618U, 0xFFFFU, 0xFFFFU, 0xFFFFU, 0xFFFFU, 0xFFFFU, 0xFFFFU, 0xFFFFU, 0xFFFFU, 0xFFFFU, 0xFFFFU,
    0xFFFFU, 0xFFFFU, 0xFFFFU, 0xFFFFU, 0xFFFFU, 0xFFFFU, 0xFFFFU, 0xFFFFU, 0xF79EU, 0xFFDFU, 0xFFFFU, 0xFFFFU, 0xFFFFU, 0xFFFFU, 0xFFFFU, 0xFFFFU,
  },
  {
    0xFFFFU, 0xFFFFU, 0xFFFFU, 0xFFFFU, 0xFFFFU, 0xFFFFU, 0xFFFFU, 0xFFFFU, 0xFFFFU, 0xFFFFU, 0xFFFFU, 0xFFFFU, 0xFFFFU, 0xFFFFU, 0xEF7DU, 0xDEDBU,
    0xDEFBU, 0xFFFFU, 0xFFFFU, 0xFFFFU, 0xFFFFU, 0xFFFFU, 0xFFFFU, 0xFFFFU, 0xFFFFU, 0xFFFFU, 0xFFFFU, 0xF7BEU, 0xEF5DU, 0xD6BAU, 0xC618U, 0xAD55U,
    0x94B2U, 0x8410U, 0x7BCFU, 0x5AEBU, 0x8410U, 0xFFFFU, 0xFFFFU, 0xFFFFU, 0xFFFFU, 0xFFFFU, 0xFFFFU, 0xDEDBU, 0xB596U, 0xA514U, 0x8C51U, 0x7BCFU,
    0x6B6DU, 0x632CU, 0x630CU, 0x630CU, 0x632CU, 0x632CU, 0x73AEU, 0x39E7U, 0x632CU, 0xFFFFU, 0xFFDFU, 0xFFFFU, 0xFFFFU, 0xFFFFU, 0xFFFFU, 0x8410U,
    0x2965U, 0x630CU, 0x6B6DU, 0x6B6DU, 0x6B6DU, 0x6B6DU, 0x738EU, 0x738EU, 0x738EU, 0x6B6DU, 0x7BCFU, 0x0861U, 0x632CU, 0xFFFFU, 0xFFDFU, 0xFFFFU,
    0xFFFFU, 0xFFFFU, 0xFFFFU, 0x8C51U, 0x2124U, 0x39C7U, 0x528AU, 0x6B6DU, 0x738EU, 0x6B6DU, 0x6B6DU, 0x6B6DU, 0x6B6DU, 0x738EU, 0x5ACBU, 0x0000U,
    0x6B4DU, 0xFFFFU, 0xFFDFU, 0xFFFFU, 0xFFFFU, 0xFFFFU, 0xFFFFU, 0x8C51U, 0x2124U, 0x31A6U, 0x2965U, 0x39C7U, 0x5ACBU, 0x738EU, 0x738EU, 0x6B6DU,
    0x6B6DU, 0x73AEU, 0x2945U, 0x0000U, 0x6B6DU, 0xFFFFU, 0xFFDFU, 0xFFFFU, 0xFFFFU, 0xFFFFU, 0xFFFFU, 0x8C51U, 0x2124U, 0x31A6U, 0x31A6U, 0x3186U,
    0x2965U, 0x4208U, 0x630CU, 0x738EU, 0x73AEU, 0x5AEBU, 0x0020U, 0x0000U, 0x6B4DU, 0xFFFFU, 0xFFDFU, 0xFFFFU, 0xFFFFU, 0xFFFFU, 0xFFFFU, 0x8C51U,
    0x2124U, 0x31A6U, 0x3186U, 0x3186U, 0x31A6U, 0x3186U, 0x3186U, 0x4228U, 0x6B6DU, 0x2965U, 0x0000U, 0x0000U, 0x6B4DU, 0xFFFFU, 0xFFDFU, 0xFFFFU,
    0xFFFFU, 0xFFFFU, 0xFFFFU, 0x8C51U, 0x2124U, 0x31A6U, 0x3186U, 0x3186U, 0x3186U, 0x31A6U, 0x3186U, 0x2965U, 0x31A6U, 0x0841U, 0x0000U, 0x0000U,
    0x6B4DU, 0xFFFFU, 0xFFDFU, 0xFFFFU, 0xFFFFU, 0xFFFFU, 0xFFFFU, 0x8C51U, 0x2124U, 0x31A6U, 0x3186U, 0x3186U, 0x3186U, 0x3186U, 0x3186U, 0x31A6U,
    0x3186U, 0x0020U, 0x0000U, 0x0000U, 0x6B4DU, 0xFFFFU, 0xFFDFU, 0xFFFFU, 0xFFFFU, 0xFFFFU, 0xFFFFU, 0x8C51U, 0x2124U, 0x31A6U, 0x3186U, 0x3186U,
    0x3186U, 0x3186U, 0x3186U, 0x3186U, 0x3186U, 0x0020U, 0x0000U, 0x0000U, 0x6B4DU, 0xFFFFU, 0xFFDFU, 0xFFFFU, 0xFFFFU, 0xFFFFU, 0xFFFFU, 0x8C51U,
    0x2124U, 0x31A6U, 0x3186U, 0x3186U, 0x3186U, 0x3186U, 0x3186U, 0x3186U, 0x3186U, 0x0020U, 0x0000U, 0x0000U, 0x6B4DU, 0xFFFFU, 0xFFDFU, 0xFFFFU,
    0xFFFFU, 0xFFFFU, 0xFFFFU, 0x8430U, 0x2124U, 0x31A6U, 0x3186U, 0x3186U, 0x3186U, 0x3186U, 0x3186U, 0x3186U, 0x3186U, 0x0020U, 0x0000U, 0x0000U,
    0xBDD7U, 0xFFFFU, 0xFFFFU, 0xFFFFU, 0xFFFFU, 0xFFFFU, 0xFFFFU, 0x9492U, 0x18C3U, 0x3186U, 0x31A6U, 0x3186U, 0x3186U, 0x3186U, 0x3186U, 0x3186U,
    0x3186U, 0x0841U, 0x0000U, 0x39C7U, 0xFFFFU, 0xFFFFU, 0xFFFFU, 0xFFFFU, 0xFFFFU, 0xFFFFU, 0xFFFFU, 0xF7BEU, 0xA534U, 0x39E7U, 0x2124U, 0x3186U,
    0x31A6U, 0x3186U, 0x3186U, 0x3186U, 0x3186U, 0x0841U, 0x0000U, 0xAD75U, 0xFFFFU, 0xFFDFU, 0xFFFFU, 0xFFFFU, 0xFFFFU, 0xFFFFU, 0xFFFFU, 0xFFFFU,
    0xFFFFU, 0xEF5DU, 0x8430U, 0x3186U, 0x2945U, 0x31A6U, 0x31A6U, 0x3186U, 0x31A6U, 0x0000U, 0x2945U, 0xFFDFU, 0xFFFFU, 0xFFFFU, 0xFFFFU, 0xFFFFU,
    0xFFFFU, 0xFFFFU, 0xFFFFU, 0xFFFFU, 0xFFFFU, 0xFFFFU, 0xFFFFU, 0xD6BAU, 0x6B4DU, 0x2124U, 0x2965U, 0x31A6U, 0x31A6U, 0x0000U, 0x9CD3U, 0xFFFFU,
    0xFFDFU, 0xFFFFU, 0xFFFFU, 0xFFFFU, 0xFFFFU, 0xFFFFU, 0xFFFFU, 0xFFFFU, 0xFFFFU, 0xFFFFU, 0xFFFFU, 0xFFFFU, 0xFFFFU, 0xBDD7U, 0x4A69U, 0x2124U,
    0x2124U, 0x2104U, 0xF7BEU, 0xFFFFU, 0xFFFFU, 0xFFFFU, 0xFFFFU, 0xFFFFU, 0xFFFFU, 0xFFFFU, 0xFFFFU, 0xFFFFU, 0xFFFFU, 0xFFFFU, 0xFFFFU, 0xFFFFU,
    0xFFFFU, 0xFFFFU, 0xF7BEU, 0xA514U, 0x2965U, 0x9492U, 0xFFFFU, 0xFFFFU, 0xFFFFU, 0xFFFFU, 0xFFFFU, 0xFFFFU, 0xFFFFU, 0xFFFFU, 0xFFFFU, 0xFFFFU,
    0xFFFFU, 0xFFFFU, 0xFFFFU, 0xFFFFU, 0xFFFFU, 0xFFFFU, 0xFFFFU, 0xFFFFU, 0xE71CU, 0xF79EU, 0xFFFFU, 0xFFFFU, 0xFFFFU, 0xFFFFU, 0xFFFFU, 0xFFFFU,
  },
  {
    0xFFFFU, 0xFFFFU, 0xFFFFU, 0xFFFFU, 0xFFFFU, 0xFFFFU, 0xFFFFU, 0xFFFFU, 0xFFFFU, 0xFFFFU, 0xFFBEU, 0xFFFFU, 0xFFFFU, 0xFFFFU, 0xFFFFU, 0xFFFFU,
    0xFFFFU, 0xFFFFU, 0xFFFFU, 0xFFFFU, 0xFFFFU, 0xFFFFU, 0xFFFFU, 0xFFFFU, 0xFFFFU, 0xFFFFU, 0xFFFFU, 0xFF5DU, 0xFE9AU, 0xFDB6U, 0xFCF3U, 0xFDF7U,
    0xFF9EU, 0xFFFFU, 0xFFFFU, 0xFFFFU, 0xFFFFU, 0xFFFFU, 0xFFFFU, 0xFFFFU, 0xFFFFU, 0xFFFFU, 0xFFFFU, 0xFFDFU, 0xFF1CU, 0xFE18U, 0xFD55U, 0xFCB2U,
    0xFC92U, 0xFC92U, 0xFCB2U, 0xFC92U, 0xFCF3U, 0xFE79U, 0xFFFFU, 0xFFFFU, 0xFFFFU, 0xFFFFU, 0xFFFFU, 0xFFFFU, 0xFFFFU, 0xFFFFU, 0xFFFFU, 0xF596U,
    0xFC71U, 0xFC92U, 0xFCB2U, 0xFCD3U, 0xFCD3U, 0xFCD3U, 0xFCD3U, 0xFCD3U, 0xFCD3U, 0xFC92U, 0xFD34U, 0xFEFBU, 0xFFFFU, 0xFFFFU, 0xFFFFU, 0xFFFFU,
    0xFFFFU, 0xFFFFU, 0xFFFFU, 0xE430U, 0xFC71U, 0xFCF3U, 0xFCD3U, 0xFCD3U, 0xFCD3U, 0xFCD3U, 0xFCD3U, 0xFCD3U, 0xFCD3U, 0xFCD3U, 0xFCD3U, 0xFC51U,
    0xF5B6U, 0xFFFFU, 0xFFFFU, 0xFFFFU, 0xFFFFU, 0xFFFFU, 0xFFFFU, 0xD34DU, 0xF3CFU, 0xFCF3U, 0xFCB2U, 0xFCD3U, 0xFCD3U, 0xFCD3U, 0xFCD3U, 0xFCD3U,
    0xFCD3U, 0xFCD3U, 0xFD55U, 0xE145U, 0xEBEFU, 0xFFFFU, 0xFFDFU, 0xFFFFU, 0xFFFFU, 0xFFDFU, 0xFFFFU, 0xCACBU, 0xE2CBU, 0xFD75U, 0xFCD3U, 0xFCF3U,
    0xFCD3U, 0xFCD3U, 0xFCB2U, 0xFCB2U, 0xFCB2U, 0xFD34U, 0xEA8AU, 0xD000U, 0xEC51U, 0xFFFFU, 0xFFDFU, 0xFFFFU, 0xFFFFU, 0xFFDFU, 0xFFFFU, 0xCACBU,
    0xC924U, 0xFC30U, 0xFC30U, 0xFC71U, 0xFCB2U, 0xFCF3U, 0xFD14U, 0xFD14U, 0xFD55U, 0xF2EBU, 0xD000U, 0xD000U, 0xEC51U, 0xFFFFU, 0xFFDFU, 0xFFFFU,
    0xFFFFU, 0xFFDFU, 0xFFFFU, 0xCB0CU, 0xC000U, 0xF800U, 0xF800U, 0xF841U, 0xF8A2U, 0xF8E3U, 0xF945U, 0xF9C7U, 0xF9E7U, 0xD800U, 0xD800U, 0xD000U,
    0xEC51U, 0xFFFFU, 0xFFDFU, 0xFFFFU, 0xFFFFU, 0xFFDFU, 0xFFFFU, 0xCB0CU, 0xC800U, 0xF820U, 0xF800U, 0xF800U, 0xF800U, 0xF800U, 0xF800U, 0xF800U,
    0xF000U, 0xD000U, 0xD820U, 0xD000U, 0xEC51U, 0xFFFFU, 0xFFDFU, 0xFFFFU, 0xFFFFU, 0xFFDFU, 0xFFFFU, 0xCB0CU, 0xC800U, 0xF820U, 0xF800U, 0xF800U,
    0xF800U, 0xF800U, 0xF800U, 0xF800U, 0xF000U, 0xD000U, 0xD820U, 0xD000U, 0xEC51U, 0xFFFFU, 0xFFDFU, 0xFFFFU, 0xFFFFU, 0xFFDFU, 0xFFFFU, 0xCB0CU,
    0xC800U, 0xF820U, 0xF800U, 0xF800U, 0xF800U, 0xF800U, 0xF800U, 0xF800U, 0xF000U, 0xD000U, 0xD820U, 0xD000U, 0xEC51U, 0xFFFFU, 0xFFDFU, 0xFFFFU,
    0xFFFFU, 0xFFDFU, 0xFFFFU, 0xCB0CU, 0xC800U, 0xF820U, 0xF800U, 0xF800U, 0xF800U, 0xF800U, 0xF800U, 0xF800U, 0xF000U, 0xD000U, 0xD820U, 0xD000U,
    0xEC51U, 0xFFFFU, 0xFFDFU, 0xFFFFU, 0xFFFFU, 0xFFDFU, 0xFFFFU, 0xCB2CU, 0xC800U, 0xF820U, 0xF800U, 0xF800U, 0xF800U, 0xF800U, 0xF800U, 0xF800U,
    0xF000U, 0xD000U, 0xD820U, 0xD000U, 0xEC30U, 0xFFFFU, 0xFFDFU, 0xFFFFU, 0xFFFFU, 0xFFDFU, 0xFFFFU, 0xDD14U, 0xC800U, 0xF820U, 0xF800U, 0xF800U,
    0xF800U, 0xF800U, 0xF800U, 0xF800U, 0xF000U, 0xD000U, 0xD820U, 0xD000U, 0xEC92U, 0xFFFFU, 0xFFDFU, 0xFFFFU, 0xFFFFU, 0xFFFFU, 0xFFFFU, 0xF71CU,
    0xC841U, 0xF800U, 0xF800U, 0xF800U, 0xF800U, 0xF800U, 0xF800U, 0xF800U, 0xF000U, 0xD820U, 0xD000U, 0xE1E7U, 0xFF9EU, 0xFFFFU, 0xFFFFU, 0xFFFFU,
    0xFFFFU, 0xFFFFU, 0xFFFFU, 0xFFFFU, 0xD9A6U, 0xF800U, 0xF820U, 0xF820U, 0xF820U, 0xF820U, 0xF800U, 0xF800U, 0xF020U, 0xD000U, 0xD945U, 0xFF7DU,
    0xFFFFU, 0xFFFFU, 0xFFFFU, 0xFFFFU, 0xFFFFU, 0xFFFFU, 0xFFDFU, 0xFFFFU, 0xF3AEU, 0xF800U, 0xF800U, 0xF800U, 0xF800U, 0xF800U, 0xF800U, 0xF800U,
    0xF000U, 0xD8A2U, 0xFEFBU, 0xFFFFU, 0xFFFFU, 0xFFFFU, 0xFFFFU, 0xFFFFU, 0xFFFFU, 0xFFFFU, 0xFFFFU, 0xFFFFU, 0xFF5DU, 0xFD96U, 0xFCF3U, 0xFC30U,
    0xFB6DU, 0xFACBU, 0xFA28U, 0xF986U, 0xF145U, 0xF659U, 0xFFFFU, 0xFFFFU, 0xFFFFU, 0xFFFFU, 0xFFFFU, 0xFFFFU, 0xFFFFU, 0xFFFFU, 0xFFFFU, 0xFFFFU,
    0xFFFFU, 0xFFFFU, 0xFFFFU, 0xFFFFU, 0xFFFFU, 0xFFFFU, 0xFFFFU, 0xFFFFU, 0xFFDFU, 0xFFFFU, 0xFFFFU, 0xFFFFU, 0xFFFFU, 0xFFFFU, 0xFFFFU, 0xFFFFU,
  },
  {
    0xFFFFU, 0xFFFFU, 0xFFFFU, 0xFFFFU, 0xFFFFU, 0xFFFFU, 0xFFFFU, 0xFFFFU, 0xFFFFU, 0xFFFFU, 0xFFDEU, 0xFFFFU, 0xFFFFU, 0xFFFFU, 0xFFFFU, 0xFFFFU,
    0xFFFFU, 0xFFFFU, 0xFFFFU, 0xFFFFU, 0xFFFFU, 0xFFFFU, 0xFFFFU, 0xFFFFU, 0xFFFFU, 0xFFFFU, 0xFFFFU, 0xFFBDU, 0xFF58U, 0xFED4U, 0xFE71U, 0xFEF5U,
    0xFFDDU, 0xFFFFU, 0xFFFFU, 0xFFFFU, 0xFFFFU, 0xFFFFU, 0xFFFFU, 0xFFFFU, 0xFFFFU, 0xFFFFU, 0xFFFFU, 0xFFFFU, 0xFF9BU, 0xFF16U, 0xFEB2U, 0xFE4FU,
    0xFE4EU, 0xFE4FU, 0xFE4FU, 0xFE4EU, 0xFE70U, 0xFF37U, 0xFFFFU, 0xFFFFU, 0xFFFFU, 0xFFFFU, 0xFFFFU, 0xFFFFU, 0xFFFFU, 0xFFFFU, 0xFFFFU, 0xFED5U,
    0xFE2EU, 0xFE4FU, 0xFE4FU, 0xFE70U, 0xFE70U, 0xFE70U, 0xFE70U, 0xFE70U, 0xFE6FU, 0xFE4EU, 0xFE91U, 0xFF7AU, 0xFFFFU, 0xFFFFU, 0xFFFFU, 0xFFFFU,
    0xFFFFU, 0xFFFFU, 0xFFFFU, 0xEE11U, 0xFE2EU, 0xFE70U, 0xFE70U, 0xFE70U, 0xFE70U, 0xFE70U, 0xFE70U, 0xFE70U, 0xFE70U, 0xFE70U, 0xFE6FU, 0xFE2EU,
    0xFEB5U, 0xFFFFU, 0xFFFFU, 0xFFFFU, 0xFFFFU, 0xFFFFU, 0xFFFFU, 0xE58EU, 0xF5ABU, 0xFE90U, 0xFE4FU, 0xFE6FU, 0xFE70U, 0xFE70U, 0xFE70U, 0xFE70U,
    0xFE70U, 0xFE4FU, 0xFEB1U, 0xECA5U, 0xF5AEU, 0xFFFFU, 0xFFFFU, 0xFFFFU, 0xFFFFU, 0xFFFFU, 0xFFFFU, 0xDD4CU, 0xED08U, 0xFED2U, 0xFE70U, 0xFE70U,
    0xFE70U, 0xFE70U, 0xFE4FU, 0xFE4FU, 0xFE4FU, 0xFE91U, 0xF549U, 0xE360U, 0xF5EFU, 0xFFFFU, 0xFFFFU, 0xFFFFU, 0xFFFFU, 0xFFFFU, 0xFFFFU, 0xDD4DU,
    0xDC03U, 0xFE2EU, 0xFE0DU, 0xFE2EU, 0xFE4FU, 0xFE70U, 0xFE70U, 0xFE70U, 0xFEB1U, 0xF58AU, 0xE3E0U, 0xE3A0U, 0xF5EFU, 0xFFFFU, 0xFFFFU, 0xFFFFU,
    0xFFFFU, 0xFFFFU, 0xFFFFU, 0xDD6DU, 0xDB60U, 0xFC60U, 0xFC60U, 0xFC81U, 0xFCA2U, 0xFCC3U, 0xFCE4U, 0xFD25U, 0xFD26U, 0xE3E0U, 0xE3E0U, 0xE3A0U,
    0xF5EFU, 0xFFFFU, 0xFFFFU, 0xFFFFU, 0xFFFFU, 0xFFFFU, 0xFFFFU, 0xDD6DU, 0xDB60U, 0xFC80U, 0xFC60U, 0xFC40U, 0xFC40U, 0xFC40U, 0xFC40U, 0xFC40U,
    0xFC20U, 0xE3E0U, 0xE400U, 0xE3A0U, 0xF5EFU, 0xFFFFU, 0xFFFFU, 0xFFFFU, 0xFFFFU, 0xFFFFU, 0xFFFFU, 0xDD6DU, 0xDB60U, 0xFC80U, 0xFC60U, 0xFC60U,
    0xFC60U, 0xFC60U, 0xFC60U, 0xFC60U, 0xFC40U, 0xE3E0U, 0xE400U, 0xE3A0U, 0xF5EFU, 0xFFFFU, 0xFFFFU, 0xFFFFU, 0xFFFFU, 0xFFFFU, 0xFFFFU, 0xDD6DU,
    0xDB60U, 0xFC80U, 0xFC60U, 0xFC60U, 0xFC60U, 0xFC60U, 0xFC60U, 0xFC60U, 0xFC40U, 0xE3E0U, 0xE400U, 0xE3A0U, 0xF5EFU, 0xFFFFU, 0xFFFFU, 0xFFFFU,
    0xFFFFU, 0xFFFFU, 0xFFFFU, 0xDD4DU, 0xDB60U, 0xFC80U, 0xFC60U, 0xFC60U, 0xFC60U, 0xFC60U, 0xFC60U, 0xFC60U, 0xFC40U, 0xE3E0U, 0xE400U, 0xE3A0U,
    0xF5EFU, 0xFFFFU, 0xFFFFU, 0xFFFFU, 0xFFFFU, 0xFFFFU, 0xFFFFU, 0xE56EU, 0xDB60U, 0xFC80U, 0xFC60U, 0xFC60U, 0xFC60U, 0xFC60U, 0xFC60U, 0xFC60U,
    0xFC40U, 0xE3E0U, 0xE400U, 0xE3A0U, 0xF5EFU, 0xFFFFU, 0xFFFFU, 0xFFFFU, 0xFFFFU, 0xFFFFU, 0xFFFFU, 0xEE95U, 0xDB80U, 0xFC60U, 0xFC60U, 0xFC60U,
    0xFC60U, 0xFC60U, 0xFC60U, 0xFC60U, 0xFC40U, 0xE3E0U, 0xE400U, 0xE380U, 0xF610U, 0xFFFFU, 0xFFFFU, 0xFFFFU, 0xFFFFU, 0xFFFFU, 0xFFFFU, 0xFF9DU,
    0xDC01U, 0xFC60U, 0xFC60U, 0xFC60U, 0xFC60U, 0xFC60U, 0xFC60U, 0xFC60U, 0xFC40U, 0xE400U, 0xE3A0U, 0xECA6U, 0xFFBDU, 0xFFFFU, 0xFFFFU, 0xFFFFU,
    0xFFFFU, 0xFFFFU, 0xFFFFU, 0xFFFFU, 0xECE8U, 0xFC40U, 0xFC60U, 0xFC60U, 0xFC60U, 0xFC60U, 0xFC60U, 0xFC60U, 0xFC60U, 0xE3C0U, 0xEC64U, 0xFF9CU,
    0xFFFFU, 0xFFFFU, 0xFFFFU, 0xFFFFU, 0xFFFFU, 0xFFFFU, 0xFFFFU, 0xFFFFU, 0xF610U, 0xFBE0U, 0xFC20U, 0xFC00U, 0xFC00U, 0xFC20U, 0xFC20U, 0xFC40U,
    0xFC00U, 0xE402U, 0xFF5AU, 0xFFFFU, 0xFFFFU, 0xFFFFU, 0xFFFFU, 0xFFFFU, 0xFFFFU, 0xFFFFU, 0xFFFFU, 0xFFFFU, 0xFFBDU, 0xFED6U, 0xFE93U, 0xFE50U,
    0xFDEEU, 0xFDABU, 0xFD48U, 0xFD06U, 0xFCA4U, 0xFF18U, 0xFFFFU, 0xFFFFU, 0xFFFFU, 0xFFFFU, 0xFFFFU, 0xFFFFU, 0xFFFFU, 0xFFFFU, 0xFFFFU, 0xFFFFU,
    0xFFFFU, 0xFFFFU, 0xFFFFU, 0xFFFFU, 0xFFFFU, 0xFFFFU, 0xFFFFU, 0xFFFFU, 0xFFFFU, 0xFFFFU, 0xFFFFU, 0xFFFFU, 0xFFFFU, 0xFFFFU, 0xFFFFU, 0xFFFFU,
  },
  {
    0xFFFFU, 0xFFFFU, 0xFFFFU, 0xFFFFU, 0xFFFFU, 0xFFFFU, 0xFFFFU, 0xFFFFU, 0xFFFFU, 0xFFFFU, 0xFFFEU, 0xFFFFU, 0xFFFFU, 0xFFFFU, 0xFFFFU, 0xFFFFU,
    0xFFFFU, 0xFFFFU, 0xFFFFU, 0xFFFFU, 0xFFFFU, 0xFFFFU, 0xFFFFU, 0xFFFFU, 0xFFFFU, 0xFFFFU, 0xFFFFU, 0xFFFDU, 0xFFFAU, 0xFFF6U, 0xFFF3U, 0xFFF7U,
    0xFFFEU, 0xFFFFU, 0xFFFFU, 0xFFFFU, 0xFFFFU, 0xFFFFU, 0xFFFFU, 0xFFFFU, 0xFFFFU, 0xFFFFU, 0xFFFFU, 0xFFFFU, 0xFFFCU, 0xFFF8U, 0xFFF5U, 0xFFF2U,
    0xFFF2U, 0xFFF2U, 0xFFF2U, 0xFFF2U, 0xFFF3U, 0xFFF9U, 0xFFFFU, 0xFFFFU, 0xFFFFU, 0xFFFFU, 0xFFFFU, 0xFFFFU, 0xFFFFU, 0xFFFFU, 0xFFFFU, 0xFFB6U,
    0xFFF1U, 0xFFF2U, 0xFFF2U, 0xFFF3U, 0xFFF3U, 0xFFF3U, 0xFFF3U, 0xFFF3U, 0xFFF3U, 0xFFF2U, 0xFFF4U, 0xFFFBU, 0xFFFFU, 0xFFFFU, 0xFFFFU, 0xFFFFU,
    0xFFFFU, 0xFFFFU, 0xFFFFU, 0xEEF0U, 0xFFF1U, 0xFFF3U, 0xFFF3U, 0xFFF3U, 0xFFF3U, 0xFFF3U, 0xFFF3U, 0xFFF3U, 0xFFF3U, 0xFFF3U, 0xFFF3U, 0xFFF1U,
    0xFF96U, 0xFFFFU, 0xFFFFU, 0xFFFFU, 0xFFFFU, 0xFFFFU, 0xFFFFU, 0xE64DU, 0xF78FU, 0xFFF3U, 0xFFF2U, 0xFFF3U, 0xFFF3U, 0xFFF3U, 0xFFF3U, 0xFFF3U,
    0xFFF3U, 0xFFF3U, 0xFFF5U, 0xEE85U, 0xF6CFU, 0xFFFFU, 0xFFFFU, 0xFFFFU, 0xFFFFU, 0xFFFFU, 0xFFFFU, 0xDE0BU, 0xEEEBU, 0xFFF5U, 0xFFF3U, 0xFFF3U,
    0xFFF3U, 0xFFF3U, 0xFFF2U, 0xFFF2U, 0xFFF2U, 0xFFF4U, 0xF6EAU, 0xE580U, 0xF711U, 0xFFFFU, 0xFFFFU, 0xFFFFU, 0xFFFFU, 0xFFFFU, 0xFFFFU, 0xDE0BU,
    0xDDE4U, 0xFFD0U, 0xFFD0U, 0xFFF1U, 0xFFF2U, 0xFFF3U, 0xFFF4U, 0xFFF4U, 0xFFF5U, 0xF72BU, 0xE5C0U, 0xE5C0U, 0xF711U, 0xFFFFU, 0xFFFFU, 0xFFFFU,
    0xFFFFU, 0xFFFFU, 0xFFFFU, 0xDE0CU, 0xDD60U, 0xFEC0U, 0xFEA0U, 0xFEC1U, 0xFEE2U, 0xFEE3U, 0xFF05U, 0xFF27U, 0xFF07U, 0xE5C0U, 0xE5E0U, 0xE5A0U,
    0xF711U, 0xFFFFU, 0xFFFFU, 0xFFFFU, 0xFFFFU, 0xFFFFU, 0xFFFFU, 0xDE0CU, 0xDD60U, 0xFEE0U, 0xFEA0U, 0xFEA0U, 0xFEA0U, 0xFEA0U, 0xFEA0U, 0xFEA0U,
    0xFE60U, 0xE5C0U, 0xE5E0U, 0xE5A0U, 0xF711U, 0xFFFFU, 0xFFFFU, 0xFFFFU, 0xFFFFU, 0xFFFFU, 0xFFFFU, 0xDE0CU, 0xDD60U, 0xFEE0U, 0xFEA0U, 0xFEA0U,
    0xFEA0U, 0xFEA0U, 0xFEA0U, 0xFEC0U, 0xFE80U, 0xE5C0U, 0xE5E0U, 0xE5A0U, 0xF711U, 0xFFFFU, 0xFFFFU, 0xFFFFU, 0xFFFFU, 0xFFFFU, 0xFFFFU, 0xDE0CU,
    0xDD60U, 0xFEE0U, 0xFEA0U, 0xFEA0U, 0xFEA0U, 0xFEA0U, 0xFEA0U, 0xFEC0U, 0xFE80U, 0xE5C0U, 0xE5E0U, 0xE5A0U, 0xF711U, 0xFFFFU, 0xFFFFU, 0xFFFFU,
    0xFFFFU, 0xFFFFU, 0xFFFFU, 0xDE0CU, 0xDD60U, 0xFEE0U, 0xFEA0U, 0xFEA0U, 0xFEA0U, 0xFEA0U, 0xFEA0U, 0xFEC0U, 0xFE80U, 0xE5C0U, 0xE5E0U, 0xE5A0U,
    0xF711U, 0xFFFFU, 0xFFFFU, 0xFFFFU, 0xFFFFU, 0xFFFFU, 0xFFFFU, 0xDE2CU, 0xDD60U, 0xFEE0U, 0xFEA0U, 0xFEA0U, 0xFEA0U, 0xFEA0U, 0xFEA0U, 0xFEC0U,
    0xFE80U, 0xE5C0U, 0xE5E0U, 0xE5A0U, 0xF710U, 0xFFFFU, 0xFFFFU, 0xFFFFU, 0xFFFFU, 0xFFFFU, 0xFFFFU, 0xEED4U, 0xDD60U, 0xFEE0U, 0xFEA0U, 0xFEA0U,
    0xFEA0U, 0xFEA0U, 0xFEA0U, 0xFEC0U, 0xFE80U, 0xE5C0U, 0xE5E0U, 0xE5A0U, 0xF712U, 0xFFFFU, 0xFFFFU, 0xFFFFU, 0xFFFFU, 0xFFFFU, 0xFFFFU, 0xF79CU,
    0xDDA1U, 0xFEC0U, 0xFEA0U, 0xFEA0U, 0xFEA0U, 0xFEA0U, 0xFEA0U, 0xFEC0U, 0xFE80U, 0xE5E0U, 0xE5C0U, 0xEE67U, 0xFFDEU, 0xFFFFU, 0xFFFFU, 0xFFFFU,
    0xFFFFU, 0xFFFFU, 0xFFFFU, 0xFFFFU, 0xE646U, 0xFEA0U, 0xFEC0U, 0xFEC0U, 0xFEC0U, 0xFEC0U, 0xFEA0U, 0xFEC0U, 0xFE80U, 0xE5C0U, 0xEE25U, 0xFFDDU,
    0xFFFFU, 0xFFFFU, 0xFFFFU, 0xFFFFU, 0xFFFFU, 0xFFFFU, 0xFFFFU, 0xFFFFU, 0xF70EU, 0xFE80U, 0xFEA0U, 0xFEA0U, 0xFEA0U, 0xFEA0U, 0xFEA0U, 0xFEA0U,
    0xF660U, 0xE5E2U, 0xFFBBU, 0xFFFFU, 0xFFFFU, 0xFFFFU, 0xFFFFU, 0xFFFFU, 0xFFFFU, 0xFFFFU, 0xFFFFU, 0xFFFFU, 0xFFFDU, 0xFF96U, 0xFF93U, 0xFF70U,
    0xFF4DU, 0xFF2BU, 0xFF08U, 0xFF06U, 0xFEA5U, 0xFF99U, 0xFFFFU, 0xFFFFU, 0xFFFFU, 0xFFFFU, 0xFFFFU, 0xFFFFU, 0xFFFFU, 0xFFFFU, 0xFFFFU, 0xFFFFU,
    0xFFFFU, 0xFFFFU, 0xFFFFU, 0xFFFFU, 0xFFFFU, 0xFFFFU, 0xFFFFU, 0xFFFFU, 0xFFFFU, 0xFFFFU, 0xFFFFU, 0xFFFFU, 0xFFFFU, 0xFFFFU, 0xFFFFU, 0xFFFFU,
  },
  {
    0xFFFFU, 0xFFFFU, 0xFFFFU, 0xFFFFU, 0xFFFFU, 0xFFFFU, 0xFFFFU, 0xFFFFU, 0xFFFFU, 0xFFFFU, 0xF7FEU, 0xFFFFU, 0xFFFFU, 0xFFFFU, 0xFFFFU, 0xFFFFU,
    0xFFFFU, 0xFFFFU, 0xFFFFU, 0xFFFFU, 0xFFFFU, 0xFFFFU, 0xFFFFU, 0xFFFFU, 0xFFFFU, 0xFFFFU, 0xFFFFU, 0xEFFDU, 0xD7FAU, 0xB7F6U, 0x9FF3U, 0xBFF7U,
    0xF7FEU, 0xFFFFU, 0xFFFFU, 0xFFFFU, 0xFFFFU, 0xFFFFU, 0xFFFFU, 0xFFFFU, 0xFFFFU, 0xFFFFU, 0xFFFFU, 0xFFFFU, 0xE7FCU, 0xC7F8U, 0xAFF5U, 0x97F2U,
    0x97F2U, 0x97F2U, 0x97F2U, 0x97F2U, 0x9FF3U, 0xCFF9U, 0xFFFFU, 0xFFFFU, 0xFFFFU, 0xFFFFU, 0xFFFFU, 0xFFFFU, 0xFFFFU, 0xFFFFU, 0xFFFFU, 0xB7B6U,
    0x8FF1U, 0x97F2U, 0x97F2U, 0x9FF3U, 0x9FF3U, 0x9FF3U, 0x9FF3U, 0x9FF3U, 0x9FF3U, 0x97F2U, 0xA7F4U, 0xDFFBU, 0xFFFFU, 0xFFFFU, 0xFFFFU, 0xFFFFU,
    0xFFFFU, 0xFFFFU, 0xFFFFU, 0x86D0U, 0x8FF1U, 0x9FF3U, 0x9FF3U, 0x9FF3U, 0x9FF3U, 0x9FF3U, 0x9FF3U, 0x9FF3U, 0x9FF3U, 0x9FF3U, 0x9FF3U, 0x8FF1U,
    0xB776U, 0xFFFFU, 0xFFFFU, 0xFFFFU, 0xFFFFU, 0xFFFFU, 0xFFFFU, 0x6E2DU, 0x7F6FU, 0x9FF3U, 0x97F2U, 0x9FF3U, 0x9FF3U, 0x9FF3U, 0x9FF3U, 0x9FF3U,
    0x9FF3U, 0x9FF3U, 0xAFF5U, 0x2E45U, 0x7EAFU, 0xFFFFU, 0xFFFFU, 0xFFFFU, 0xFFFFU, 0xFFFFU, 0xFFFFU, 0x5DCBU, 0x5ECBU, 0xAFF5U, 0x9FF3U, 0x9FF3U,
    0x9FF3U, 0x9FF3U, 0x97F2U, 0x97F2U, 0x97F2U, 0xA7F4U, 0x56CAU, 0x0520U, 0x8EF1U, 0xFFFFU, 0xFFFFU, 0xFFFFU, 0xFFFFU, 0xFFFFU, 0xFFFFU, 0x5DCBU,
    0x25C4U, 0x87B0U, 0x87B0U, 0x8FD1U, 0x97F2U, 0x9FF3U, 0xA7F4U, 0xA7F4U, 0xAFF5U, 0x5F0BU, 0x0560U, 0x0560U, 0x8ED1U, 0xFFFFU, 0xFFFFU, 0xFFFFU,
    0xFFFFU, 0xFFFFU, 0xFFFFU, 0x65ECU, 0x0500U, 0x0680U, 0x0660U, 0x0E61U, 0x1682U, 0x1EA3U, 0x2EC5U, 0x3EE7U, 0x3EC7U, 0x0580U, 0x0580U, 0x0560U,
    0x8ED1U, 0xFFFFU, 0xFFFFU, 0xFFFFU, 0xFFFFU, 0xFFFFU, 0xFFFFU, 0x65ECU, 0x0520U, 0x0680U, 0x0640U, 0x0640U, 0x0640U, 0x0640U, 0x0640U, 0x0640U,
    0x0600U, 0x0580U, 0x0580U, 0x0560U, 0x8ED1U, 0xFFFFU, 0xFFFFU, 0xFFFFU, 0xFFFFU, 0xFFFFU, 0xFFFFU, 0x65ECU, 0x0520U, 0x0680U, 0x0640U, 0x0660U,
    0x0660U, 0x0660U, 0x0660U, 0x0660U, 0x0620U, 0x0580U, 0x0580U, 0x0560U, 0x8ED1U, 0xFFFFU, 0xFFFFU, 0xFFFFU, 0xFFFFU, 0xFFFFU, 0xFFFFU, 0x65ECU,
    0x0520U, 0x0680U, 0x0640U, 0x0660U, 0x0660U, 0x0660U, 0x0660U, 0x0660U, 0x0620U, 0x0580U, 0x0580U, 0x0560U, 0x8ED1U, 0xFFFFU, 0xFFFFU, 0xFFFFU,
    0xFFFFU, 0xFFFFU, 0xFFFFU, 0x65ECU, 0x0520U, 0x0680U, 0x0640U, 0x0660U, 0x0660U, 0x0660U, 0x0660U, 0x0660U, 0x0620U, 0x0580U, 0x0580U, 0x0560U,
    0x8ED1U, 0xFFFFU, 0xFFFFU, 0xFFFFU, 0xFFFFU, 0xFFFFU, 0xFFFFU, 0x65ECU, 0x0520U, 0x0680U, 0x0640U, 0x0660U, 0x0660U, 0x0660U, 0x0660U, 0x0660U,
    0x0620U, 0x0580U, 0x0580U, 0x0560U, 0x86D0U, 0xFFFFU, 0xFFFFU, 0xFFFFU, 0xFFFFU, 0xFFFFU, 0xFFFFU, 0xA6B4U, 0x0520U, 0x0680U, 0x0640U, 0x0660U,
    0x0660U, 0x0660U, 0x0660U, 0x0660U, 0x0620U, 0x0580U, 0x05A0U, 0x0540U, 0x96F2U, 0xFFFFU, 0xFFFFU, 0xFFFFU, 0xFFFFU, 0xFFFFU, 0xFFFFU, 0xE77CU,
    0x0D61U, 0x0660U, 0x0660U, 0x0660U, 0x0660U, 0x0660U, 0x0660U, 0x0660U, 0x0620U, 0x0580U, 0x0560U, 0x3E27U, 0xF7DEU, 0xFFFFU, 0xFFFFU, 0xFFFFU,
    0xFFFFU, 0xFFFFU, 0xFFFFU, 0xFFFFU, 0x3606U, 0x0640U, 0x0660U, 0x0660U, 0x0660U, 0x0660U, 0x0660U, 0x0660U, 0x0620U, 0x0560U, 0x2DE5U, 0xEFDDU,
    0xFFFFU, 0xFFFFU, 0xFFFFU, 0xFFFFU, 0xFFFFU, 0xFFFFU, 0xFFFFU, 0xFFFFU, 0x76CEU, 0x0620U, 0x0640U, 0x0640U, 0x0640U, 0x0640U, 0x0640U, 0x0660U,
    0x0600U, 0x15A2U, 0xDFBBU, 0xFFFFU, 0xFFFFU, 0xFFFFU, 0xFFFFU, 0xFFFFU, 0xFFFFU, 0xFFFFU, 0xFFFFU, 0xFFFFU, 0xEFDDU, 0xB776U, 0x9F53U, 0x8730U,
    0x6F0DU, 0x5EEBU, 0x46C8U, 0x36A6U, 0x2E65U, 0xCF79U, 0xFFFFU, 0xFFFFU, 0xFFFFU, 0xFFFFU, 0xFFFFU, 0xFFFFU, 0xFFFFU, 0xFFFFU, 0xFFFFU, 0xFFFFU,
    0xFFFFU, 0xFFFFU, 0xFFFFU, 0xFFFFU, 0xFFFFU, 0xFFFFU, 0xFFFFU, 0xFFFFU, 0xFFFFU, 0xFFFFU, 0xFFFFU, 0xFFFFU, 0xFFFFU, 0xFFFFU, 0xFFFFU, 0xFFFFU,
  },
  {
    0xFFFFU, 0xFFFFU, 0xFFFFU, 0xFFFFU, 0xFFFFU, 0xFFFFU, 0xFFFFU, 0xFFFFU, 0xFFFFU, 0xFFFFU, 0xF7FFU, 0xFFFFU, 0xFFFFU, 0xFFFFU, 0xFFFFU, 0xFFFFU,
    0xFFFFU, 0xFFFFU, 0xFFFFU, 0xFFFFU, 0xFFFFU, 0xFFFFU, 0xFFFFU, 0xFFFFU, 0xFFFFU, 0xFFFFU, 0xFFFFU, 0xEFFFU, 0xD7FFU, 0xB7FFU, 0x9FFFU, 0xBFFFU,
    0xF7FFU, 0xFFFFU, 0xFFFFU, 0xFFFFU, 0xFFFFU, 0xFFFFU, 0xFFFFU, 0xFFFFU, 0xFFFFU, 0xFFFFU, 0xFFFFU, 0xFFFFU, 0xE7FFU, 0xC7FFU, 0xAFFFU, 0x97FFU,
    0x97FFU, 0x97FFU, 0x97FFU, 0x97FFU, 0x9FFFU, 0xCFFFU, 0xFFFFU, 0xFFFFU, 0xFFFFU, 0xFFFFU, 0xFFFFU, 0xFFFFU, 0xFFFFU, 0xFFFFU, 0xFFFFU, 0xB7BEU,
    0x8FFFU, 0x97FFU, 0x97FFU, 0x9FFFU, 0x9FFFU, 0x9FFFU, 0x9FFFU, 0x9FFFU, 0x9FFFU, 0x97FFU, 0xA7FFU, 0xDFFFU, 0xFFFFU, 0xFFFFU, 0xFFFFU, 0xFFFFU,
    0xFFFFU, 0xFFFFU, 0xFFFFU, 0x86DBU, 0x8FFFU, 0x9FFFU, 0x9FFFU, 0x9FFFU, 0x9FFFU, 0x9FFFU, 0x9FFFU, 0x9FFFU, 0x9FFFU, 0x9FFFU, 0x9FFFU, 0x8FFFU,
    0xB77DU, 0xFFFFU, 0xFFFFU, 0xFFFFU, 0xFFFFU, 0xFFFFU, 0xFFFFU, 0x6E38U, 0x7F7DU, 0x9FFFU, 0x97FFU, 0x9FFFU, 0x9FFFU, 0x9FFFU, 0x9FFFU, 0x9FFFU,
    0x9FFFU, 0x9FFFU, 0xAFFFU, 0x2E59U, 0x7EBAU, 0xFFFFU, 0xFFFFU, 0xFFFFU, 0xFFFFU, 0xFFFFU, 0xFFFFU, 0x5DD7U, 0x5EDBU, 0xAFFFU, 0x9FFFU, 0x9FFFU,
    0x9FFFU, 0x9FFFU, 0x97FFU, 0x97FFU, 0x97FFU, 0xA7FFU, 0x56DBU, 0x0534U, 0x8EFBU, 0xFFFFU, 0xFFFFU, 0xFFFFU, 0xFFFFU, 0xFFFFU, 0xFFFFU, 0x5DD7U,
    0x25D7U, 0x87BEU, 0x87BEU, 0x8FDFU, 0x97FFU, 0x9FFFU, 0xA7FFU, 0xA7FFU, 0xAFFFU, 0x5F1CU, 0x0575U, 0x0575U, 0x8EDBU, 0xFFFFU, 0xFFFFU, 0xFFFFU,
    0xFFFFU, 0xFFFFU, 0xFFFFU, 0x65F7U, 0x0514U, 0x069AU, 0x0679U, 0x0E79U, 0x169AU, 0x1EBAU, 0x2EDBU, 0x3EFBU, 0x3EDBU, 0x0596U, 0x0596U, 0x0575U,
    0x8EDBU, 0xFFFFU, 0xFFFFU, 0xFFFFU, 0xFFFFU, 0xFFFFU, 0xFFFFU, 0x65F7U, 0x0534U, 0x069AU, 0x0659U, 0x0659U, 0x0659U, 0x0659U, 0x0659U, 0x0659U,
    0x0618U, 0x0596U, 0x0596U, 0x0575U, 0x8EDBU, 0xFFFFU, 0xFFFFU, 0xFFFFU, 0xFFFFU, 0xFFFFU, 0xFFFFU, 0x65F7U, 0x0534U, 0x069AU, 0x0659U, 0x0679U,
    0x0679U, 0x0679U, 0x0679U, 0x0679U, 0x0638U, 0x0596U, 0x0596U, 0x0575U, 0x8EDBU, 0xFFFFU, 0xFFFFU, 0xFFFFU, 0xFFFFU, 0xFFFFU, 0xFFFFU, 0x65F7U,
    0x0534U, 0x069AU, 0x0659U, 0x0679U, 0x0679U, 0x0679U, 0x0679U, 0x0679U, 0x0638U, 0x0596U, 0x0596U, 0x0575U, 0x8EDBU, 0xFFFFU, 0xFFFFU, 0xFFFFU,
    0xFFFFU, 0xFFFFU, 0xFFFFU, 0x65F7U, 0x0534U, 0x069AU, 0x0659U, 0x0679U, 0x0679U, 0x0679U, 0x0679U, 0x0679U, 0x0638U, 0x0596U, 0x0596U, 0x0575U,
    0x8EDBU, 0xFFFFU, 0xFFFFU, 0xFFFFU, 0xFFFFU, 0xFFFFU, 0xFFFFU, 0x65F7U, 0x0534U, 0x069AU, 0x0659U, 0x0679U, 0x0679U, 0x0679U, 0x0679U, 0x0679U,
    0x0638U, 0x0596U, 0x0596U, 0x0575U, 0x86DBU, 0xFFFFU, 0xFFFFU, 0xFFFFU, 0xFFFFU, 0xFFFFU, 0xFFFFU, 0xA6BAU, 0x0534U, 0x069AU, 0x0659U, 0x0679U,
    0x0679U, 0x0679U, 0x0679U, 0x0679U, 0x0638U, 0x0596U, 0x05B6U, 0x0555U, 0x96FBU, 0xFFFFU, 0xFFFFU, 0xFFFFU, 0xFFFFU, 0xFFFFU, 0xFFFFU, 0xE77DU,
    0x0D75U, 0x0679U, 0x0679U, 0x0679U, 0x0679U, 0x0679U, 0x0679U, 0x0679U, 0x0638U, 0x0596U, 0x0575U, 0x3E38U, 0xF7DFU, 0xFFFFU, 0xFFFFU, 0xFFFFU,
    0xFFFFU, 0xFFFFU, 0xFFFFU, 0xFFFFU, 0x3618U, 0x0659U, 0x0679U, 0x0679U, 0x0679U, 0x0679U, 0x0679U, 0x0679U, 0x0638U, 0x0575U, 0x2DF7U, 0xEFDFU,
    0xFFFFU, 0xFFFFU, 0xFFFFU, 0xFFFFU, 0xFFFFU, 0xFFFFU, 0xFFFFU, 0xFFFFU, 0x76DBU, 0x0638U, 0x0659U, 0x0659U, 0x0659U, 0x0659U, 0x0659U, 0x0679U,
    0x0618U, 0x15B6U, 0xDFBEU, 0xFFFFU, 0xFFFFU, 0xFFFFU, 0xFFFFU, 0xFFFFU, 0xFFFFU, 0xFFFFU, 0xFFFFU, 0xFFFFU, 0xEFDFU, 0xB77DU, 0x9F5DU, 0x873CU,
    0x6F1CU, 0x5EFBU, 0x46DBU, 0x36BAU, 0x2E79U, 0xCF7DU, 0xFFFFU, 0xFFFFU, 0xFFFFU, 0xFFFFU, 0xFFFFU, 0xFFFFU, 0xFFFFU, 0xFFFFU, 0xFFFFU, 0xFFFFU,
    0xFFFFU, 0xFFFFU, 0xFFFFU, 0xFFFFU, 0xFFFFU, 0xFFFFU, 0xFFFFU, 0xFFFFU, 0xFFFFU, 0xFFFFU, 0xFFFFU, 0xFFFFU, 0xFFFFU, 0xFFFFU, 0xFFFFU, 0xFFFFU,
  },
  {
    0xFFFFU, 0xFFFFU, 0xFFFFU, 0xFFFFU, 0xFFFFU, 0xFFFFU, 0xFFFFU, 0xFFFFU, 0xFFFFU, 0xFFFFU, 0xF7DFU, 0xFFFFU, 0xFFFFU, 0xFFFFU, 0xFFFFU, 0xFFFFU,
    0xFFFFU, 0xFFFFU, 0xFFFFU, 0xFFFFU, 0xFFFFU, 0xFFFFU, 0xFFFFU, 0xFFFFU, 0xFFFFU, 0xFFFFU, 0xFFFFU, 0xEF9FU, 0xD71FU, 0xB67FU, 0x9DFFU, 0xBE9FU,
    0xF7BFU, 0xFFFFU, 0xFFFFU, 0xFFFFU, 0xFFFFU, 0xFFFFU, 0xFFFFU, 0xFFFFU, 0xFFFFU, 0xFFFFU, 0xFFFFU, 0xFFFFU, 0xE77FU, 0xC6DFU, 0xAE3FU, 0x9DDFU,
    0x95BFU, 0x95BFU, 0x95DFU, 0x95BFU, 0x9DFFU, 0xCEFFU, 0xFFFFU, 0xFFFFU, 0xFFFFU, 0xFFFFU, 0xFFFFU, 0xFFFFU, 0xFFFFU, 0xFFFFU, 0xFFFFU, 0xBE7FU,
    0x8DBFU, 0x95BFU, 0x95DFU, 0x9DDFU, 0x9DFFU, 0x9DFFU, 0x9DDFU, 0x9DFFU, 0x9DDFU, 0x95BFU, 0xA61FU, 0xDF5FU, 0xFFFFU, 0xFFFFU, 0xFFFFU, 0xFFFFU,
    0xFFFFU, 0xFFFFU, 0xFFFFU, 0x8D7DU, 0x8D9FU, 0x9DFFU, 0x9DFFU, 0x9DDFU, 0x9DDFU, 0x9DDFU, 0x9DDFU, 0x9DDFU, 0x9DDFU, 0x9DFFU, 0x9DDFU, 0x8D9FU,
    0xB65FU, 0xFFFFU, 0xFFFFU, 0xFFFFU, 0xFFFFU, 0xFFFFU, 0xFFFFU, 0x74DCU, 0x74FEU, 0xA61FU, 0x95DFU, 0x9DDFU, 0x9DDFU, 0x9DDFU, 0x9DDFU, 0x9DDFU,
    0x9DDFU, 0x95DFU, 0xAE3FU, 0x33BDU, 0x6CFEU, 0xFFFFU, 0xFFFFU, 0xFFFFU, 0xFFFFU, 0xFFFFU, 0xFFFFU, 0x647BU, 0x541DU, 0xAE5FU, 0x9DFFU, 0x9DFFU,
    0x9DFFU, 0x9DDFU, 0x9DDFU, 0x95DFU, 0x95DFU, 0xA61FU, 0x547EU, 0x021CU, 0x7D5EU, 0xFFFFU, 0xFFFFU, 0xFFFFU, 0xFFFFU, 0xFFFFU, 0xFFFFU, 0x647BU,
    0x1AFBU, 0x859FU, 0x857FU, 0x8DBFU, 0x95DFU, 0x9DFFU, 0xA5FFU, 0xA5FFU, 0xAE3FU, 0x64BEU, 0x029CU, 0x025CU, 0x7D3EU, 0xFFFFU, 0xFFFFU, 0xFFFFU,
    0xFFFFU, 0xFFFFU, 0xFFFFU, 0x6C9BU, 0x021BU, 0x035FU, 0x033FU, 0x0B5FU, 0x139FU, 0x1BBFU, 0x2BFFU, 0x3C3FU, 0x445FU, 0x02BCU, 0x02BCU, 0x025CU,
    0x7D3EU, 0xFFFFU, 0xFFFFU, 0xFFFFU, 0xFFFFU, 0xFFFFU, 0xFFFFU, 0x6C9BU, 0x021BU, 0x035FU, 0x033FU, 0x033FU, 0x031FU, 0x031FU, 0x031FU, 0x031FU,
    0x02FFU, 0x02BCU, 0x02DCU, 0x025CU, 0x7D3EU, 0xFFFFU, 0xFFFFU, 0xFFFFU, 0xFFFFU, 0xFFFFU, 0xFFFFU, 0x6C9BU, 0x021BU, 0x035FU, 0x033FU, 0x033FU,
    0x033FU, 0x033FU, 0x033FU, 0x035FU, 0x033FU, 0x02BCU, 0x02DCU, 0x025CU, 0x7D3EU, 0xFFFFU, 0xFFFFU, 0xFFFFU, 0xFFFFU, 0xFFFFU, 0xFFFFU, 0x6C9BU,
    0x021BU, 0x035FU, 0x033FU, 0x033FU, 0x033FU, 0x033FU, 0x033FU, 0x033FU, 0x031FU, 0x02BCU, 0x02DCU, 0x025CU, 0x7D3EU, 0xFFFFU, 0xFFFFU, 0xFFFFU,
    0xFFFFU, 0xFFFFU, 0xFFFFU, 0x6C9BU, 0x021BU, 0x035FU, 0x033FU, 0x033FU, 0x033FU, 0x033FU, 0x033FU, 0x033FU, 0x031FU, 0x02BCU, 0x02DCU, 0x025CU,
    0x7D3EU, 0xFFFFU, 0xFFFFU, 0xFFFFU, 0xFFFFU, 0xFFFFU, 0xFFFFU, 0x74BCU, 0x021BU, 0x035FU, 0x033FU, 0x033FU, 0x033FU, 0x033FU, 0x033FU, 0x033FU,
    0x031FU, 0x02BCU, 0x02DCU, 0x025CU, 0x7D3EU, 0xFFFFU, 0xFFFFU, 0xFFFFU, 0xFFFFU, 0xFFFFU, 0xFFFFU, 0xAE1DU, 0x023BU, 0x035FU, 0x033FU, 0x033FU,
    0x033FU, 0x033FU, 0x033FU, 0x033FU, 0x031FU, 0x02BCU, 0x02DCU, 0x023CU, 0x857EU, 0xFFFFU, 0xFFFFU, 0xFFFFU, 0xFFFFU, 0xFFFFU, 0xFFFFU, 0xEF7FU,
    0x0ADBU, 0x033FU, 0x033FU, 0x033FU, 0x033FU, 0x033FU, 0x033FU, 0x033FU, 0x031FU, 0x02DCU, 0x025CU, 0x33BDU, 0xEF9FU, 0xFFFFU, 0xFFFFU, 0xFFFFU,
    0xFFFFU, 0xFFFFU, 0xFFFFU, 0xFFFFU, 0x43FDU, 0x031FU, 0x035FU, 0x035FU, 0x035FU, 0x035FU, 0x035FU, 0x035FU, 0x033FU, 0x027CU, 0x235DU, 0xE77FU,
    0xFFFFU, 0xFFFFU, 0xFFFFU, 0xFFFFU, 0xFFFFU, 0xFFFFU, 0xFFFFU, 0xFFFFU, 0x857EU, 0x029FU, 0x02FFU, 0x02DFU, 0x02DFU, 0x02FFU, 0x02FFU, 0x031FU,
    0x02DFU, 0x12DCU, 0xD73FU, 0xFFFFU, 0xFFFFU, 0xFFFFU, 0xFFFFU, 0xFFFFU, 0xFFFFU, 0xFFFFU, 0xFFFFU, 0xFFFFU, 0xEFBFU, 0xB67FU, 0x9E3FU, 0x85BFU,
    0x755FU, 0x5CFFU, 0x447FU, 0x343FU, 0x2BBFU, 0xC6BFU, 0xFFFFU, 0xFFFFU, 0xFFFFU, 0xFFFFU, 0xFFFFU, 0xFFFFU, 0xFFFFU, 0xFFFFU, 0xFFFFU, 0xFFFFU,
    0xFFFFU, 0xFFFFU, 0xFFFFU, 0xFFFFU, 0xFFFFU, 0xFFFFU, 0xFFFFU, 0xFFFFU, 0xFFFFU, 0xFFFFU, 0xFFFFU, 0xFFFFU, 0xFFFFU, 0xFFFFU, 0xFFFFU, 0xFFFFU,
  },
  {
    0xFFFFU, 0xFFFFU, 0xFFFFU, 0xFFFFU, 0xFFFFU, 0xFFFFU, 0xFFFFU, 0xFFFFU, 0xFFFFU, 0xFFFFU, 0xFFDFU, 0xFFFFU, 0xFFFFU, 0xFFFFU, 0xFFFFU, 0xFFFFU,
    0xFFFFU, 0xFFFFU, 0xFFFFU, 0xFFFFU, 0xFFFFU, 0xFFFFU, 0xFFFFU, 0xFFFFU, 0xFFFFU, 0xFFFFU, 0xFFFFU, 0xFF9FU, 0xEEFFU, 0xE63FU, 0xDDDFU, 0xE67FU,
    0xFFBFU, 0xFFFFU, 0xFFFFU, 0xFFFFU, 0xFFFFU, 0xFFFFU, 0xFFFFU, 0xFFFFU, 0xFFFFU, 0xFFFFU, 0xFFFFU, 0xFFFFU, 0xF75FU, 0xEE9FU, 0xDDFFU, 0xDD9FU,
    0xD57FU, 0xD57FU, 0xDD9FU, 0xD57FU, 0xDDBFU, 0xEEDFU, 0xFFFFU, 0xFFFFU, 0xFFFFU, 0xFFFFU, 0xFFFFU, 0xFFFFU, 0xFFFFU, 0xFFFFU, 0xFFFFU, 0xDE1FU,
    0xD57FU, 0xD57FU, 0xDD9FU, 0xDD9FU, 0xDDBFU, 0xDDBFU, 0xDD9FU, 0xDDBFU, 0xDD9FU, 0xD57FU, 0xDDFFU, 0xF75FU, 0xFFFFU, 0xFFFFU, 0xFFFFU, 0xFFFFU,
    0xFFFFU, 0xFFFFU, 0xFFFFU, 0xC47DU, 0xD55FU, 0xDDBFU, 0xDDBFU, 0xDD9FU, 0xDD9FU, 0xDD9FU, 0xDD9FU, 0xDD9FU, 0xDD9FU, 0xDD9FU, 0xDDBFU, 0xD53FU,
    0xDDDFU, 0xFFFFU, 0xFFFFU, 0xFFFFU, 0xFFFFU, 0xFFFFU, 0xFFFFU, 0xB35CU, 0xC49EU, 0xDDDFU, 0xDD9FU, 0xDD9FU, 0xDD9FU, 0xDD9FU, 0xDD9FU, 0xDD9FU,
    0xDD9FU, 0xDD9FU, 0xE61FU, 0x99BDU, 0xC3DEU, 0xFFFFU, 0xFFDFU, 0xFFFFU, 0xFFFFU, 0xFFDFU, 0xFFFFU, 0xA2BBU, 0xB35DU, 0xE65FU, 0xDDBFU, 0xDDBFU,
    0xDDBFU, 0xDD9FU, 0xDD9FU, 0xDD9FU, 0xD57FU, 0xDE1FU, 0xB2FEU, 0x781CU, 0xCC5EU, 0xFFFFU, 0xFFDFU, 0xFFFFU, 0xFFFFU, 0xFFDFU, 0xFFFFU, 0xA2DBU,
    0x917BU, 0xD4FFU, 0xCCDFU, 0xD53FU, 0xDD7FU, 0xDDBFU, 0xDDDFU, 0xDDFFU, 0xE63FU, 0xBB5EU, 0x801CU, 0x801CU, 0xCC5EU, 0xFFFFU, 0xFFDFU, 0xFFFFU,
    0xFFFFU, 0xFFDFU, 0xFFFFU, 0xAB1BU, 0x781BU, 0x981FU, 0x983FU, 0x987FU, 0xA0BFU, 0xA11FU, 0xA99FU, 0xB21FU, 0xB25FU, 0x881CU, 0x883CU, 0x801CU,
    0xCC5EU, 0xFFFFU, 0xFFDFU, 0xFFFFU, 0xFFFFU, 0xFFDFU, 0xFFFFU, 0xAB1BU, 0x781BU, 0x983FU, 0x981FU, 0x981FU, 0x901FU, 0x901FU, 0x901FU, 0x901FU,
    0x901FU, 0x801CU, 0x883CU, 0x781CU, 0xCC5EU, 0xFFFFU, 0xFFDFU, 0xFFFFU, 0xFFFFU, 0xFFDFU, 0xFFFFU, 0xAB1BU, 0x781BU, 0x983FU, 0x981FU, 0x981FU,
    0x981FU, 0x981FU, 0x981FU, 0x981FU, 0x903FU, 0x801CU, 0x883CU, 0x781CU, 0xCC5EU, 0xFFFFU, 0xFFDFU, 0xFFFFU, 0xFFFFU, 0xFFDFU, 0xFFFFU, 0xAB1BU,
    0x781BU, 0x983FU, 0x981FU, 0x981FU, 0x981FU, 0x981FU, 0x981FU, 0x981FU, 0x901FU, 0x801CU, 0x883CU, 0x781CU, 0xCC5EU, 0xFFFFU, 0xFFDFU, 0xFFFFU,
    0xFFFFU, 0xFFDFU, 0xFFFFU, 0xAB1BU, 0x781BU, 0x983FU, 0x981FU, 0x981FU, 0x981FU, 0x981FU, 0x981FU, 0x981FU, 0x901FU, 0x801CU, 0x883CU, 0x781CU,
    0xCC5EU, 0xFFFFU, 0xFFDFU, 0xFFFFU, 0xFFFFU, 0xFFDFU, 0xFFFFU, 0xAB3BU, 0x781BU, 0x983FU, 0x981FU, 0x981FU, 0x981FU, 0x981FU, 0x981FU, 0x981FU,
    0x901FU, 0x801CU, 0x883CU, 0x801CU, 0xC43EU, 0xFFFFU, 0xFFDFU, 0xFFFFU, 0xFFFFU, 0xFFDFU, 0xFFFFU, 0xCD1DU, 0x781BU, 0x983FU, 0x981FU, 0x981FU,
    0x981FU, 0x981FU, 0x981FU, 0x981FU, 0x901FU, 0x801CU, 0x883CU, 0x781CU, 0xCC9EU, 0xFFFFU, 0xFFDFU, 0xFFFFU, 0xFFFFU, 0xFFFFU, 0xFFFFU, 0xEF1EU,
    0x805BU, 0x981FU, 0x981FU, 0x981FU, 0x981FU, 0x981FU, 0x981FU, 0x981FU, 0x901FU, 0x883CU, 0x801CU, 0xA1FDU, 0xFF9FU, 0xFFFFU, 0xFFFFU, 0xFFFFU,
    0xFFFFU, 0xFFFFU, 0xFFFFU, 0xFFFFU, 0xA1BDU, 0x901FU, 0x983FU, 0x983FU, 0x983FU, 0x983FU, 0x981FU, 0x981FU, 0x903FU, 0x801CU, 0x995DU, 0xF77FU,
    0xFFFFU, 0xFFFFU, 0xFFFFU, 0xFFFFU, 0xFFFFU, 0xFFFFU, 0xFFDFU, 0xFFFFU, 0xC3BEU, 0x881FU, 0x901FU, 0x901FU, 0x901FU, 0x901FU, 0x901FU, 0x901FU,
    0x881FU, 0x88BCU, 0xF6FFU, 0xFFFFU, 0xFFFFU, 0xFFFFU, 0xFFFFU, 0xFFFFU, 0xFFFFU, 0xFFFFU, 0xFFFFU, 0xFFFFU, 0xF75FU, 0xDD9FU, 0xDCFFU, 0xCC3FU,
    0xC39FU, 0xBADFU, 0xB23FU, 0xA99FU, 0xA15FU, 0xE65FU, 0xFFFFU, 0xFFFFU, 0xFFFFU, 0xFFFFU, 0xFFFFU, 0xFFFFU, 0xFFFFU, 0xFFFFU, 0xFFFFU, 0xFFFFU,
    0xFFFFU, 0xFFFFU, 0xFFFFU, 0xFFFFU, 0xFFFFU, 0xFFFFU, 0xFFFFU, 0xFFFFU, 0xFFDFU, 0xFFFFU, 0xFFFFU, 0xFFFFU, 0xFFFFU, 0xFFFFU, 0xFFFFU, 0xFFFFU,
  },
  {
    0xFFFFU, 0xFFFFU, 0xFFFFU, 0xFFFFU, 0xFFFFU, 0xFFFFU, 0xFFFFU, 0xFFFFU, 0xFFFFU, 0xFFFFU, 0xFFFFU, 0xFFFFU, 0xFFFFU, 0xFFFFU, 0xFFFFU, 0xFFFFU,
    0xFFFFU, 0xFFFFU, 0xFFFFU, 0xFFFFU, 0xFFFFU, 0xFFFFU, 0xFFFFU, 0xFFFFU, 0xFFFFU, 0xFFFFU, 0xFFFFU, 0xFFDFU, 0xF79EU, 0xE73CU, 0xDEFBU, 0xE73CU,
    0xFFDFU, 0xFFFFU, 0xFFFFU, 0xFFFFU, 0xFFFFU, 0xFFFFU, 0xFFFFU, 0xFFFFU, 0xFFFFU, 0xFFFFU, 0xFFFFU, 0xFFFFU, 0xF7BEU, 0xEF5DU, 0xE71CU, 0xDEDBU,
    0xD6BAU, 0xD6BAU, 0xDEDBU, 0xD6BAU, 0xDEDBU, 0xEF7DU, 0xFFFFU, 0xFFFFU, 0xFFFFU, 0xFFFFU, 0xFFFFU, 0xFFFFU, 0xFFFFU, 0xFFFFU, 0xFFFFU, 0xE71CU,
    0xD6BAU, 0xD6BAU, 0xD6BAU, 0xDEDBU, 0xDEDBU, 0xDEDBU, 0xDEDBU, 0xDEDBU, 0xDEDBU, 0xD6BAU, 0xDEFBU, 0xF79EU, 0xFFFFU, 0xFFFFU, 0xFFFFU, 0xFFFFU,
    0xFFFFU, 0xFFFFU, 0xFFFFU, 0xC618U, 0xD69AU, 0xDEFBU, 0xDEDBU, 0xDEDBU, 0xDEDBU, 0xDEDBU, 0xDEDBU, 0xDEDBU, 0xDEDBU, 0xDEDBU, 0xDEDBU, 0xD6BAU,
    0xDEFBU, 0xFFFFU, 0xFFFFU, 0xFFFFU, 0xFFFFU, 0xFFFFU, 0xFFFFU, 0xAD75U, 0xC618U, 0xDEFBU, 0xDEDBU, 0xDEDBU, 0xDEDBU, 0xDEDBU, 0xDEDBU, 0xDEDBU,
    0xDEDBU, 0xDEDBU, 0xE71CU, 0xAD55U, 0xBDD7U, 0xFFFFU, 0xFFFFU, 0xFFFFU, 0xFFFFU, 0xFFFFU, 0xFFFFU, 0xA534U, 0xA534U, 0xE73CU, 0xDEDBU, 0xDEDBU,
    0xDEDBU, 0xDEDBU, 0xDEDBU, 0xDEDBU, 0xD6BAU, 0xDEFBU, 0xBDF7U, 0x7BEFU, 0xC618U, 0xFFFFU, 0xFFFFU, 0xFFFFU, 0xFFFFU, 0xFFFFU, 0xFFFFU, 0xA534U,
    0x8430U, 0xDEDBU, 0xD69AU, 0xD6BAU, 0xDEDBU, 0xDEDBU, 0xDEFBU, 0xDEFBU, 0xE71CU, 0xC618U, 0x8C51U, 0x8430U, 0xBDF7U, 0xFFFFU, 0xFFFFU, 0xFFFFU,
    0xFFFFU, 0xFFFFU, 0xFFFFU, 0xAD55U, 0x738EU, 0xAD75U, 0xAD55U, 0xAD55U, 0xAD75U, 0xB596U, 0xB5B6U, 0xBDF7U, 0xBDF7U, 0x9492U, 0x8C71U, 0x8430U,
    0xBDF7U, 0xFFFFU, 0xFFFFU, 0xFFFFU, 0xFFFFU, 0xFFFFU, 0xFFFFU, 0xAD55U, 0x738EU, 0xAD75U, 0xA534U, 0xA534U, 0xA534U, 0xA514U, 0xA514U, 0xA514U,
    0x9CF3U, 0x8C51U, 0x8C71U, 0x8430U, 0xBDF7U, 0xFFFFU, 0xFFFFU, 0xFFFFU, 0xFFFFU, 0xFFFFU, 0xFFFFU, 0xAD55U, 0x738EU, 0xAD75U, 0xA534U, 0xA534U,
    0xA534U, 0xA534U, 0xA534U, 0xAD55U, 0xA514U, 0x8C71U, 0x8C71U, 0x8430U, 0xBDF7U, 0xFFFFU, 0xFFFFU, 0xFFFFU, 0xFFFFU, 0xFFFFU, 0xFFFFU, 0xAD55U,
    0x738EU, 0xAD75U, 0xA534U, 0xA534U, 0xA534U, 0xA534U, 0xA534U, 0xA534U, 0xA514U, 0x8C71U, 0x8C71U, 0x8430U, 0xBDF7U, 0xFFFFU, 0xFFFFU, 0xFFFFU,
    0xFFFFU, 0xFFFFU, 0xFFFFU, 0xAD55U, 0x738EU, 0xAD75U, 0xA534U, 0xA534U, 0xA534U, 0xA534U, 0xA534U, 0xA534U, 0xA514U, 0x8C71U, 0x8C71U, 0x8430U,
    0xBDF7U, 0xFFFFU, 0xFFFFU, 0xFFFFU, 0xFFFFU, 0xFFFFU, 0xFFFFU, 0xAD55U, 0x738EU, 0xAD75U, 0xA534U, 0xA534U, 0xA534U, 0xA534U, 0xA534U, 0xA534U,
    0xA514U, 0x8C71U, 0x8C71U, 0x8430U, 0xBDF7U, 0xFFFFU, 0xFFFFU, 0xFFFFU, 0xFFFFU, 0xFFFFU, 0xFFFFU, 0xCE59U, 0x73AEU, 0xAD55U, 0xA534U, 0xA534U,
    0xA534U, 0xA534U, 0xA534U, 0xA534U, 0xA514U, 0x8C71U, 0x8C71U, 0x8410U, 0xC618U, 0xFFFFU, 0xFFFFU, 0xFFFFU, 0xFFFFU, 0xFFFFU, 0xFFFFU, 0xEF7DU,
    0x8430U, 0xAD55U, 0xA534U, 0xA534U, 0xA534U, 0xA534U, 0xA534U, 0xA534U, 0xA514U, 0x8C71U, 0x8430U, 0x9CD3U, 0xF79EU, 0xFFFFU, 0xFFFFU, 0xFFFFU,
    0xFFFFU, 0xFFFFU, 0xFFFFU, 0xFFFFU, 0xA514U, 0xA514U, 0xAD55U, 0xA534U, 0xA534U, 0xA534U, 0xA534U, 0xA534U, 0xA534U, 0x8C51U, 0x9492U, 0xEF7DU,
    0xFFFFU, 0xFFFFU, 0xFFFFU, 0xFFFFU, 0xFFFFU, 0xFFFFU, 0xFFFFU, 0xFFFFU, 0xCE59U, 0x9CD3U, 0xA514U, 0x9CF3U, 0xA514U, 0xA514U, 0xA514U, 0xA534U,
    0x9CF3U, 0x8C51U, 0xE73CU, 0xFFFFU, 0xFFFFU, 0xFFFFU, 0xFFFFU, 0xFFFFU, 0xFFFFU, 0xFFFFU, 0xFFFFU, 0xFFFFU, 0xF7BEU, 0xDEFBU, 0xD6BAU, 0xCE79U,
    0xC638U, 0xBDF7U, 0xBDD7U, 0xB596U, 0xA534U, 0xDEDBU, 0xFFFFU, 0xFFFFU, 0xFFFFU, 0xFFFFU, 0xFFFFU, 0xFFFFU, 0xFFFFU, 0xFFFFU, 0xFFFFU, 0xFFFFU,
    0xFFFFU, 0xFFFFU, 0xFFFFU, 0xFFFFU, 0xFFFFU, 0xFFFFU, 0xFFFFU, 0xFFFFU, 0xFFDFU, 0xFFFFU, 0xFFFFU, 0xFFFFU, 0xFFFFU, 0xFFFFU, 0xFFFFU, 0xFFFFU,
  },
  {
    0xFFFFU, 0xFFFFU, 0xFFFFU, 0xFFFFU, 0xFFFFU, 0xFFFFU, 0xFFFFU, 0xFFFFU, 0xFFFFU, 0xFFFFU, 0xFFDFU, 0xFFFFU, 0xFFFFU, 0xFFFFU, 0xFFFFU, 0xFFFFU,
    0xFFFFU, 0xFFFFU, 0xFFFFU, 0xFFFFU, 0xFFFFU, 0xFFFFU, 0xFFFFU, 0xFFFFU, 0xFFFFU, 0xFFFFU, 0xFFFFU, 0xEF5DU, 0xC638U, 0x9CF3U, 0x7BEFU, 0xA534U,
    0xEF7DU, 0xFFFFU, 0xFFFFU, 0xFFFFU, 0xFFFFU, 0xFFFFU, 0xFFFFU, 0xFFFFU, 0xFFFFU, 0xFFFFU, 0xFFFFU, 0xFFDFU, 0xDEFBU, 0xB5B6U, 0x8C71U, 0x738EU,
    0x632CU, 0x632CU, 0x6B4DU, 0x632CU, 0x73AEU, 0xBDD7U, 0xFFDFU, 0xFFFFU, 0xFFFFU, 0xFFFFU, 0xFFFFU, 0xFFFFU, 0xFFFFU, 0xFFFFU, 0xFFFFU, 0xAD55U,
    0x630CU, 0x632CU, 0x632CU, 0x6B6DU, 0x738EU, 0x738EU, 0x6B6DU, 0x738EU, 0x6B6DU, 0x632CU, 0x8410U, 0xD69AU, 0xFFFFU, 0xFFFFU, 0xFFFFU, 0xFFFFU,
    0xFFFFU, 0xFFFFU, 0xFFFFU, 0x8430U, 0x5AEBU, 0x73AEU, 0x738EU, 0x6B6DU, 0x6B6DU, 0x6B6DU, 0x6B6DU, 0x6B6DU, 0x6B6DU, 0x738EU, 0x6B4DU, 0x630CU,
    0xAD75U, 0xFFFFU, 0xFFFFU, 0xFFFFU, 0xFFFFU, 0xFFDFU, 0xFFFFU, 0x73AEU, 0x4A69U, 0x73AEU, 0x6B6DU, 0x6B6DU, 0x6B6DU, 0x6B6DU, 0x6B6DU, 0x6B6DU,
    0x6B6DU, 0x6B6DU, 0x7BCFU, 0x39C7U, 0x7BCFU, 0xFFFFU, 0xFFDFU, 0xFFFFU, 0xFFFFU, 0xFFDFU, 0xFFFFU, 0x6B4DU, 0x31A6U, 0x7BEFU, 0x6B6DU, 0x6B6DU,
    0x6B6DU, 0x6B6DU, 0x6B6DU, 0x6B6DU, 0x6B6DU, 0x73AEU, 0x52AAU, 0x0841U, 0x8430U, 0xFFFFU, 0xFFDFU, 0xFFFFU, 0xFFFFU, 0xFFDFU, 0xFFFFU, 0x6B4DU,
    0x10A2U, 0x738EU, 0x6B4DU, 0x6B6DU, 0x6B6DU, 0x738EU, 0x738EU, 0x738EU, 0x73AEU, 0x5ACBU, 0x2104U, 0x0861U, 0x8410U, 0xFFFFU, 0xFFDFU, 0xFFFFU,
    0xFFFFU, 0xFFDFU, 0xFFFFU, 0x6B6DU, 0x0000U, 0x39C7U, 0x31A6U, 0x39C7U, 0x39E7U, 0x4208U, 0x4228U, 0x4A69U, 0x528AU, 0x2124U, 0x2104U, 0x1082U,
    0x8410U, 0xFFFFU, 0xFFDFU, 0xFFFFU, 0xFFFFU, 0xFFDFU, 0xFFFFU, 0x6B6DU, 0x0000U, 0x39C7U, 0x3186U, 0x3186U, 0x3186U, 0x3186U, 0x2965U, 0x2965U,
    0x2965U, 0x18E3U, 0x2104U, 0x0861U, 0x8410U, 0xFFFFU, 0xFFDFU, 0xFFFFU, 0xFFFFU, 0xFFDFU, 0xFFFFU, 0x6B6DU, 0x0000U, 0x39C7U, 0x3186U, 0x3186U,
    0x31A6U, 0x31A6U, 0x31A6U, 0x31A6U, 0x3186U, 0x2104U, 0x2104U, 0x0861U, 0x8410U, 0xFFFFU, 0xFFDFU, 0xFFFFU, 0xFFFFU, 0xFFDFU, 0xFFFFU, 0x6B6DU,
    0x0000U, 0x39C7U, 0x3186U, 0x3186U, 0x3186U, 0x3186U, 0x3186U, 0x3186U, 0x3186U, 0x2104U, 0x2104U, 0x0861U, 0x8410U, 0xFFFFU, 0xFFDFU, 0xFFFFU,
    0xFFFFU, 0xFFDFU, 0xFFFFU, 0x6B6DU, 0x0000U, 0x39C7U, 0x3186U, 0x3186U, 0x3186U, 0x3186U, 0x3186U, 0x3186U, 0x3186U, 0x2104U, 0x2104U, 0x0861U,
    0x8410U, 0xFFFFU, 0xFFDFU, 0xFFFFU, 0xFFFFU, 0xFFDFU, 0xFFFFU, 0x738EU, 0x0000U, 0x39C7U, 0x3186U, 0x3186U, 0x3186U, 0x3186U, 0x3186U, 0x3186U,
    0x3186U, 0x2104U, 0x2104U, 0x1082U, 0x8410U, 0xFFFFU, 0xFFDFU, 0xFFFFU, 0xFFFFU, 0xFFFFU, 0xFFFFU, 0xAD55U, 0x0000U, 0x39C7U, 0x3186U, 0x3186U,
    0x3186U, 0x3186U, 0x3186U, 0x3186U, 0x3186U, 0x2104U, 0x2124U, 0x0841U, 0x8430U, 0xFFFFU, 0xFFDFU, 0xFFFFU, 0xFFFFU, 0xFFFFU, 0xFFFFU, 0xE73CU,
    0x18E3U, 0x3186U, 0x3186U, 0x3186U, 0x3186U, 0x3186U, 0x3186U, 0x3186U, 0x3186U, 0x2104U, 0x10A2U, 0x39C7U, 0xE73CU, 0xFFFFU, 0xFFFFU, 0xFFFFU,
    0xFFFFU, 0xFFFFU, 0xFFFFU, 0xFFFFU, 0x4A69U, 0x2965U, 0x39C7U, 0x31A6U, 0x31A6U, 0x31A6U, 0x31A6U, 0x31A6U, 0x31A6U, 0x18C3U, 0x2945U, 0xDEFBU,
    0xFFFFU, 0xFFFFU, 0xFFFFU, 0xFFFFU, 0xFFFFU, 0xFFFFU, 0xFFFFU, 0xFFFFU, 0x9492U, 0x10A2U, 0x2124U, 0x2104U, 0x2124U, 0x2124U, 0x2945U, 0x2965U,
    0x2945U, 0x18E3U, 0xCE59U, 0xFFFFU, 0xFFFFU, 0xFFFFU, 0xFFFFU, 0xFFFFU, 0xFFFFU, 0xFFFFU, 0xFFFFU, 0xFFFFU, 0xEF7DU, 0xB596U, 0xA514U, 0x8C71U,
    0x7BEFU, 0x6B4DU, 0x5AEBU, 0x4A69U, 0x39E7U, 0xB5B6U, 0xFFFFU, 0xFFDFU, 0xFFFFU, 0xFFFFU, 0xFFFFU, 0xFFFFU, 0xFFFFU, 0xFFFFU, 0xFFFFU, 0xFFFFU,
    0xFFFFU, 0xFFFFU, 0xFFFFU, 0xFFFFU, 0xFFFFU, 0xFFFFU, 0xFFFFU, 0xFFDFU, 0xF79EU, 0xFFFFU, 0xFFFFU, 0xFFFFU, 0xFFFFU, 0xFFFFU, 0xFFFFU, 0xFFFFU,
  },
  {
    0xFFFFU, 0xFFFFU, 0xFFFFU, 0xFFFFU, 0xFFFFU, 0xFFFFU, 0xFFFFU, 0xFFFFU, 0xFFFFU, 0xFFFFU, 0xFFDFU, 0xFF9EU, 0xFFFFU, 0xFFFFU, 0xFFFFU, 0xFFFFU,
    0xFFFFU, 0xFFFFU, 0xFFFFU, 0xFFFFU, 0xFFFFU, 0xFFFFU, 0xFFFFU, 0xFFFFU, 0xFFFFU, 0xFF7DU, 0xFEFBU, 0xFE79U, 0xFDF7U, 0xFD96U, 0xFD34U, 0xFCD3U,
    0xFDB6U, 0xFF5DU, 0xFFFFU, 0xFFFFU, 0xFFFFU, 0xFFFFU, 0xFFFFU, 0xFFFFU, 0xFFFFU, 0xFFFFU, 0xFFFFU, 0xFFFFU, 0xFF5DU, 0xFCB2U, 0xFC92U, 0xFC92U,
    0xFC92U, 0xFCB2U, 0xFCB2U, 0xFCD3U, 0xFC92U, 0xFCB2U, 0xFE18U, 0xFFBEU, 0xFFFFU, 0xFFFFU, 0xFFFFU, 0xFFFFU, 0xFFFFU, 0xFFFFU, 0xFFFFU, 0xFFFFU,
    0xFDD7U, 0xFC92U, 0xFCF3U, 0xFCD3U, 0xFCD3U, 0xFCD3U, 0xFCD3U, 0xFCD3U, 0xFCD3U, 0xFCD3U, 0xFC92U, 0xFCF3U, 0xFEDBU, 0xFFFFU, 0xFFFFU, 0xFFFFU,
    0xFFFFU, 0xFFFFU, 0xFFFFU, 0xFF7DU, 0xFCB2U, 0xFCD3U, 0xFCD3U, 0xFCD3U, 0xFCD3U, 0xFCD3U, 0xFCD3U, 0xFCD3U, 0xFCD3U, 0xFCD3U, 0xFCF3U, 0xFC92U,
    0xE3EFU, 0xFFFFU, 0xFFFFU, 0xFFFFU, 0xFFFFU, 0xFFFFU, 0xFFFFU, 0xFDD7U, 0xFCD3U, 0xFCF3U, 0xFCB2U, 0xFCD3U, 0xFCD3U, 0xFCD3U, 0xFCD3U, 0xFCD3U,
    0xFCD3U, 0xFCB2U, 0xFD14U, 0xF3AEU, 0xCA69U, 0xFFFFU, 0xFFFFU, 0xFFFFU, 0xFFFFU, 0xFFFFU, 0xFFFFU, 0xE249U, 0xEA08U, 0xFCD3U, 0xFD14U, 0xFCD3U,
    0xFCB2U, 0xFCB2U, 0xFCB2U, 0xFCD3U, 0xFCF3U, 0xFCF3U, 0xFD75U, 0xC986U, 0xC1E7U, 0xFFFFU, 0xFFFFU, 0xFFFFU, 0xFFFFU, 0xFFFFU, 0xFFFFU, 0xE208U,
    0xD000U, 0xD8A2U, 0xF32CU, 0xFCF3U, 0xFD34U, 0xFD14U, 0xFD14U, 0xFCD3U, 0xFC51U, 0xFBCFU, 0xFB2CU, 0xB000U, 0xCA49U, 0xFFFFU, 0xFFFFU, 0xFFFFU,
    0xFFFFU, 0xFFFFU, 0xFFFFU, 0xE228U, 0xD800U, 0xD800U, 0xD000U, 0xE145U, 0xFACBU, 0xFA08U, 0xF945U, 0xF8A2U, 0xF841U, 0xF800U, 0xF000U, 0xB000U,
    0xCA49U, 0xFFFFU, 0xFFFFU, 0xFFFFU, 0xFFFFU, 0xFFFFU, 0xFFFFU, 0xE228U, 0xD000U, 0xD820U, 0xD800U, 0xD000U, 0xF800U, 0xF800U, 0xF800U, 0xF800U,
    0xF800U, 0xF800U, 0xF020U, 0xB000U, 0xCA49U, 0xFFFFU, 0xFFFFU, 0xFFFFU, 0xFFFFU, 0xFFFFU, 0xFFFFU, 0xE228U, 0xD000U, 0xD800U, 0xD800U, 0xD800U,
    0xF820U, 0xF800U, 0xF800U, 0xF800U, 0xF800U, 0xF800U, 0xF020U, 0xB000U, 0xCA49U, 0xFFFFU, 0xFFFFU, 0xFFFFU, 0xFFFFU, 0xFFFFU, 0xFFFFU, 0xE228U,
    0xD000U, 0xD800U, 0xD800U, 0xD800U, 0xF800U, 0xF800U, 0xF800U, 0xF800U, 0xF800U, 0xF800U, 0xF020U, 0xB000U, 0xCA49U, 0xFFFFU, 0xFFFFU, 0xFFFFU,
    0xFFFFU, 0xFFFFU, 0xFFFFU, 0xE228U, 0xD000U, 0xD800U, 0xD800U, 0xD800U, 0xF800U, 0xF800U, 0xF800U, 0xF800U, 0xF800U, 0xF800U, 0xF020U, 0xB000U,
    0xCA49U, 0xFFFFU, 0xFFFFU, 0xFFFFU, 0xFFFFU, 0xFFFFU, 0xFFFFU, 0xE228U, 0xD000U, 0xD800U, 0xD800U, 0xD800U, 0xF800U, 0xF800U, 0xF800U, 0xF800U,
    0xF800U, 0xF800U, 0xF020U, 0xB000U, 0xC228U, 0xFFFFU, 0xFFFFU, 0xFFFFU, 0xFFFFU, 0xFFFFU, 0xFFFFU, 0xE228U, 0xD000U, 0xD800U, 0xD800U, 0xD800U,
    0xF800U, 0xF800U, 0xF800U, 0xF800U, 0xF800U, 0xF800U, 0xF020U, 0xB000U, 0xD36DU, 0xFFFFU, 0xFFDFU, 0xFFFFU, 0xFFFFU, 0xFFFFU, 0xFFFFU, 0xE1C7U,
    0xD000U, 0xD820U, 0xD800U, 0xD800U, 0xF800U, 0xF800U, 0xF800U, 0xF800U, 0xF800U, 0xF800U, 0xF000U, 0xB020U, 0xF6FBU, 0xFFFFU, 0xFFFFU, 0xFFFFU,
    0xFFFFU, 0xFFFFU, 0xFFFFU, 0xF534U, 0xD8C3U, 0xD000U, 0xD800U, 0xD820U, 0xF800U, 0xF800U, 0xF800U, 0xF820U, 0xF820U, 0xF820U, 0xF000U, 0xD2CBU,
    0xFFFFU, 0xFFFFU, 0xFFFFU, 0xFFFFU, 0xFFFFU, 0xFFFFU, 0xFFFFU, 0xFFFFU, 0xFF5DU, 0xEB8EU, 0xD820U, 0xD000U, 0xF800U, 0xF800U, 0xF800U, 0xF800U,
    0xF800U, 0xF800U, 0xF020U, 0xF679U, 0xFFFFU, 0xFFFFU, 0xFFFFU, 0xFFFFU, 0xFFFFU, 0xFFFFU, 0xFFFFU, 0xFFFFU, 0xFFFFU, 0xFFFFU, 0xFE9AU, 0xE28AU,
    0xF082U, 0xF924U, 0xFA28U, 0xFB4DU, 0xFC92U, 0xFDB6U, 0xFEDBU, 0xFFFFU, 0xFFFFU, 0xFFFFU, 0xFFFFU, 0xFFFFU, 0xFFFFU, 0xFFFFU, 0xFFFFU, 0xFFFFU,
    0xFFFFU, 0xFFDFU, 0xFFFFU, 0xFFFFU, 0xFF3CU, 0xFFDFU, 0xFFFFU, 0xFFFFU, 0xFFFFU, 0xFFFFU, 0xFFFFU, 0xFFFFU, 0xFFFFU, 0xFFFFU, 0xFFFFU, 0xFFFFU,
  },
  {
    0xFFFFU, 0xFFFFU, 0xFFFFU, 0xFFFFU, 0xFFFFU, 0xFFFFU, 0xFFFFU, 0xFFFFU, 0xFFFFU, 0xFFFFU, 0xFFFEU, 0xFFBDU, 0xFFFFU, 0xFFFFU, 0xFFFFU, 0xFFFFU,
    0xFFFFU, 0xFFFFU, 0xFFFFU, 0xFFFFU, 0xFFFFU, 0xFFFFU, 0xFFFFU, 0xFFFFU, 0xFFFFU, 0xFFBCU, 0xFF7AU, 0xFF37U, 0xFEF5U, 0xFEB3U, 0xFE91U, 0xFE70U,
    0xFED4U, 0xFFBCU, 0xFFFFU, 0xFFFFU, 0xFFFFU, 0xFFFFU, 0xFFFFU, 0xFFFFU, 0xFFFFU, 0xFFFFU, 0xFFFFU, 0xFFFFU, 0xFF9BU, 0xFE4FU, 0xFE4FU, 0xFE4EU,
    0xFE4EU, 0xFE4FU, 0xFE4FU, 0xFE6FU, 0xFE4FU, 0xFE6FU, 0xFF16U, 0xFFDEU, 0xFFFFU, 0xFFFFU, 0xFFFFU, 0xFFFFU, 0xFFFFU, 0xFFFFU, 0xFFFFU, 0xFFFFU,
    0xFED4U, 0xFE4FU, 0xFE70U, 0xFE70U, 0xFE70U, 0xFE70U, 0xFE70U, 0xFE70U, 0xFE70U, 0xFE70U, 0xFE4EU, 0xFE71U, 0xFF7AU, 0xFFFFU, 0xFFFFU, 0xFFFFU,
    0xFFFFU, 0xFFFFU, 0xFFFFU, 0xFFBCU, 0xFE4FU, 0xFE70U, 0xFE70U, 0xFE70U, 0xFE70U, 0xFE70U, 0xFE70U, 0xFE70U, 0xFE70U, 0xFE70U, 0xFE70U, 0xFE2EU,
    0xEDCFU, 0xFFFFU, 0xFFFFU, 0xFFFFU, 0xFFFFU, 0xFFFFU, 0xFFFFU, 0xFED4U, 0xFE6FU, 0xFE70U, 0xFE4FU, 0xFE70U, 0xFE70U, 0xFE70U, 0xFE70U, 0xFE70U,
    0xFE6FU, 0xFE4FU, 0xFE90U, 0xF58BU, 0xDCEAU, 0xFFFFU, 0xFFFFU, 0xFFFFU, 0xFFFFU, 0xFFFFU, 0xFFFFU, 0xECE7U, 0xF507U, 0xFE70U, 0xFE91U, 0xFE4FU,
    0xFE4FU, 0xFE4FU, 0xFE4FU, 0xFE70U, 0xFE70U, 0xFE70U, 0xFEB2U, 0xDC43U, 0xDCC9U, 0xFFFFU, 0xFFFFU, 0xFFFFU, 0xFFFFU, 0xFFFFU, 0xFFFFU, 0xECC7U,
    0xE380U, 0xEC42U, 0xF58BU, 0xFE70U, 0xFE91U, 0xFE91U, 0xFE70U, 0xFE4FU, 0xFE2EU, 0xFE0CU, 0xFD8AU, 0xCB40U, 0xDCEAU, 0xFFFFU, 0xFFFFU, 0xFFFFU,
    0xFFFFU, 0xFFFFU, 0xFFFFU, 0xECC7U, 0xE3C0U, 0xE3E0U, 0xE3C0U, 0xECA4U, 0xFD89U, 0xFD26U, 0xFCE4U, 0xFCA2U, 0xFC60U, 0xFC40U, 0xFC20U, 0xCB20U,
    0xDD0AU, 0xFFFFU, 0xFFFFU, 0xFFFFU, 0xFFFFU, 0xFFFFU, 0xFFFFU, 0xECC7U, 0xE3C0U, 0xE400U, 0xE3E0U, 0xE3C0U, 0xFC20U, 0xFC40U, 0xFC40U, 0xFC40U,
    0xFC40U, 0xFC60U, 0xFC61U, 0xCB20U, 0xDD0AU, 0xFFFFU, 0xFFFFU, 0xFFFFU, 0xFFFFU, 0xFFFFU, 0xFFFFU, 0xECC7U, 0xE3C0U, 0xE3E0U, 0xE3E0U, 0xE400U,
    0xFC60U, 0xFC60U, 0xFC60U, 0xFC60U, 0xFC60U, 0xFC60U, 0xFC40U, 0xCB20U, 0xDD0AU, 0xFFFFU, 0xFFFFU, 0xFFFFU, 0xFFFFU, 0xFFFFU, 0xFFFFU, 0xECC7U,
    0xE3C0U, 0xE3E0U, 0xE3E0U, 0xE3E0U, 0xFC40U, 0xFC60U, 0xFC60U, 0xFC60U, 0xFC60U, 0xFC60U, 0xFC40U, 0xCB20U, 0xDD0AU, 0xFFFFU, 0xFFFFU, 0xFFFFU,
    0xFFFFU, 0xFFFFU, 0xFFFFU, 0xECC7U, 0xE3C0U, 0xE3E0U, 0xE3E0U, 0xE3E0U, 0xFC40U, 0xFC60U, 0xFC60U, 0xFC60U, 0xFC60U, 0xFC60U, 0xFC40U, 0xCB20U,
    0xDD0AU, 0xFFFFU, 0xFFFFU, 0xFFFFU, 0xFFFFU, 0xFFFFU, 0xFFFFU, 0xECC7U, 0xE3C0U, 0xE3E0U, 0xE3E0U, 0xE3E0U, 0xFC40U, 0xFC60U, 0xFC60U, 0xFC60U,
    0xFC60U, 0xFC60U, 0xFC40U, 0xCB20U, 0xDCEAU, 0xFFFFU, 0xFFFFU, 0xFFFFU, 0xFFFFU, 0xFFFFU, 0xFFFFU, 0xECE7U, 0xE3C0U, 0xE3E0U, 0xE3E0U, 0xE3E0U,
    0xFC40U, 0xFC60U, 0xFC60U, 0xFC60U, 0xFC60U, 0xFC60U, 0xFC40U, 0xCB20U, 0xE5AFU, 0xFFFFU, 0xFFFFU, 0xFFFFU, 0xFFFFU, 0xFFFFU, 0xFFFFU, 0xECA5U,
    0xE3A0U, 0xE400U, 0xE3E0U, 0xE3E0U, 0xFC40U, 0xFC60U, 0xFC60U, 0xFC60U, 0xFC60U, 0xFC60U, 0xF420U, 0xCBA1U, 0xFF9CU, 0xFFFFU, 0xFFFFU, 0xFFFFU,
    0xFFFFU, 0xFFFFU, 0xFFFFU, 0xF673U, 0xE422U, 0xE3A0U, 0xE3E0U, 0xE400U, 0xFC40U, 0xFC60U, 0xFC60U, 0xFC60U, 0xFC60U, 0xFC80U, 0xF3E0U, 0xE54DU,
    0xFFFFU, 0xFFFFU, 0xFFFFU, 0xFFFFU, 0xFFFFU, 0xFFFFU, 0xFFFFU, 0xFFFFU, 0xFF9CU, 0xF58DU, 0xE3E0U, 0xE3A0U, 0xFC40U, 0xFC40U, 0xFC20U, 0xFC20U,
    0xFC00U, 0xFC20U, 0xFC41U, 0xF75BU, 0xFFFFU, 0xFFFFU, 0xFFFFU, 0xFFFFU, 0xFFFFU, 0xFFFFU, 0xFFFFU, 0xFFFFU, 0xFFFFU, 0xFFFFU, 0xFF39U, 0xED09U,
    0xFC62U, 0xFCE5U, 0xFD49U, 0xFDEDU, 0xFE72U, 0xFEF6U, 0xFF7BU, 0xFFFFU, 0xFFFFU, 0xFFFFU, 0xFFFFU, 0xFFFFU, 0xFFFFU, 0xFFFFU, 0xFFFFU, 0xFFFFU,
    0xFFFFU, 0xFFFFU, 0xFFFFU, 0xFFFFU, 0xFF9CU, 0xFFFFU, 0xFFFFU, 0xFFFFU, 0xFFFFU, 0xFFFFU, 0xFFFFU, 0xFFFFU, 0xFFFFU, 0xFFFFU, 0xFFFFU, 0xFFFFU,
  },
  {
    0xFFFFU, 0xFFFFU, 0xFFFFU, 0xFFFFU, 0xFFFFU, 0xFFFFU, 0xFFFFU, 0xFFFFU, 0xFFFFU, 0xFFFFU, 0xFFFFU, 0xFFFEU, 0xFFFFU, 0xFFFFU, 0xFFFFU, 0xFFFFU,
    0xFFFFU, 0xFFFFU, 0xFFFFU, 0xFFFFU, 0xFFFFU, 0xFFFFU, 0xFFFFU, 0xFFFFU, 0xFFFFU, 0xFFFDU, 0xFFFBU, 0xFFF9U, 0xFFF7U, 0xFFF6U, 0xFFF4U, 0xFFF3U,
    0xFFF6U, 0xFFFDU, 0xFFFFU, 0xFFFFU, 0xFFFFU, 0xFFFFU, 0xFFFFU, 0xFFFFU, 0xFFFFU, 0xFFFFU, 0xFFFFU, 0xFFFFU, 0xFFFDU, 0xFFF2U, 0xFFF2U, 0xFFF2U,
    0xFFF2U, 0xFFF2U, 0xFFF2U, 0xFFF3U, 0xFFF2U, 0xFFF2U, 0xFFF8U, 0xFFFEU, 0xFFFFU, 0xFFFFU, 0xFFFFU, 0xFFFFU, 0xFFFFU, 0xFFFFU, 0xFFFFU, 0xFFFFU,
    0xFFF7U, 0xFFF2U, 0xFFF3U, 0xFFF3U, 0xFFF3U, 0xFFF3U, 0xFFF3U, 0xFFF3U, 0xFFF3U, 0xFFF3U, 0xFFF2U, 0xFFF3U, 0xFFFBU, 0xFFFFU, 0xFFFFU, 0xFFFFU,
    0xFFFFU, 0xFFFFU, 0xFFFFU, 0xFFFDU, 0xFFF2U, 0xFFF3U, 0xFFF3U, 0xFFF3U, 0xFFF3U, 0xFFF3U, 0xFFF3U, 0xFFF3U, 0xFFF3U, 0xFFF3U, 0xFFF3U, 0xFFF2U,
    0xEEEFU, 0xFFFFU, 0xFFFFU, 0xFFFFU, 0xFFFFU, 0xFFFFU, 0xFFFFU, 0xFFD7U, 0xFFF3U, 0xFFF3U, 0xFFF2U, 0xFFF3U, 0xFFF3U, 0xFFF3U, 0xFFF3U, 0xFFF3U,
    0xFFF3U, 0xFFF2U, 0xFFF4U, 0xF76EU, 0xDDE9U, 0xFFFFU, 0xFFFFU, 0xFFFFU, 0xFFFFU, 0xFFFFU, 0xFFFFU, 0xEE89U, 0xF6C8U, 0xFFF3U, 0xFFF4U, 0xFFF3U,
    0xFFF2U, 0xFFF2U, 0xFFF2U, 0xFFF3U, 0xFFF3U, 0xFFF3U, 0xFFF5U, 0xDE26U, 0xD5A7U, 0xFFFFU, 0xFFFFU, 0xFFFFU, 0xFFFFU, 0xFFFFU, 0xFFFFU, 0xEE68U,
    0xE580U, 0xE622U, 0xF72CU, 0xFFF3U, 0xFFF4U, 0xFFF4U, 0xFFF4U, 0xFFF3U, 0xFFD1U, 0xFFAFU, 0xFF6CU, 0xCD00U, 0xDDC9U, 0xFFFFU, 0xFFFFU, 0xFFFFU,
    0xFFFFU, 0xFFFFU, 0xFFFFU, 0xEE68U, 0xE5C0U, 0xE5C0U, 0xE5C0U, 0xEE65U, 0xFF4BU, 0xFF48U, 0xFF05U, 0xFEE3U, 0xFEC1U, 0xFEA0U, 0xFE60U, 0xC4E0U,
    0xDDE9U, 0xFFFFU, 0xFFFFU, 0xFFFFU, 0xFFFFU, 0xFFFFU, 0xFFFFU, 0xEE68U, 0xE5C0U, 0xE5E0U, 0xE5E0U, 0xE5C0U, 0xFE60U, 0xFEA0U, 0xFEA0U, 0xFEA0U,
    0xFEA0U, 0xFEC0U, 0xFE80U, 0xC4E0U, 0xDDE9U, 0xFFFFU, 0xFFFFU, 0xFFFFU, 0xFFFFU, 0xFFFFU, 0xFFFFU, 0xEE68U, 0xE5C0U, 0xE5E0U, 0xE5E0U, 0xE5E0U,
    0xFE80U, 0xFEC0U, 0xFEA0U, 0xFEA0U, 0xFEA0U, 0xFEC0U, 0xFE80U, 0xC4E0U, 0xDDE9U, 0xFFFFU, 0xFFFFU, 0xFFFFU, 0xFFFFU, 0xFFFFU, 0xFFFFU, 0xEE68U,
    0xE5C0U, 0xE5E0U, 0xE5E0U, 0xE5E0U, 0xFE80U, 0xFEC0U, 0xFEA0U, 0xFEA0U, 0xFEA0U, 0xFEC0U, 0xFE80U, 0xC4E0U, 0xDDE9U, 0xFFFFU, 0xFFFFU, 0xFFFFU,
    0xFFFFU, 0xFFFFU, 0xFFFFU, 0xEE68U, 0xE5C0U, 0xE5E0U, 0xE5E0U, 0xE5E0U, 0xFE80U, 0xFEC0U, 0xFEA0U, 0xFEA0U, 0xFEA0U, 0xFEC0U, 0xFE80U, 0xC4E0U,
    0xDDE9U, 0xFFFFU, 0xFFFFU, 0xFFFFU, 0xFFFFU, 0xFFFFU, 0xFFFFU, 0xEE68U, 0xE5C0U, 0xE5E0U, 0xE5E0U, 0xE5E0U, 0xFE80U, 0xFEC0U, 0xFEA0U, 0xFEA0U,
    0xFEA0U, 0xFEC0U, 0xFE80U, 0xC4E0U, 0xD5C8U, 0xFFFFU, 0xFFFFU, 0xFFFFU, 0xFFFFU, 0xFFFFU, 0xFFFFU, 0xEE68U, 0xE5C0U, 0xE5E0U, 0xE5E0U, 0xE5E0U,
    0xFE80U, 0xFEC0U, 0xFEA0U, 0xFEA0U, 0xFEA0U, 0xFEC0U, 0xFE80U, 0xC4E0U, 0xE64DU, 0xFFFFU, 0xFFFFU, 0xFFFFU, 0xFFFFU, 0xFFFFU, 0xFFFFU, 0xEE47U,
    0xE5A0U, 0xE5E0U, 0xE5E0U, 0xE5E0U, 0xFE80U, 0xFEC0U, 0xFEA0U, 0xFEA0U, 0xFEA0U, 0xFEC0U, 0xFE80U, 0xCD20U, 0xF79BU, 0xFFFFU, 0xFFFFU, 0xFFFFU,
    0xFFFFU, 0xFFFFU, 0xFFFFU, 0xF734U, 0xE603U, 0xE5A0U, 0xE5E0U, 0xE5E0U, 0xFE80U, 0xFEC0U, 0xFEA0U, 0xFEC0U, 0xFEC0U, 0xFEC0U, 0xF640U, 0xDE2BU,
    0xFFFFU, 0xFFFFU, 0xFFFFU, 0xFFFFU, 0xFFFFU, 0xFFFFU, 0xFFFFU, 0xFFFFU, 0xFFDDU, 0xF6CEU, 0xE5E0U, 0xE5C0U, 0xFE80U, 0xFEA0U, 0xFEA0U, 0xFEA0U,
    0xFEA0U, 0xFEA0U, 0xFE80U, 0xF779U, 0xFFFFU, 0xFFFFU, 0xFFFFU, 0xFFFFU, 0xFFFFU, 0xFFFFU, 0xFFFFU, 0xFFFFU, 0xFFFFU, 0xFFFFU, 0xFF9AU, 0xEE6AU,
    0xFE82U, 0xFEE4U, 0xFF08U, 0xFF2DU, 0xFF71U, 0xFF96U, 0xFFDBU, 0xFFFFU, 0xFFFFU, 0xFFFFU, 0xFFFFU, 0xFFFFU, 0xFFFFU, 0xFFFFU, 0xFFFFU, 0xFFFFU,
    0xFFFFU, 0xFFFFU, 0xFFFFU, 0xFFFFU, 0xFFDCU, 0xFFFFU, 0xFFFFU, 0xFFFFU, 0xFFFFU, 0xFFFFU, 0xFFFFU, 0xFFFFU, 0xFFFFU, 0xFFFFU, 0xFFFFU, 0xFFFFU,
  },
  {
    0xFFFFU, 0xFFFFU, 0xFFFFU, 0xFFFFU, 0xFFFFU, 0xFFFFU, 0xFFFFU, 0xFFFFU, 0xFFFFU, 0xFFFFU, 0xFFFFU, 0xF7FEU, 0xFFFFU, 0xFFFFU, 0xFFFFU, 0xFFFFU,
    0xFFFFU, 0xFFFFU, 0xFFFFU, 0xFFFFU, 0xFFFFU, 0xFFFFU, 0xFFFFU, 0xFFFFU, 0xFFFFU, 0xEFFDU, 0xDFFBU, 0xCFF9U, 0xBFF7U, 0xAFF5U, 0xA7F4U, 0x9FF3U,
    0xB7F6U, 0xEFFDU, 0xFFFFU, 0xFFFFU, 0xFFFFU, 0xFFFFU, 0xFFFFU, 0xFFFFU, 0xFFFFU, 0xFFFFU, 0xFFFFU, 0xFFFFU, 0xE7FCU, 0x97F2U, 0x97F2U, 0x97F2U,
    0x97F2U, 0x97F2U, 0x97F2U, 0x9FF3U, 0x97F2U, 0x9FF3U, 0xC7F8U, 0xF7FEU, 0xFFFFU, 0xFFFFU, 0xFFFFU, 0xFFFFU, 0xFFFFU, 0xFFFFU, 0xFFFFU, 0xFFFFU,
    0xB7F6U, 0x97F2U, 0x9FF3U, 0x9FF3U, 0x9FF3U, 0x9FF3U, 0x9FF3U, 0x9FF3U, 0x9FF3U, 0x9FF3U, 0x97F2U, 0xA7F4U, 0xDFFBU, 0xFFFFU, 0xFFFFU, 0xFFFFU,
    0xFFFFU, 0xFFFFU, 0xFFFFU, 0xEFFDU, 0x97F2U, 0x9FF3U, 0x9FF3U, 0x9FF3U, 0x9FF3U, 0x9FF3U, 0x9FF3U, 0x9FF3U, 0x9FF3U, 0x9FF3U, 0x9FF3U, 0x8FF1U,
    0x86F0U, 0xFFFFU, 0xFFFFU, 0xFFFFU, 0xFFFFU, 0xFFFFU, 0xFFFFU, 0xB7D6U, 0x9FF3U, 0x9FF3U, 0x97F2U, 0x9FF3U, 0x9FF3U, 0x9FF3U, 0x9FF3U, 0x9FF3U,
    0x9FF3U, 0x97F2U, 0xA7F4U, 0x6F2DU, 0x55CAU, 0xFFFFU, 0xFFFFU, 0xFFFFU, 0xFFFFU, 0xFFFFU, 0xFFFFU, 0x3E27U, 0x4EA9U, 0x9FF3U, 0xA7F4U, 0x9FF3U,
    0x97F2U, 0x97F2U, 0x9FF3U, 0x9FF3U, 0x9FF3U, 0x9FF3U, 0xAFF5U, 0x2DC5U, 0x4DA9U, 0xFFFFU, 0xFFFFU, 0xFFFFU, 0xFFFFU, 0xFFFFU, 0xFFFFU, 0x3606U,
    0x0540U, 0x1DE3U, 0x6F2DU, 0x9FF3U, 0xA7F4U, 0xA7F4U, 0xA7F4U, 0x97F2U, 0x8FD1U, 0x7FAFU, 0x672CU, 0x04A0U, 0x55CAU, 0xFFFFU, 0xFFFFU, 0xFFFFU,
    0xFFFFU, 0xFFFFU, 0xFFFFU, 0x3E07U, 0x0560U, 0x0580U, 0x0560U, 0x2E45U, 0x5F2BU, 0x4708U, 0x2EC5U, 0x1682U, 0x0660U, 0x0660U, 0x0600U, 0x0480U,
    0x55CAU, 0xFFFFU, 0xFFFFU, 0xFFFFU, 0xFFFFU, 0xFFFFU, 0xFFFFU, 0x3E07U, 0x0560U, 0x05A0U, 0x0580U, 0x0560U, 0x0620U, 0x0640U, 0x0640U, 0x0640U,
    0x0660U, 0x0660U, 0x0E21U, 0x0480U, 0x55CAU, 0xFFFFU, 0xFFFFU, 0xFFFFU, 0xFFFFU, 0xFFFFU, 0xFFFFU, 0x3E07U, 0x0560U, 0x0580U, 0x0580U, 0x0580U,
    0x0640U, 0x0660U, 0x0660U, 0x0660U, 0x0660U, 0x0660U, 0x0620U, 0x0480U, 0x55CAU, 0xFFFFU, 0xFFFFU, 0xFFFFU, 0xFFFFU, 0xFFFFU, 0xFFFFU, 0x3E07U,
    0x0560U, 0x0580U, 0x0580U, 0x0580U, 0x0640U, 0x0660U, 0x0660U, 0x0660U, 0x0660U, 0x0660U, 0x0620U, 0x0480U, 0x55CAU, 0xFFFFU, 0xFFFFU, 0xFFFFU,
    0xFFFFU, 0xFFFFU, 0xFFFFU, 0x3E07U, 0x0560U, 0x0580U, 0x0580U, 0x0580U, 0x0640U, 0x0660U, 0x0660U, 0x0660U, 0x0660U, 0x0660U, 0x0620U, 0x0480U,
    0x55CAU, 0xFFFFU, 0xFFFFU, 0xFFFFU, 0xFFFFU, 0xFFFFU, 0xFFFFU, 0x3E07U, 0x0560U, 0x0580U, 0x0580U, 0x0580U, 0x0640U, 0x0660U, 0x0660U, 0x0660U,
    0x0660U, 0x0660U, 0x0620U, 0x0480U, 0x55CAU, 0xFFFFU, 0xFFFFU, 0xFFFFU, 0xFFFFU, 0xFFFFU, 0xFFFFU, 0x3E27U, 0x0560U, 0x0580U, 0x0580U, 0x0580U,
    0x0640U, 0x0660U, 0x0660U, 0x0660U, 0x0660U, 0x0660U, 0x0620U, 0x0480U, 0x7E4FU, 0xFFFFU, 0xFFFFU, 0xFFFFU, 0xFFFFU, 0xFFFFU, 0xFFFFU, 0x2DE5U,
    0x0560U, 0x05A0U, 0x0580U, 0x0580U, 0x0640U, 0x0660U, 0x0660U, 0x0660U, 0x0660U, 0x0660U, 0x0600U, 0x0CE1U, 0xE7BCU, 0xFFFFU, 0xFFFFU, 0xFFFFU,
    0xFFFFU, 0xFFFFU, 0xFFFFU, 0x9F13U, 0x15A2U, 0x0560U, 0x0580U, 0x0580U, 0x0640U, 0x0660U, 0x0660U, 0x0660U, 0x0660U, 0x0680U, 0x05E0U, 0x6E0DU,
    0xFFFFU, 0xFFFFU, 0xFFFFU, 0xFFFFU, 0xFFFFU, 0xFFFFU, 0xFFFFU, 0xFFFFU, 0xE7DCU, 0x6E8DU, 0x0580U, 0x0560U, 0x0640U, 0x0640U, 0x0640U, 0x0640U,
    0x0640U, 0x0640U, 0x0E21U, 0xDF7BU, 0xFFFFU, 0xFFFFU, 0xFFFFU, 0xFFFFU, 0xFFFFU, 0xFFFFU, 0xFFFFU, 0xFFFFU, 0xFFFFU, 0xFFFFU, 0xCF79U, 0x4E29U,
    0x1642U, 0x26A4U, 0x46C8U, 0x6F0DU, 0x9752U, 0xB796U, 0xDFDBU, 0xFFFFU, 0xFFFFU, 0xFFFFU, 0xFFFFU, 0xFFFFU, 0xFFFFU, 0xFFFFU, 0xFFFFU, 0xFFFFU,
    0xFFFFU, 0xFFFFU, 0xFFFFU, 0xFFFFU, 0xE7DCU, 0xFFFFU, 0xFFFFU, 0xFFFFU, 0xFFFFU, 0xFFFFU, 0xFFFFU, 0xFFFFU, 0xFFFFU, 0xFFFFU, 0xFFFFU, 0xFFFFU,
  },
  {
    0xFFFFU, 0xFFFFU, 0xFFFFU, 0xFFFFU, 0xFFFFU, 0xFFFFU, 0xFFFFU, 0xFFFFU, 0xFFFFU, 0xFFFFU, 0xFFFFU, 0xF7FFU, 0xFFFFU, 0xFFFFU, 0xFFFFU, 0xFFFFU,
    0xFFFFU, 0xFFFFU, 0xFFFFU, 0xFFFFU, 0xFFFFU, 0xFFFFU, 0xFFFFU, 0xFFFFU, 0xFFFFU, 0xEFFFU, 0xDFFFU, 0xCFFFU, 0xBFFFU, 0xB7FFU, 0xA7FFU, 0x9FFFU,
    0xB7FFU, 0xEFFFU, 0xFFFFU, 0xFFFFU, 0xFFFFU, 0xFFFFU, 0xFFFFU, 0xFFFFU, 0xFFFFU, 0xFFFFU, 0xFFFFU, 0xFFFFU, 0xE7FFU, 0x97FFU, 0x97FFU, 0x97FFU,
    0x97FFU, 0x97FFU, 0x97FFU, 0x9FFFU, 0x97FFU, 0x97FFU, 0xC7FFU, 0xF7FFU, 0xFFFFU, 0xFFFFU, 0xFFFFU, 0xFFFFU, 0xFFFFU, 0xFFFFU, 0xFFFFU, 0xFFFFU,
    0xBFFFU, 0x97FFU, 0x9FFFU, 0x9FFFU, 0x9FFFU, 0x9FFFU, 0x9FFFU, 0x9FFFU, 0x9FFFU, 0x9FFFU, 0x97FFU, 0x9FFFU, 0xDFFFU, 0xFFFFU, 0xFFFFU, 0xFFFFU,
    0xFFFFU, 0xFFFFU, 0xFFFFU, 0xEFFFU, 0x97FFU, 0x9FFFU, 0x9FFFU, 0x9FFFU, 0x9FFFU, 0x9FFFU, 0x9FFFU, 0x9FFFU, 0x9FFFU, 0x9FFFU, 0x9FFFU, 0x97FFU,
    0x7EDBU, 0xFFFFU, 0xFFFFU, 0xFFFFU, 0xFFFFU, 0xFFFFU, 0xFFFFU, 0xBFDFU, 0x9FFFU, 0x9FFFU, 0x97FFU, 0x9FFFU, 0x9FFFU, 0x9FFFU, 0x9FFFU, 0x9FFFU,
    0x9FFFU, 0x97FFU, 0xA7FFU, 0x775DU, 0x4DB6U, 0xFFFFU, 0xFFFFU, 0xFFFFU, 0xFFFFU, 0xFFFFU, 0xFFFFU, 0x4E59U, 0x469AU, 0x9FDFU, 0xA7FFU, 0x9FFFU,
    0x97FFU, 0x97FFU, 0x97FFU, 0x9FFFU, 0x9FFFU, 0x9FFFU, 0xAFFFU, 0x35F7U, 0x3D75U, 0xFFFFU, 0xFFFFU, 0xFFFFU, 0xFFFFU, 0xFFFFU, 0xFFFFU, 0x4638U,
    0x0555U, 0x15F7U, 0x671CU, 0x9FFFU, 0xA7FFU, 0xA7FFU, 0xA7FFU, 0x9FFFU, 0x8FDFU, 0x7FBEU, 0x675DU, 0x04D3U, 0x4DB6U, 0xFFFFU, 0xFFFFU, 0xFFFFU,
    0xFFFFU, 0xFFFFU, 0xFFFFU, 0x4638U, 0x0575U, 0x0596U, 0x0575U, 0x2E38U, 0x5F3CU, 0x471CU, 0x2EDBU, 0x1E9AU, 0x0E79U, 0x0679U, 0x0638U, 0x04B2U,
    0x4DB6U, 0xFFFFU, 0xFFFFU, 0xFFFFU, 0xFFFFU, 0xFFFFU, 0xFFFFU, 0x4638U, 0x0575U, 0x05B6U, 0x0596U, 0x0575U, 0x0618U, 0x0659U, 0x0659U, 0x0659U,
    0x0659U, 0x0679U, 0x0659U, 0x04B2U, 0x4DB6U, 0xFFFFU, 0xFFFFU, 0xFFFFU, 0xFFFFU, 0xFFFFU, 0xFFFFU, 0x4638U, 0x0575U, 0x0596U, 0x0596U, 0x0596U,
    0x0659U, 0x0679U, 0x0679U, 0x0679U, 0x0679U, 0x0679U, 0x0659U, 0x04B2U, 0x4DB6U, 0xFFFFU, 0xFFFFU, 0xFFFFU, 0xFFFFU, 0xFFFFU, 0xFFFFU, 0x4638U,
    0x0575U, 0x0596U, 0x0596U, 0x0596U, 0x0638U, 0x0679U, 0x0679U, 0x0679U, 0x0679U, 0x0679U, 0x0659U, 0x04B2U, 0x4DB6U, 0xFFFFU, 0xFFFFU, 0xFFFFU,
    0xFFFFU, 0xFFFFU, 0xFFFFU, 0x4638U, 0x0575U, 0x0596U, 0x0596U, 0x0596U, 0x0638U, 0x0679U, 0x0679U, 0x0679U, 0x0679U, 0x0679U, 0x0659U, 0x04B2U,
    0x4DB6U, 0xFFFFU, 0xFFFFU, 0xFFFFU, 0xFFFFU, 0xFFFFU, 0xFFFFU, 0x4638U, 0x0575U, 0x0596U, 0x0596U, 0x0596U, 0x0638U, 0x0679U, 0x0679U, 0x0679U,
    0x0679U, 0x0679U, 0x0659U, 0x04B2U, 0x45B6U, 0xFFFFU, 0xFFFFU, 0xFFFFU, 0xFFFFU, 0xFFFFU, 0xFFFFU, 0x4638U, 0x0575U, 0x0596U, 0x0596U, 0x0596U,
    0x0638U, 0x0679U, 0x0679U, 0x0679U, 0x0679U, 0x0679U, 0x0659U, 0x0492U, 0x6E38U, 0xFFFFU, 0xFFFFU, 0xFFFFU, 0xFFFFU, 0xFFFFU, 0xFFFFU, 0x3E18U,
    0x0575U, 0x05B6U, 0x0596U, 0x0596U, 0x0638U, 0x0679U, 0x0679U, 0x0679U, 0x0679U, 0x0679U, 0x0638U, 0x04D3U, 0xDF9EU, 0xFFFFU, 0xFFFFU, 0xFFFFU,
    0xFFFFU, 0xFFFFU, 0xFFFFU, 0xA71CU, 0x1DB6U, 0x0575U, 0x0596U, 0x0596U, 0x0638U, 0x0679U, 0x0679U, 0x0679U, 0x0679U, 0x069AU, 0x05F7U, 0x5DF7U,
    0xFFFFU, 0xFFFFU, 0xFFFFU, 0xFFFFU, 0xFFFFU, 0xFFFFU, 0xFFFFU, 0xFFFFU, 0xEFDFU, 0x769AU, 0x0596U, 0x0575U, 0x0638U, 0x0659U, 0x0659U, 0x0659U,
    0x0659U, 0x0659U, 0x0638U, 0xCF7DU, 0xFFFFU, 0xFFFFU, 0xFFFFU, 0xFFFFU, 0xFFFFU, 0xFFFFU, 0xFFFFU, 0xFFFFU, 0xFFFFU, 0xFFFFU, 0xD79EU, 0x5659U,
    0x1659U, 0x26BAU, 0x46DBU, 0x6F1CU, 0x8F5DU, 0xB77DU, 0xDFDFU, 0xFFFFU, 0xFFFFU, 0xFFFFU, 0xFFFFU, 0xFFFFU, 0xFFFFU, 0xFFFFU, 0xFFFFU, 0xFFFFU,
    0xFFFFU, 0xFFFFU, 0xFFFFU, 0xFFFFU, 0xE7DFU, 0xFFFFU, 0xFFFFU, 0xFFFFU, 0xFFFFU, 0xFFFFU, 0xFFFFU, 0xFFFFU, 0xFFFFU, 0xFFFFU, 0xFFFFU, 0xFFFFU,
  },
  {
    0xFFFFU, 0xFFFFU, 0xFFFFU, 0xFFFFU, 0xFFFFU, 0xFFFFU, 0xFFFFU, 0xFFFFU, 0xFFFFU, 0xFFFFU, 0xFFDFU, 0xF7BFU, 0xFFFFU, 0xFFFFU, 0xFFFFU, 0xFFFFU,
    0xFFFFU, 0xFFFFU, 0xFFFFU, 0xFFFFU, 0xFFFFU, 0xFFFFU, 0xFFFFU, 0xFFFFU, 0xFFFFU, 0xEF9FU, 0xDF3FU, 0xCEFFU, 0xBE9FU, 0xAE5FU, 0xA61FU, 0x9DFFU,
    0xBE9FU, 0xEFBFU, 0xFFFFU, 0xFFFFU, 0xFFFFU, 0xFFFFU, 0xFFFFU, 0xFFFFU, 0xFFFFU, 0xFFFFU, 0xFFFFU, 0xFFFFU, 0xDF5FU, 0x95BFU, 0x95BFU, 0x95BFU,
    0x95BFU, 0x95DFU, 0x95DFU, 0x9DDFU, 0x95BFU, 0x9DDFU, 0xC6DFU, 0xFFDFU, 0xFFFFU, 0xFFFFU, 0xFFFFU, 0xFFFFU, 0xFFFFU, 0xFFFFU, 0xFFFFU, 0xFFFFU,
    0xB65FU, 0x95DFU, 0x9DFFU, 0x9DFFU, 0x9DFFU, 0x9DFFU, 0x9DDFU, 0x9DDFU, 0x9DFFU, 0x9DDFU, 0x95BFU, 0xA61FU, 0xDF5FU, 0xFFFFU, 0xFFFFU, 0xFFFFU,
    0xFFFFU, 0xFFFFU, 0xFFFFU, 0xE77FU, 0x95BFU, 0x9DDFU, 0x9DDFU, 0x9DDFU, 0x9DDFU, 0x9DDFU, 0x9DDFU, 0x9DDFU, 0x9DDFU, 0x9DDFU, 0x9DFFU, 0x8D9FU,
    0x8D5DU, 0xFFFFU, 0xFFFFU, 0xFFFFU, 0xFFFFU, 0xFFFFU, 0xFFFFU, 0xAE5FU, 0x9DFFU, 0x9DFFU, 0x95DFU, 0x9DDFU, 0x9DDFU, 0x9DDFU, 0x9DDFU, 0x9DDFU,
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
