ZLK-AllStar/2026GongChuang/Core/Inc/usart.h

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
/* Define to prevent recursive inclusion -------------------------------------*/
#ifndef __USART_H__
#define __USART_H__

#ifdef __cplusplus
extern "C" {
#endif

/* Includes ------------------------------------------------------------------*/
#include "main.h"

/* USER CODE BEGIN Includes */

 #include <stdbool.h>
 
/* USER CODE END Includes */

extern UART_HandleTypeDef huart5;

extern UART_HandleTypeDef huart1;

extern UART_HandleTypeDef huart2;

extern UART_HandleTypeDef huart3;

/* USER CODE BEGIN Private defines */

 #define CMD_LEN 255
 #define UART_RX_QUEUE_DEPTH 8
 
 extern __IO bool rxFrameFlag;
 extern __IO uint8_t rxCmd[CMD_LEN];
 extern __IO uint8_t rxCount;
 extern __IO uint8_t rxDmaBuffer[CMD_LEN];
 
/* USER CODE END Private defines */

void MX_UART5_Init(void);
void MX_USART1_UART_Init(void);
void MX_USART2_UART_Init(void);
void MX_USART3_UART_Init(void);

/* USER CODE BEGIN Prototypes */

void UART_RxQueueReset(void);
bool UART_RxPopFrame(uint32_t timeout_ms);
void UART_RxPushFrameFromIsr(uint16_t count);

/* USER CODE END Prototypes */

#ifdef __cplusplus
}
#endif

#endif /* __USART_H__ */
