ZLK-AllStar/2026GongChuang/(commit log)

2026-11-12 feat: 初始化 2026 工创赛智能分拣系统
    导入 STM32F407 CoreXY 分拣固件、Jetson 视觉上位机、ApusIDE HMI 工程与机械模型；补充 GPL-3.0 许可证和项目 README，排除步进电机参考示例与本地构建产物。
    [1165-B2P-A-1.SLDPRT, Mirror固定电机.SLDPRT, Mirror支座.SLDPRT, Mirror支撑杆.SLDPRT, hezi.SLDPRT, nema17.SLDPRT, rod_x axis_337x8.SLDPRT, rod_y axis_348x8.SLDPRT]
2026-11-12 docs: 修正 README 锚点与仓库结构
    Host 徽章改为指向 Jetson 上位机章节；仓库结构移除未跟踪的 HUATAI.sct，改用 .mxproject。
